kfirmaymon84/KiCadLib/MyLibKiCad/3D/CommonChock1210.step

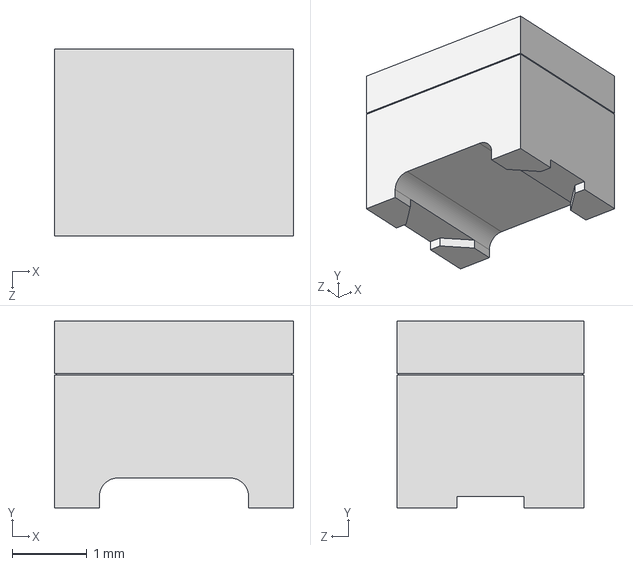
[picture p1: CAD file, 2026-07-02]
MyLibKiCad/3D/CommonChock1210.step
3.20 x 2.50 x 2.50 mm
