kfirmaymon84/KiCadLib/MyLibKiCad/3D/32-VQFN-EP(4x4).step

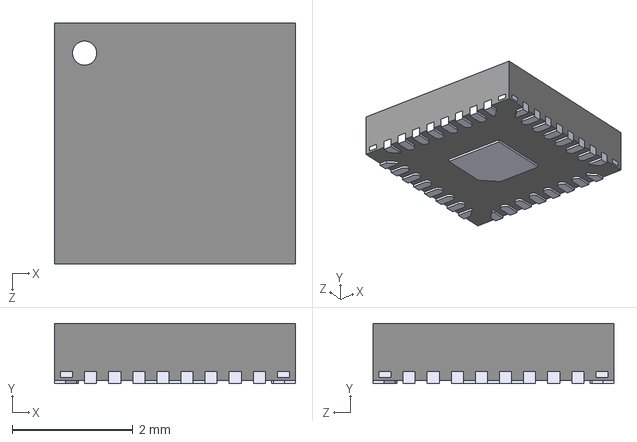
[picture p2: CAD file, 2026-07-02]
MyLibKiCad/3D/32-VQFN-EP(4x4).step
4.00 x 1.00 x 4.00 mm
