kfirmaymon84/KiCadLib/MyLibKiCad/3D/MEM2052-00-195-00-A_revA.STEP

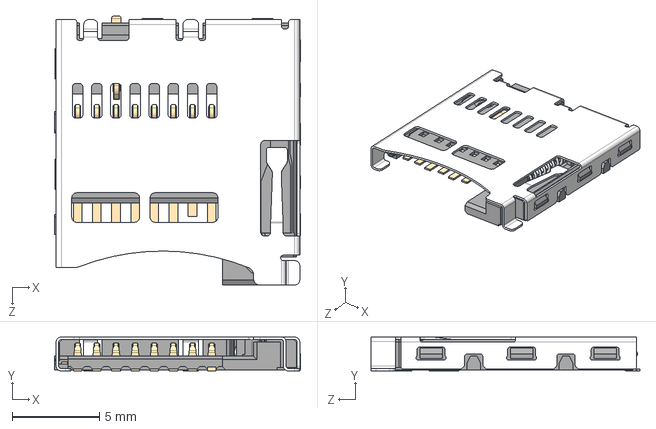
[picture p3: CAD file, 2026-07-02]
MyLibKiCad/3D/MEM2052-00-195-00-A_revA.STEP
14.2 x 1.95 x 15.5 mm
