kfirmaymon84/KiCadLib/MyLibKiCad/3D/RV-3028-C7.stp

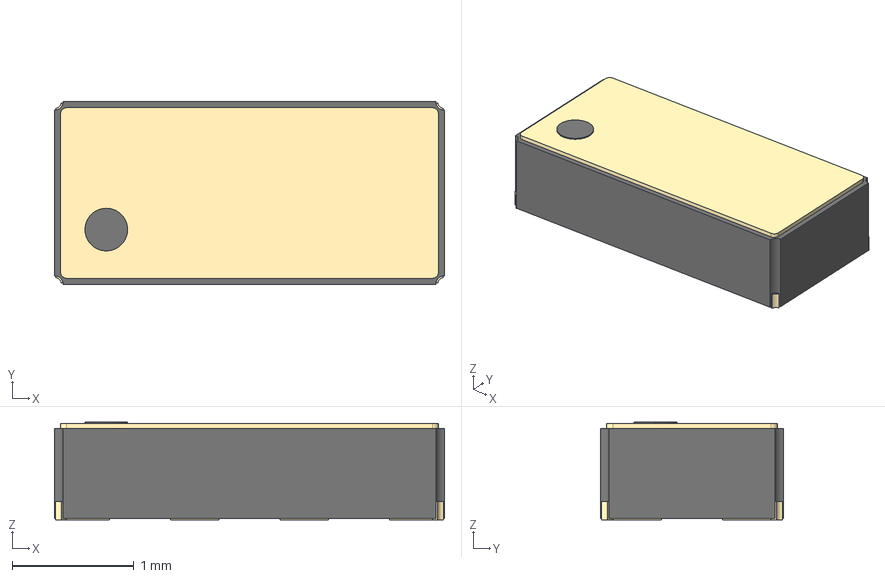
[picture p4: CAD file, 2026-07-02]
MyLibKiCad/3D/RV-3028-C7.stp
3.20 x 1.50 x 0.8 mm
Rect2
Rect3
Rect4
Rect5
Terminal
