kfirmaymon84/KiCadLib/MyLibKiCad/3D/48-LQFP7x7.step

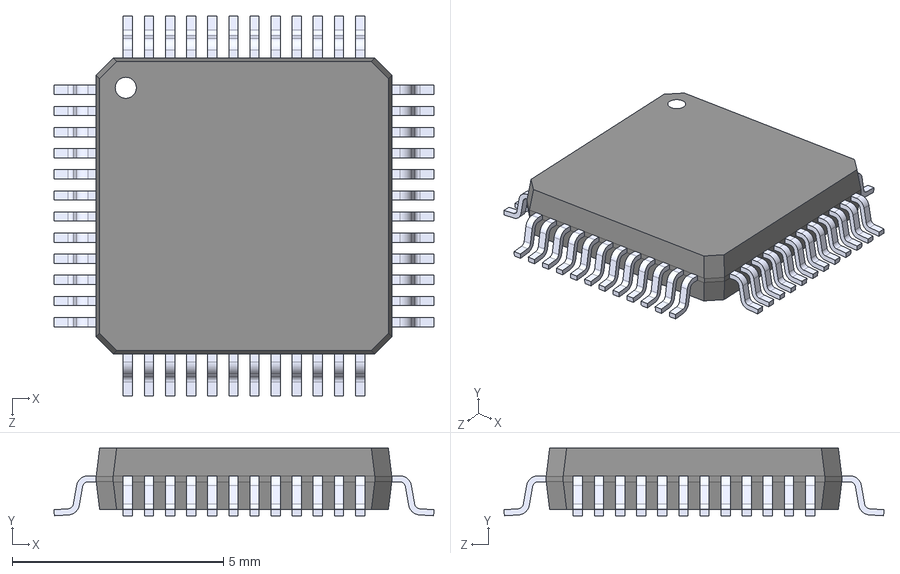
[picture p5: CAD file, 2026-07-02]
MyLibKiCad/3D/48-LQFP7x7.step
9.00 x 1.60 x 9.00 mm
