kfirmaymon84/KiCadLib/MyLibKiCad/3D/BM29B-2DP2-0.35V(53).stp

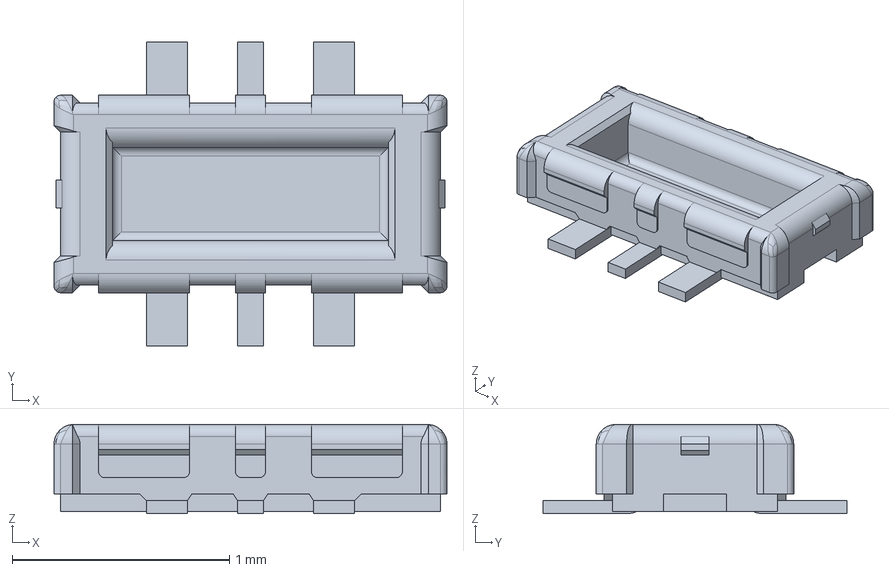
[picture p6: CAD file, 2026-07-02]
MyLibKiCad/3D/BM29B-2DP2-0.35V(53).stp
1.81 x 1.40 x 0.41 mm
