kfirmaymon84/KiCadLib/MyLibKiCad/3D/BM29B0.6-2DS_2-0.35V_51_.step

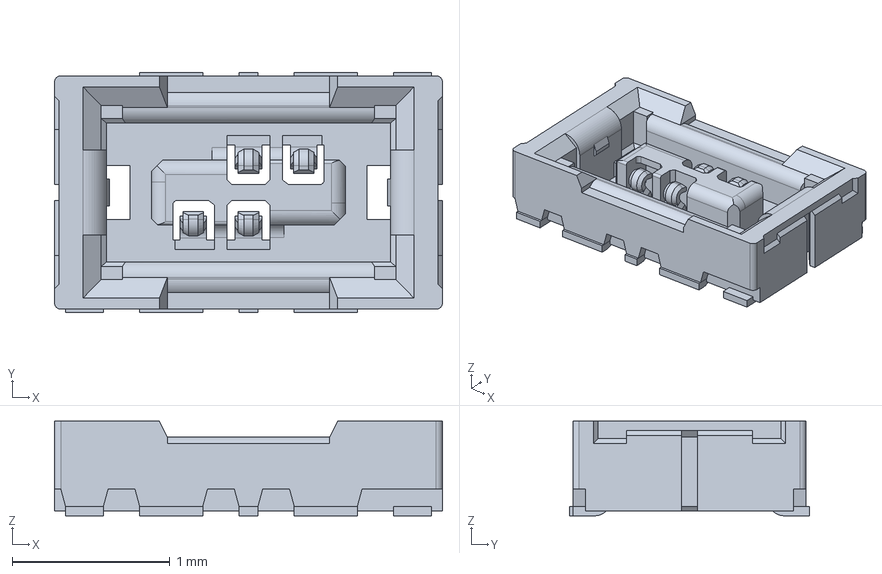
[picture p7: CAD file, 2026-07-02]
MyLibKiCad/3D/BM29B0.6-2DS_2-0.35V_51_.step
2.46 x 1.52 x 0.6 mm
