kfirmaymon84/KiCadLib/MyLibKiCad/3D/64-LQFP (10x10).step

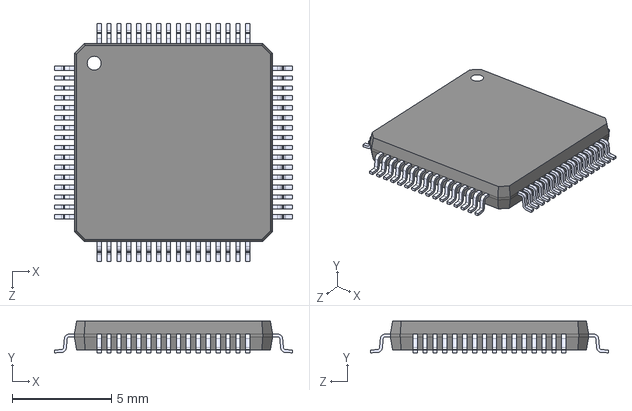
[picture p8: CAD file, 2026-07-02]
MyLibKiCad/3D/64-LQFP (10x10).step
12.0 x 1.60 x 12.0 mm
