kfirmaymon84/KiCadLib/MyLibKiCad/3D/453-00045R.step

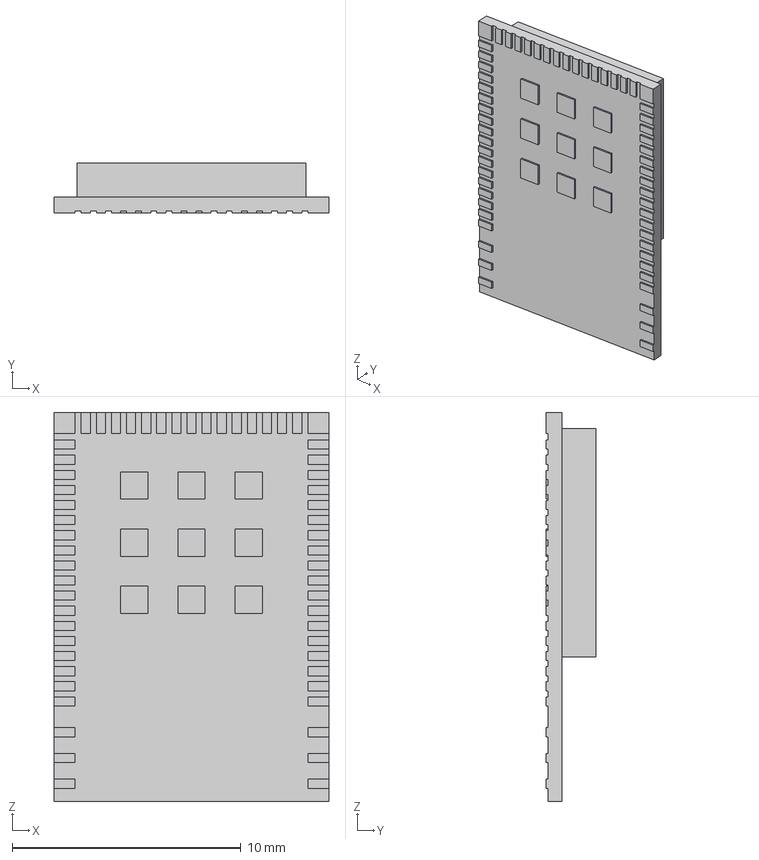
[picture p9: CAD file, 2026-07-02]
MyLibKiCad/3D/453-00045R.step
12.0 x 2.20 x 17.0 mm
