kfirmaymon84/KiCadLib/MyLibKiCad/3D/29-VFQFN.step

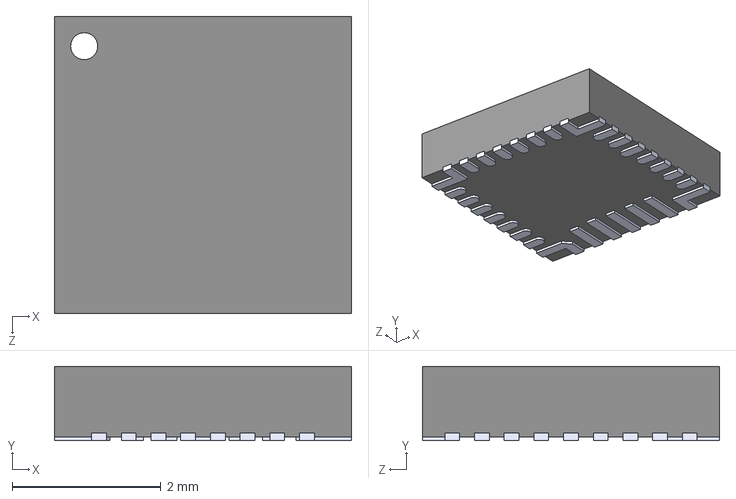
[picture p10: CAD file, 2026-07-02]
MyLibKiCad/3D/29-VFQFN.step
4.00 x 1.00 x 4.00 mm
