kfirmaymon84/KiCadLib/MyLibKiCad/3D/HVSON8_3X3_NXP.step

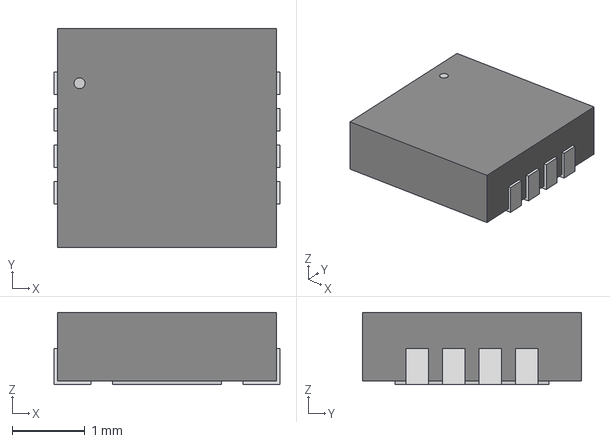
[picture p11: CAD file, 2026-07-02]
MyLibKiCad/3D/HVSON8_3X3_NXP.step
3.10 x 3.00 x 0.993 mm
