kfirmaymon84/KiCadLib/MyLibKiCad/3D/USB4120-03-C_REVA.step

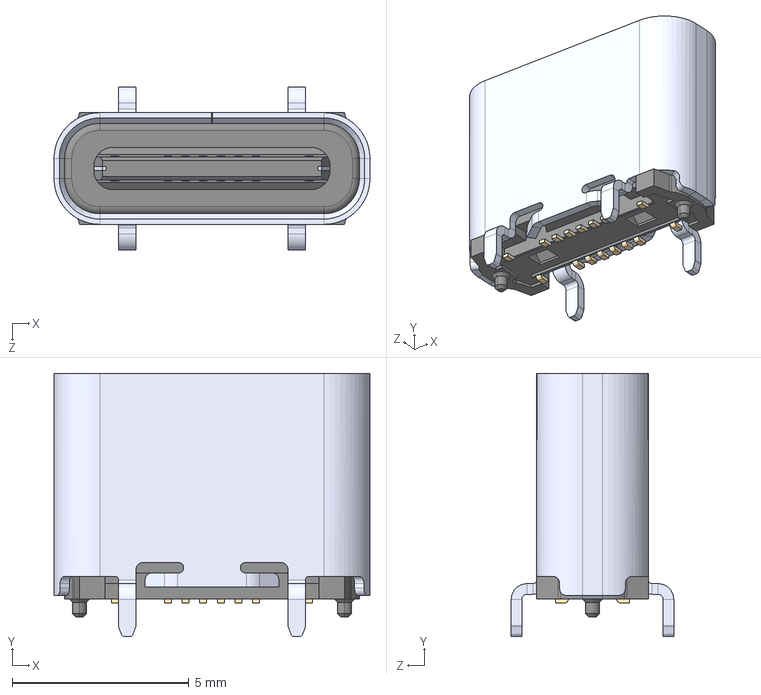
[picture p12: CAD file, 2026-07-02]
MyLibKiCad/3D/USB4120-03-C_REVA.step
8.94 x 7.45 x 4.60 mm
