kfirmaymon84/KiCadLib/MyLibKiCad/3D/S70-138305045.stp

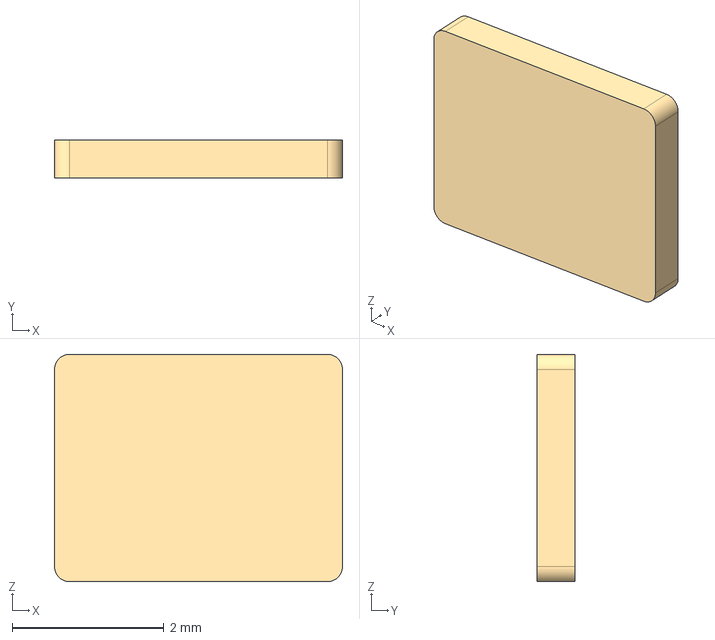
[picture p13: CAD file, 2026-07-02]
MyLibKiCad/3D/S70-138305045.stp
3.80 x 0.5 x 3.00 mm
