kfirmaymon84/KiCadLib/MyLibKiCad/3D/USB4210-GF-A_revA.STEP

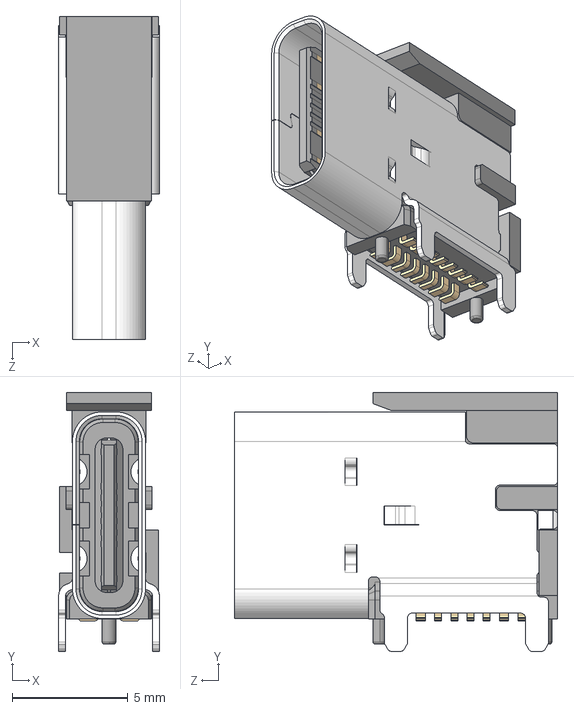
[picture p14: CAD file, 2026-07-02]
MyLibKiCad/3D/USB4210-GF-A_revA.STEP
4.36 x 11.2 x 14.0 mm
hsg_4210
