kfirmaymon84/KiCadLib/MyLibKiCad/3D/USB4105-GF-A-120.step

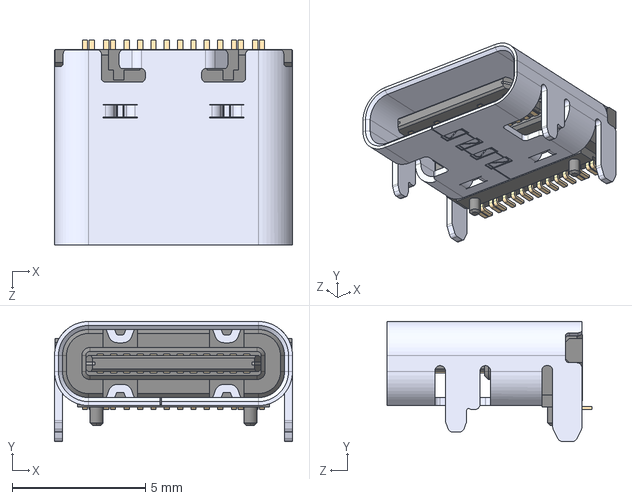
[picture p15: CAD file, 2026-07-02]
MyLibKiCad/3D/USB4105-GF-A-120.step
8.94 x 4.51 x 7.71 mm
