kfirmaymon84/KiCadLib/MyLibKiCad/3D/DF40HC(3.5)-20DS-0.4V(51).STEP

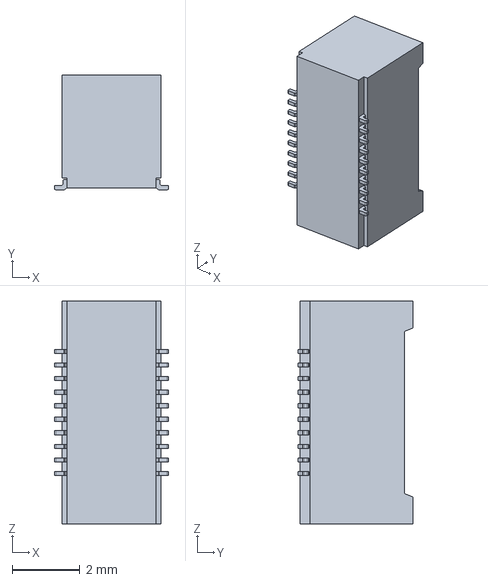
[picture p16: CAD file, 2026-07-02]
MyLibKiCad/3D/DF40HC(3.5)-20DS-0.4V(51).STEP
3.38 x 3.40 x 6.60 mm
