kfirmaymon84/KiCadLib/MyLibKiCad/3D/MINI1126B-P_V5_3D.STEP

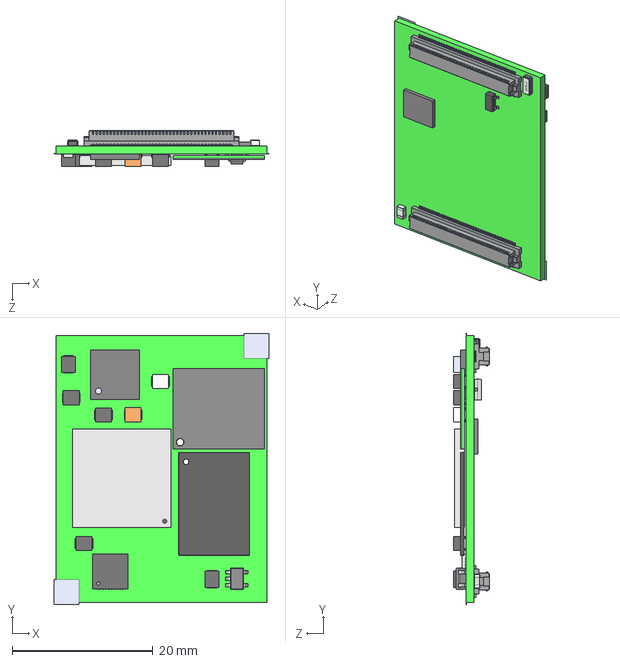
[picture p17: CAD file, 2026-07-02]
MyLibKiCad/3D/MINI1126B-P_V5_3D.STEP
30.6 x 38.6 x 5.16 mm
