kfirmaymon84/KiCadLib/MyLibKiCad/3D/HD107s-2020.step

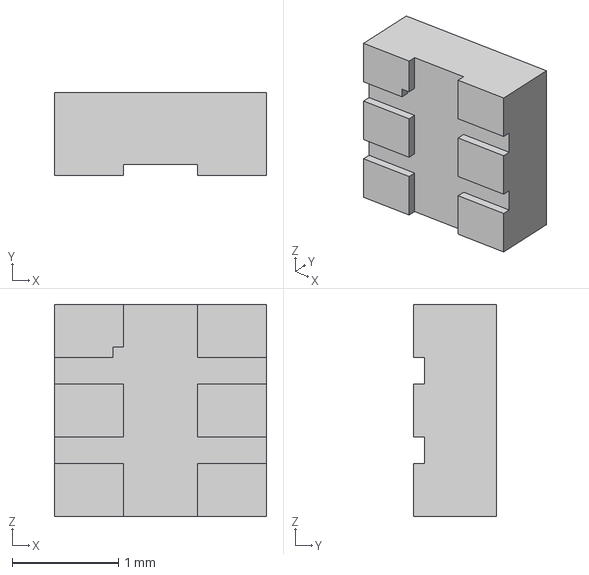
[picture p18: CAD file, 2026-07-02]
MyLibKiCad/3D/HD107s-2020.step
2.00 x 0.78 x 2.00 mm
