kfirmaymon84/KiCadLib/MyLibKiCad/3D/453-00200R.step

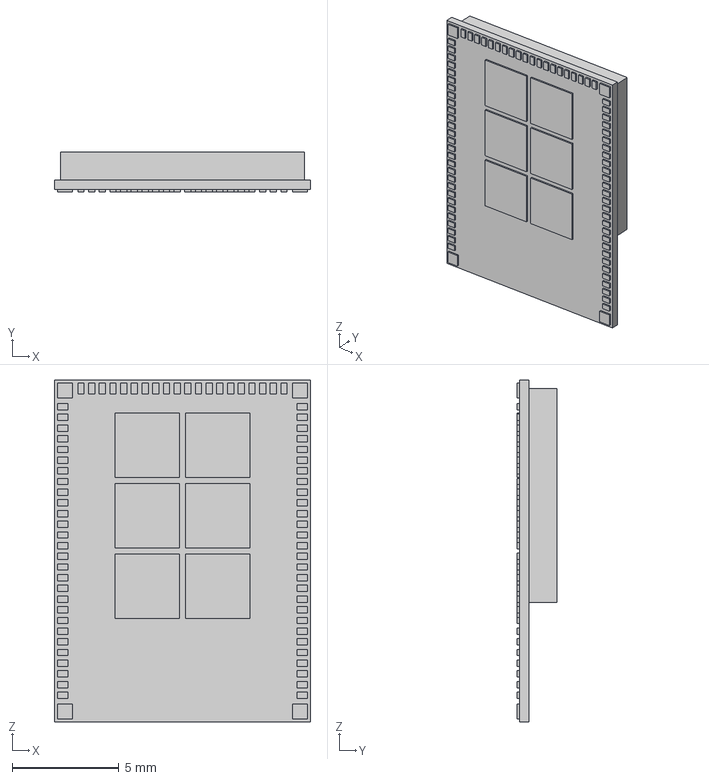
[picture p19: CAD file, 2026-07-02]
MyLibKiCad/3D/453-00200R.step
12.0 x 1.85 x 16.0 mm
