kfirmaymon84/KiCadLib/MyLibKiCad/3D/IND_5x5x4.5H.STEP

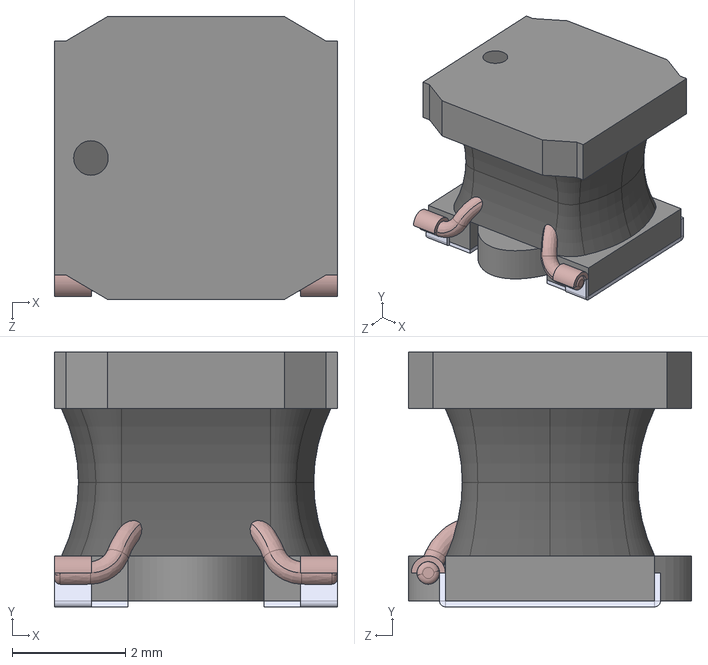
[picture p20: CAD file, 2026-07-02]
MyLibKiCad/3D/IND_5x5x4.5H.STEP
5.00 x 4.50 x 5.00 mm
