kfirmaymon84/KiCadLib/MyLibKiCad/3D/453-00045C.step

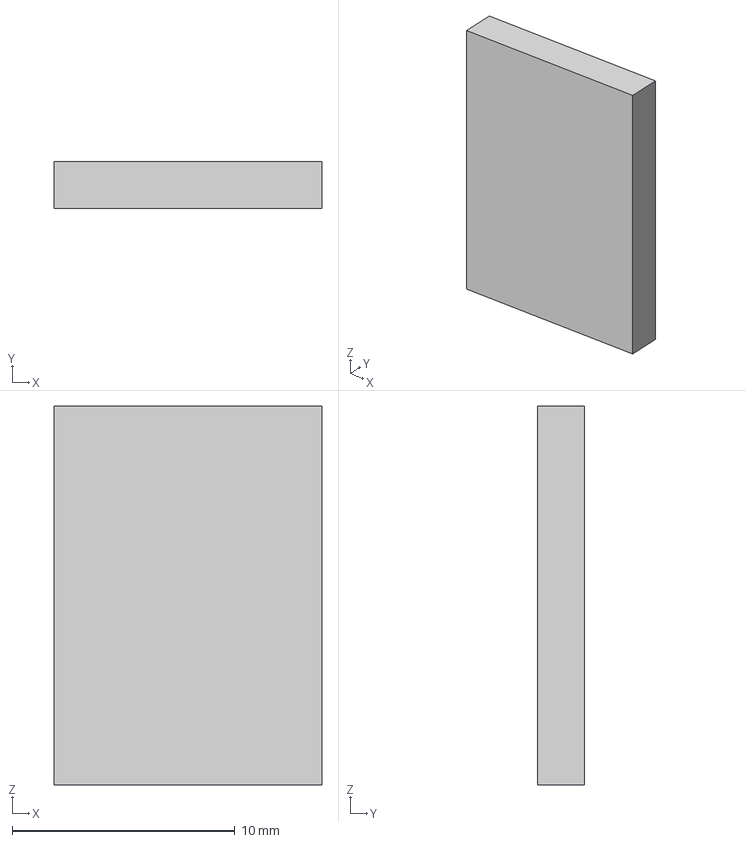
[picture p21: CAD file, 2026-07-02]
MyLibKiCad/3D/453-00045C.step
12.0 x 2.10 x 17.0 mm
