kfirmaymon84/KiCadLib/MyLibKiCad/3D/CM1126B-P_V2 3D V3.STEP

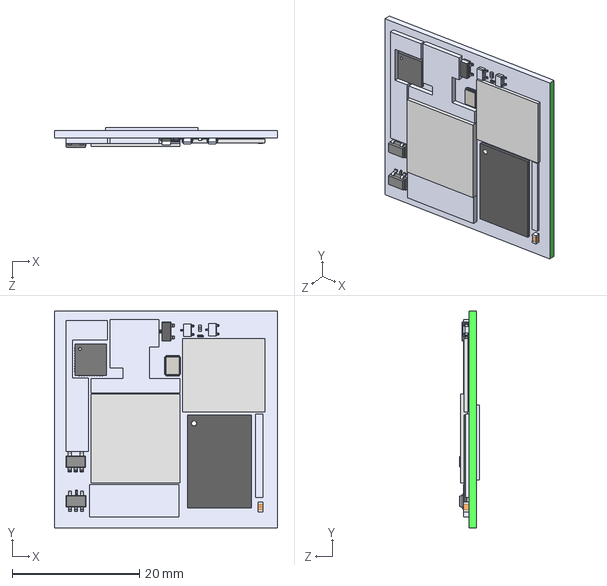
[picture p22: CAD file, 2026-07-02]
MyLibKiCad/3D/CM1126B-P_V2 3D V3.STEP
35.0 x 34.0 x 3.09 mm
