kfirmaymon84/KiCadLib/MyLibKiCad/3D/USB4155-03-C_REVA.step

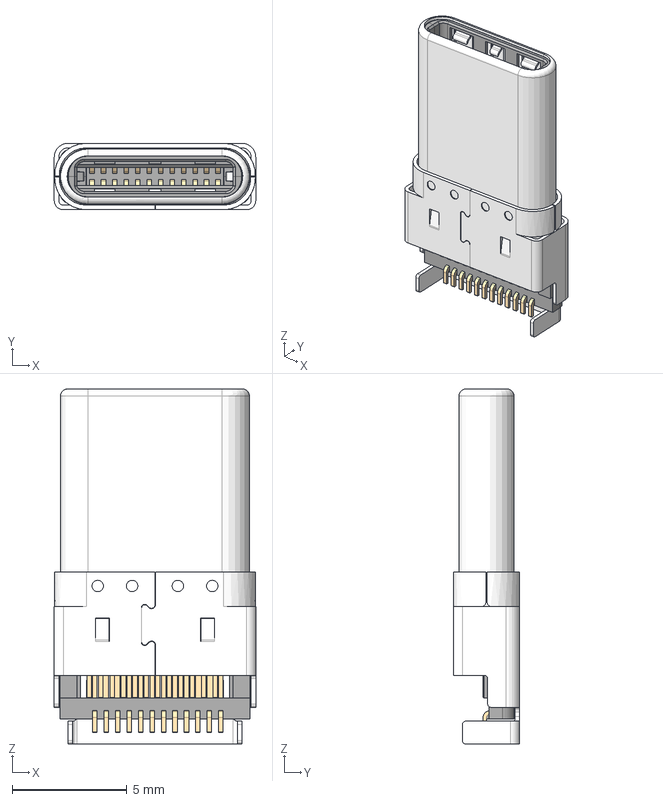
[picture p23: CAD file, 2026-07-02]
MyLibKiCad/3D/USB4155-03-C_REVA.step
8.80 x 2.90 x 15.5 mm
ÊäÈë1 x 7
ÇÐ³ý-ÀÉì2
