kfirmaymon84/KiCadLib/MyLibKiCad/3D/26-WQFN-HR (4x3.5).stp

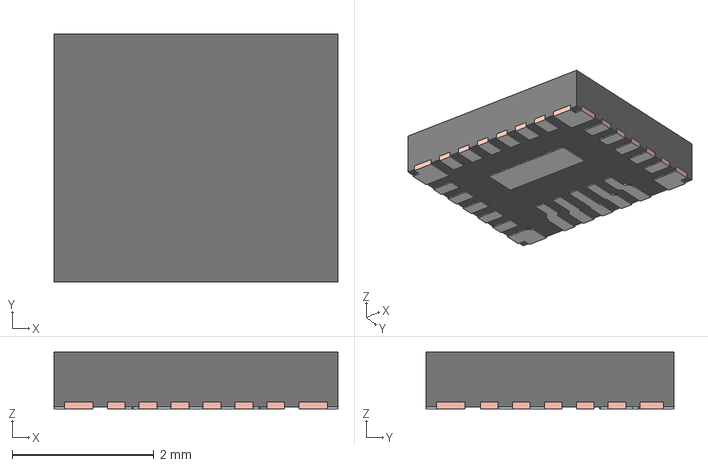
[picture p24: CAD file, 2026-07-02]
MyLibKiCad/3D/26-WQFN-HR (4x3.5).stp
4.00 x 3.50 x 0.8 mm
RBA0026A_FRAME
RBA0026A_MOLD
