kfirmaymon84/KiCadLib/MyLibKiCad/3D/3221-10-0300-00.STP

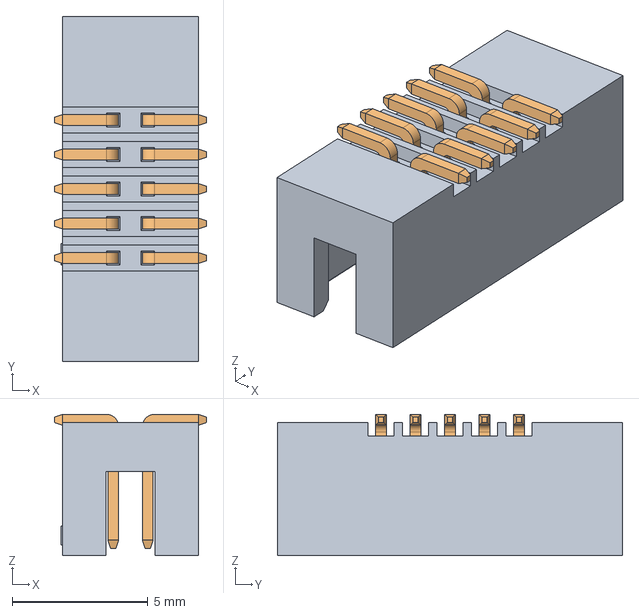
[picture p25: CAD file, 2026-07-02]
MyLibKiCad/3D/3221-10-0300-00.STP
5.60 x 12.7 x 5.20 mm
801-2195-10-K
2195SM-PIN x 10
