kfirmaymon84/KiCadLib/MyLibKiCad/3D/IND_6.6x6.4x3.1.stp

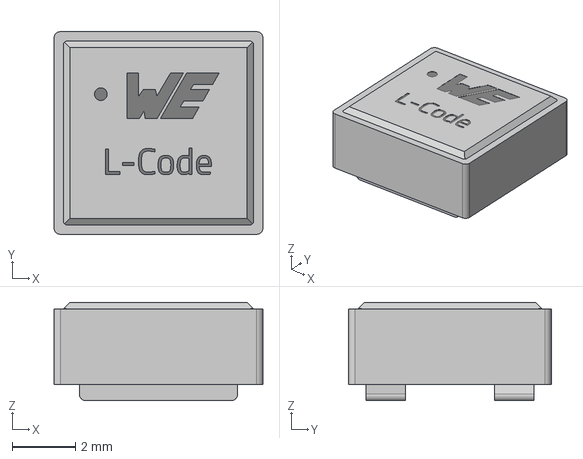
[picture p26: CAD file, 2026-07-02]
MyLibKiCad/3D/IND_6.6x6.4x3.1.stp
6.60 x 6.40 x 3.10 mm
