kfirmaymon84/KiCadLib/MyLibKiCad/3D/100-TFBGA.STEP

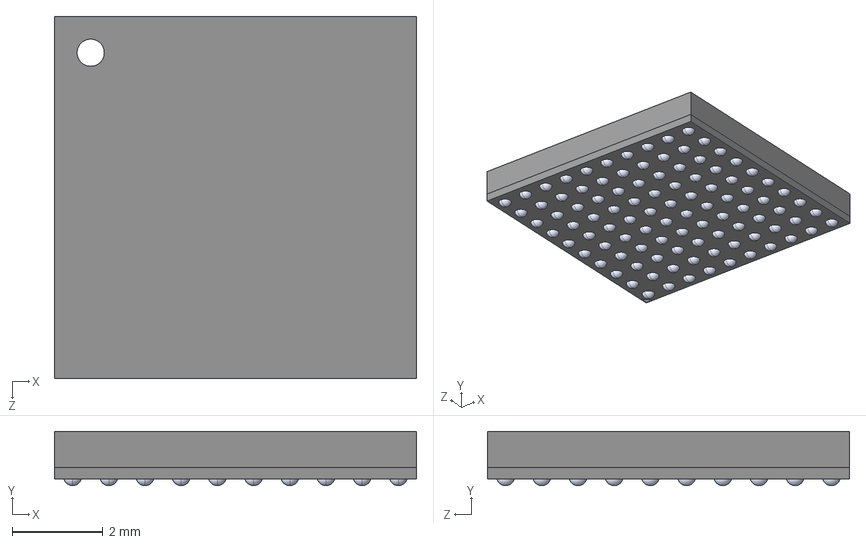
[picture p27: CAD file, 2026-07-02]
MyLibKiCad/3D/100-TFBGA.STEP
8.00 x 1.20 x 8.00 mm
