kfirmaymon84/KiCadLib/MyLibKiCad/3D/DF40C-20DP-0.4V_51_.step

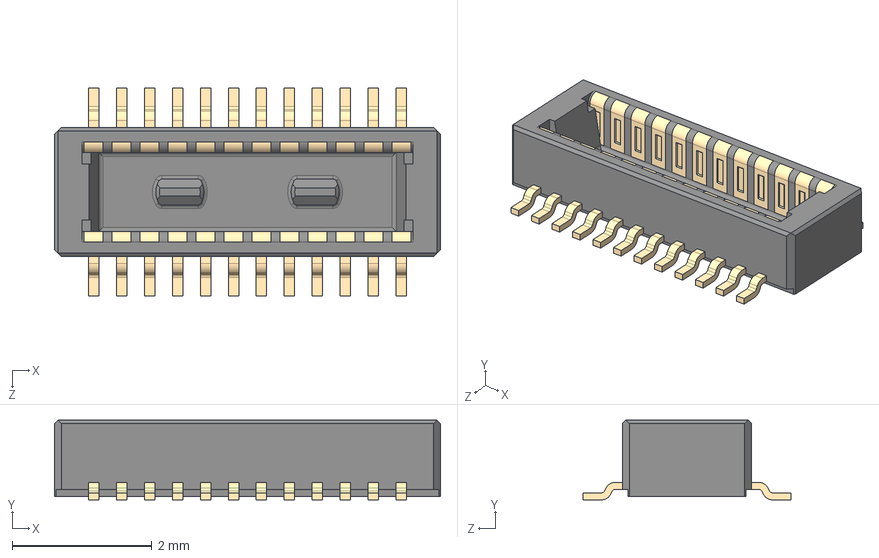
[picture p28: CAD file, 2026-07-02]
MyLibKiCad/3D/DF40C-20DP-0.4V_51_.step
5.52 x 1.14 x 2.97 mm
