kfirmaymon84/KiCadLib/MyLibKiCad/3D/CRY_2.5x2mm.step

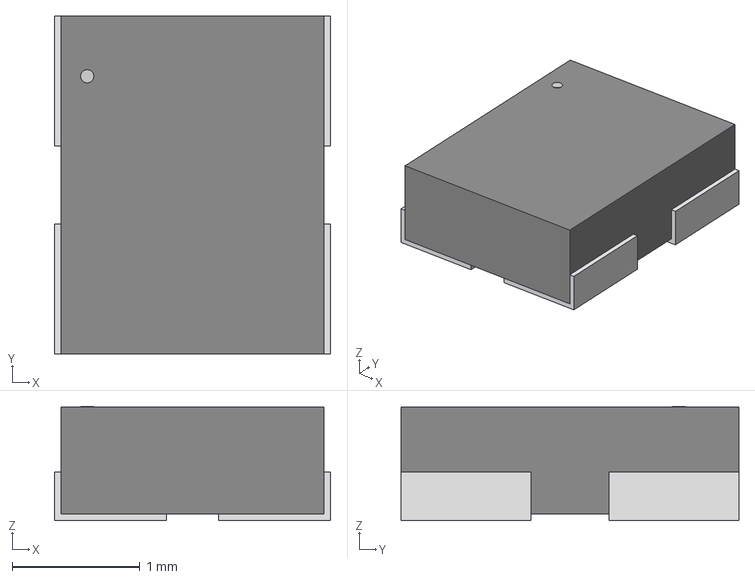
[picture p29: CAD file, 2026-07-02]
MyLibKiCad/3D/CRY_2.5x2mm.step
2.16 x 2.64 x 0.892 mm
