kfirmaymon84/KiCadLib/MyLibKiCad/3D/USB4130-GF-C.stp

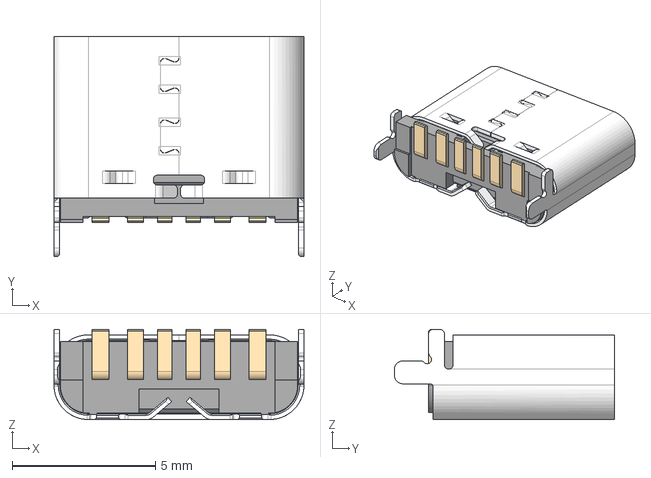
[picture p30: CAD file, 2026-07-02]
MyLibKiCad/3D/USB4130-GF-C.stp
8.74 x 7.70 x 3.15 mm
