kfirmaymon84/KiCadLib/MyLibKiCad/3D/32-QFN (5x5).step

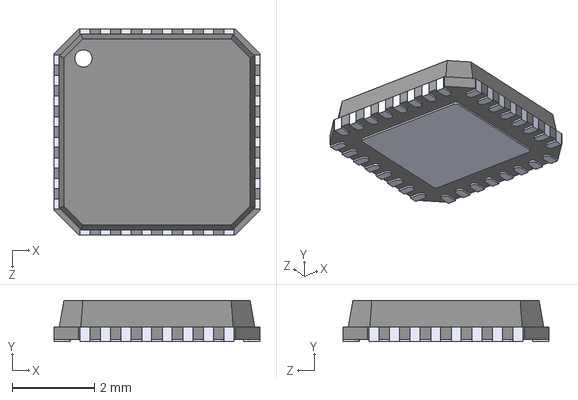
[picture p31: CAD file, 2026-07-02]
MyLibKiCad/3D/32-QFN (5x5).step
5.00 x 1.00 x 5.00 mm
