kfirmaymon84/KiCadLib/MyLibKiCad/3D/BAT-HLD-002-SMT.step

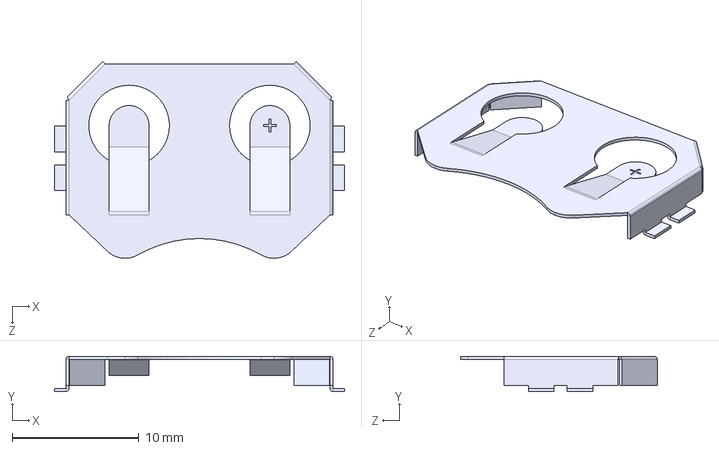
[picture p32: CAD file, 2026-07-02]
MyLibKiCad/3D/BAT-HLD-002-SMT.step
22.9 x 2.79 x 15.5 mm
