kfirmaymon84/KiCadLib/MyLibKiCad/3D/IND_6.65x6.65x3.3.stp

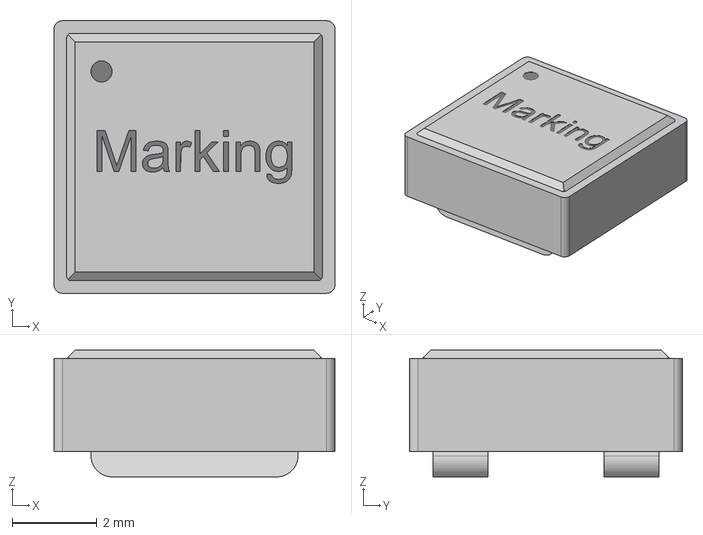
[picture p33: CAD file, 2026-07-02]
MyLibKiCad/3D/IND_6.65x6.65x3.3.stp
6.65 x 6.45 x 3.00 mm
