kfirmaymon84/KiCadLib/MyLibKiCad/3D/IND4x4_3H.stp

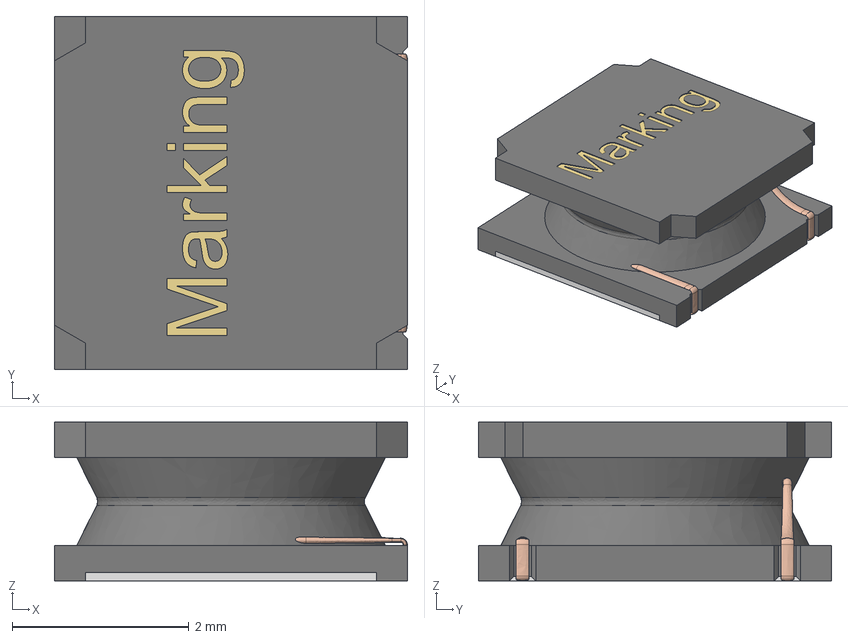
[picture p34: CAD file, 2026-07-02]
MyLibKiCad/3D/IND4x4_3H.stp
4.00 x 4.00 x 1.80 mm
