kfirmaymon84/KiCadLib/MyLibKiCad/3D/XLamp Element.step

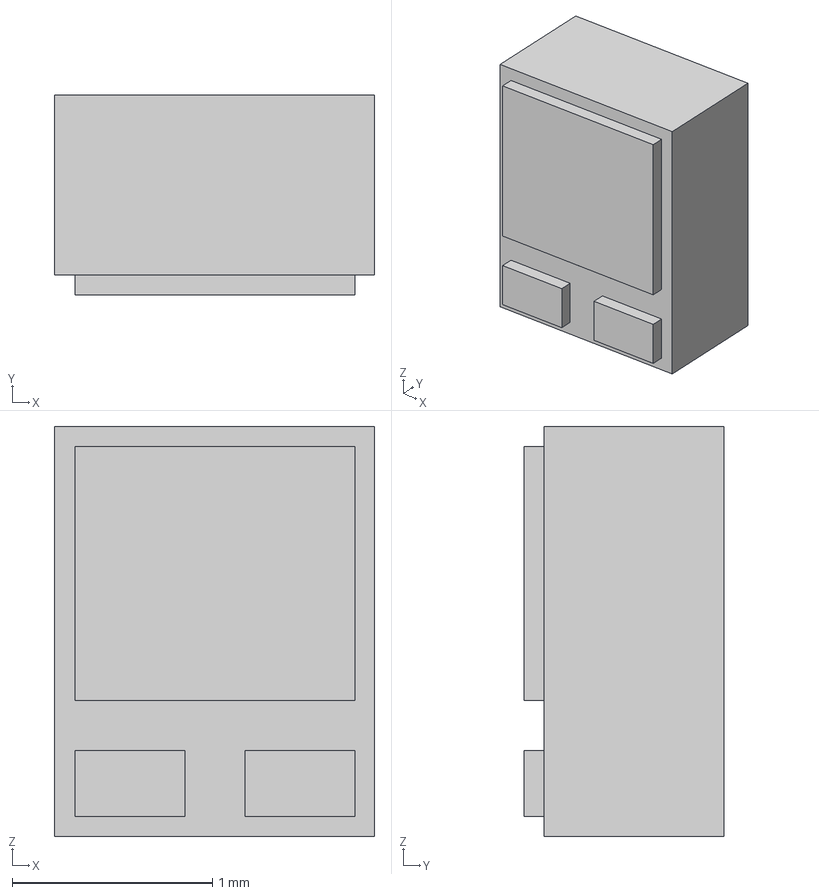
[picture p35: CAD file, 2026-07-02]
MyLibKiCad/3D/XLamp Element.step
1.60 x 1.00 x 2.05 mm
