kfirmaymon84/KiCadLib/MyLibKiCad/3D/8-TDFN(3x3).step

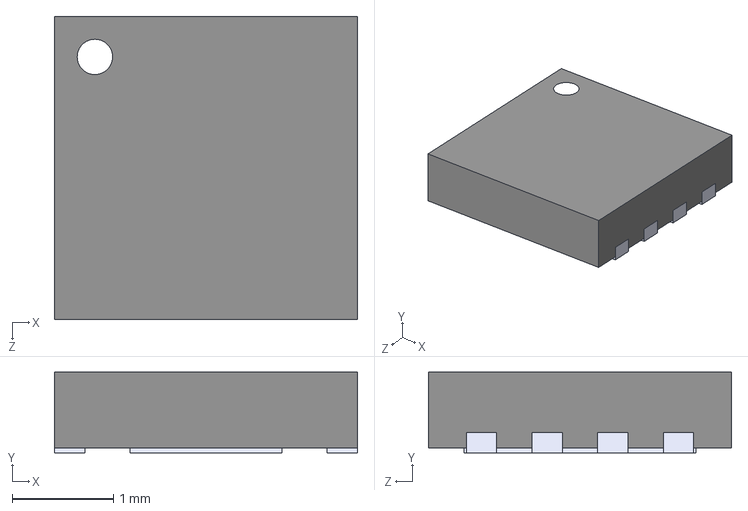
[picture p36: CAD file, 2026-07-02]
MyLibKiCad/3D/8-TDFN(3x3).step
3.00 x 0.8 x 3.00 mm
