kfirmaymon84/KiCadLib/MyLibKiCad/3D/IND_0603.step

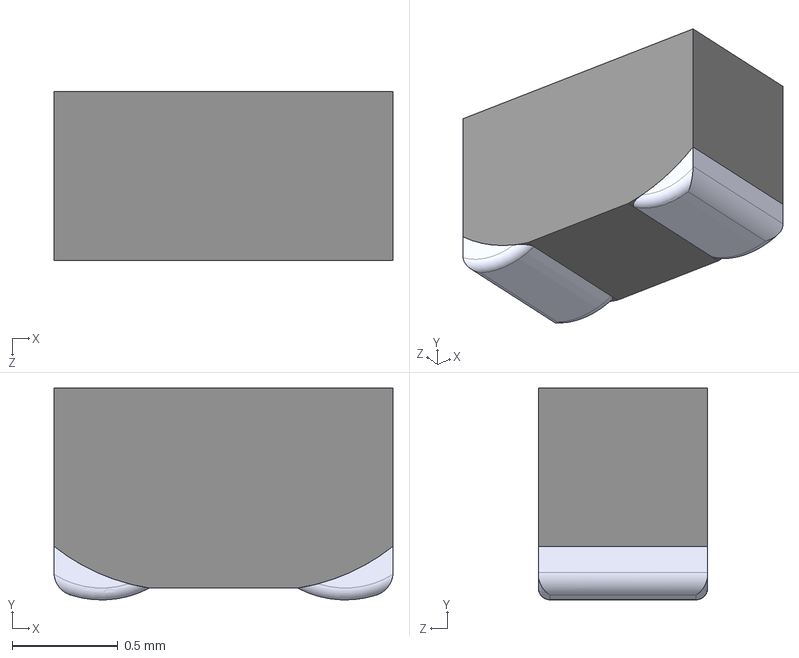
[picture p37: CAD file, 2026-07-02]
MyLibKiCad/3D/IND_0603.step
1.60 x 1 x 0.8 mm
