kfirmaymon84/KiCadLib/MyLibKiCad/3D/XLAMP-XPGR.step

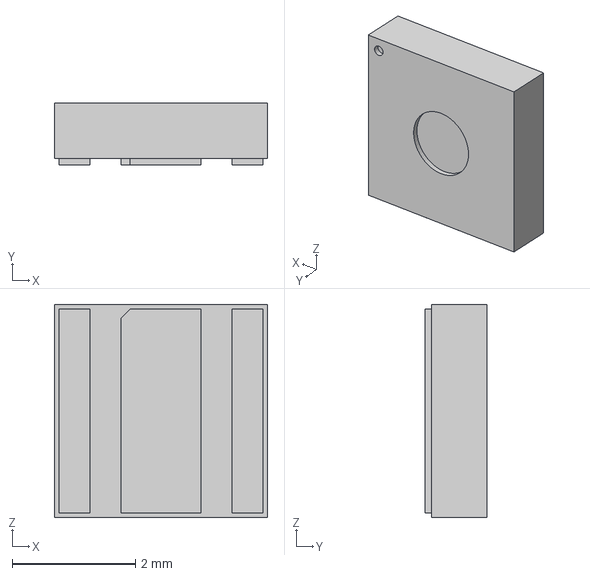
[picture p38: CAD file, 2026-07-02]
MyLibKiCad/3D/XLAMP-XPGR.step
3.45 x 1.00 x 3.45 mm
