kfirmaymon84/KiCadLib/MyLibKiCad/3D/20-WQFN (4x3).step

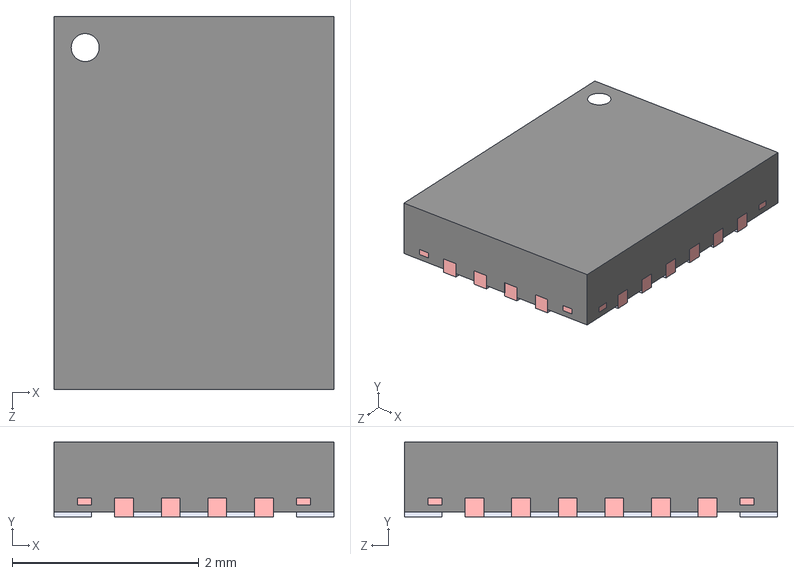
[picture p39: CAD file, 2025-10-23]
MyLibKiCad/3D/20-WQFN (4x3).step
3.00 x 0.8 x 4.00 mm
