kfirmaymon84/KiCadLib/MyLibKiCad/3D/10-VQFN-HR (2x2) (2).step

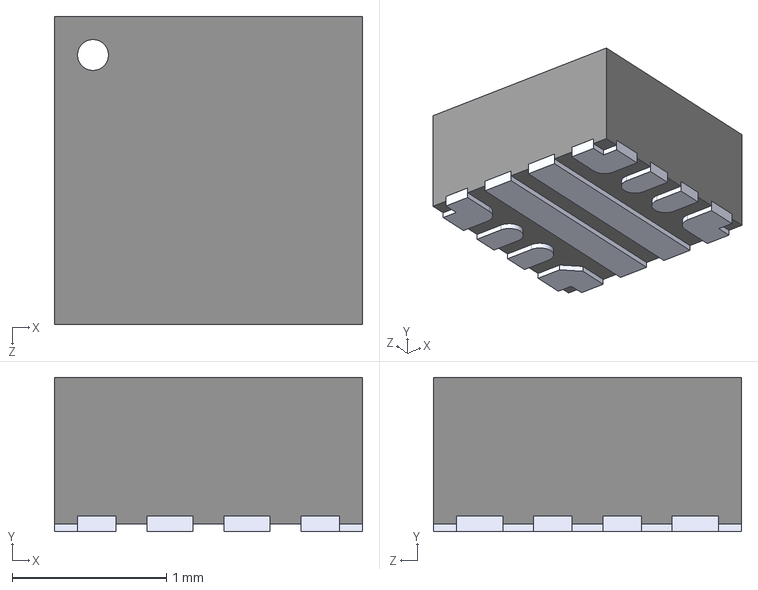
[picture p40: CAD file, 2025-10-23]
MyLibKiCad/3D/10-VQFN-HR (2x2) (2).step
2.00 x 1.00 x 2.00 mm
