kfirmaymon84/KiCadLib/MyLibKiCad/3D/IND1007(2518 Metric).step

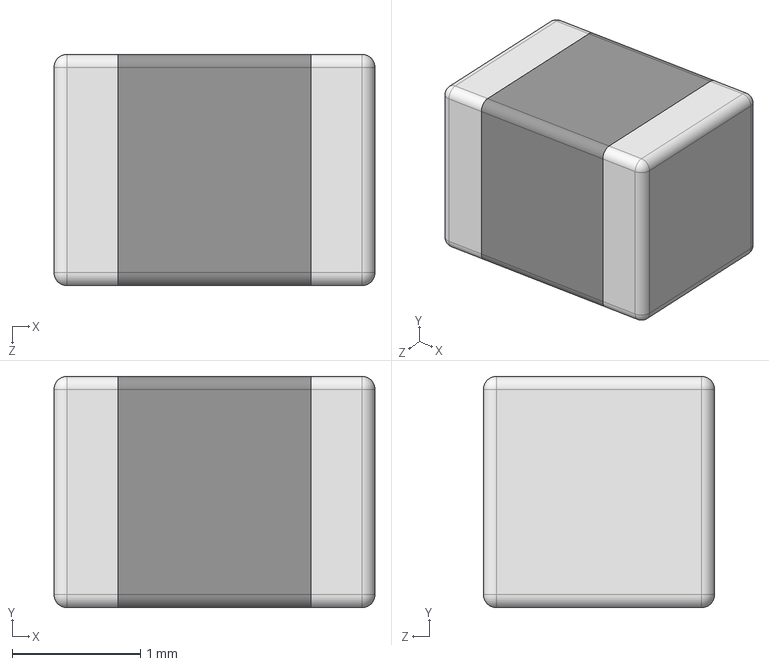
[picture p41: CAD file, 2025-09-28]
MyLibKiCad/3D/IND1007(2518 Metric).step
2.50 x 1.80 x 1.80 mm
