kfirmaymon84/KiCadLib/MyLibKiCad/3D/BL-R8723DS1.step

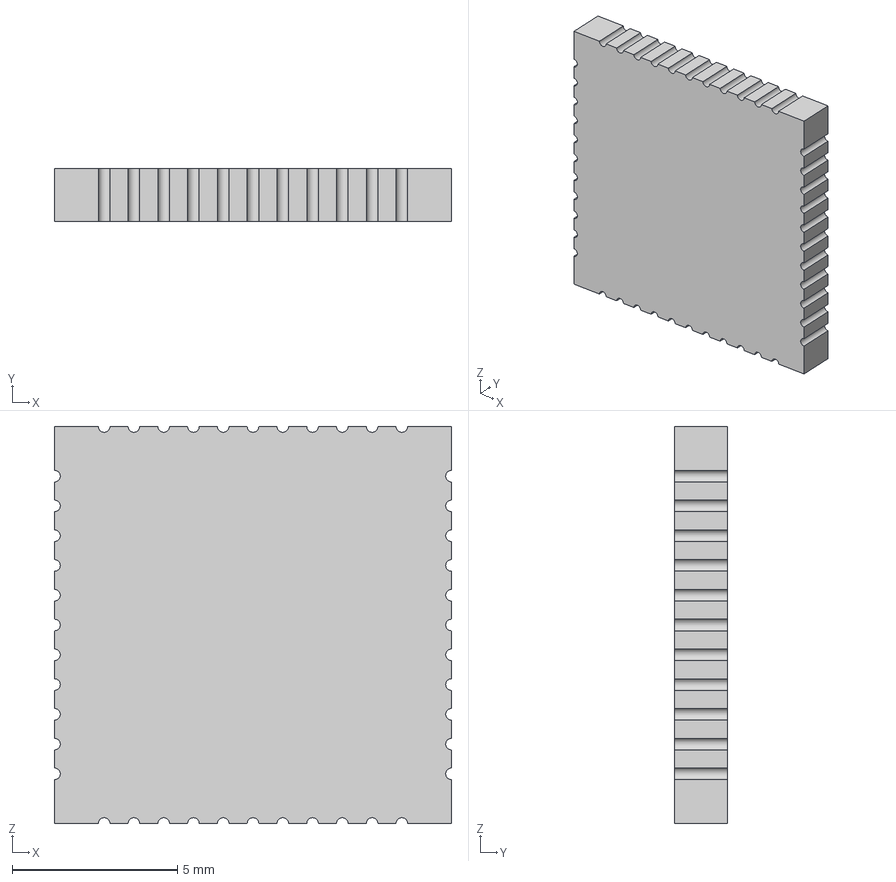
[picture p42: CAD file, 2025-09-28]
MyLibKiCad/3D/BL-R8723DS1.step
12.0 x 1.60 x 12.0 mm
