kfirmaymon84/KiCadLib/MyLibKiCad/3D/DM3D-SF.step

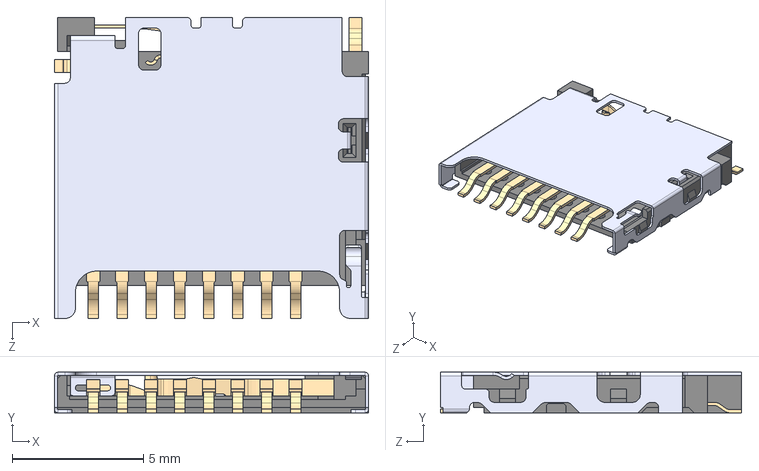
[picture p43: CAD file, 2025-09-28]
MyLibKiCad/3D/DM3D-SF.step
12.0 x 1.55 x 11.5 mm
