kfirmaymon84/KiCadLib/MyLibKiCad/3D/TSOT-23-6.step

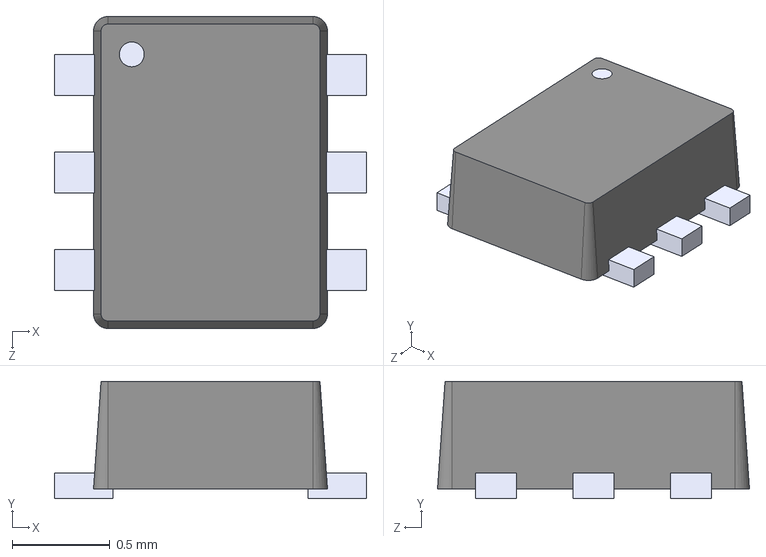
[picture p44: CAD file, 2025-09-28]
MyLibKiCad/3D/TSOT-23-6.step
1.60 x 0.6 x 1.60 mm
