kfirmaymon84/KiCadLib/MyLibKiCad/3D/TS-1088-AR02016--3DModel-STEP-269445.STEP

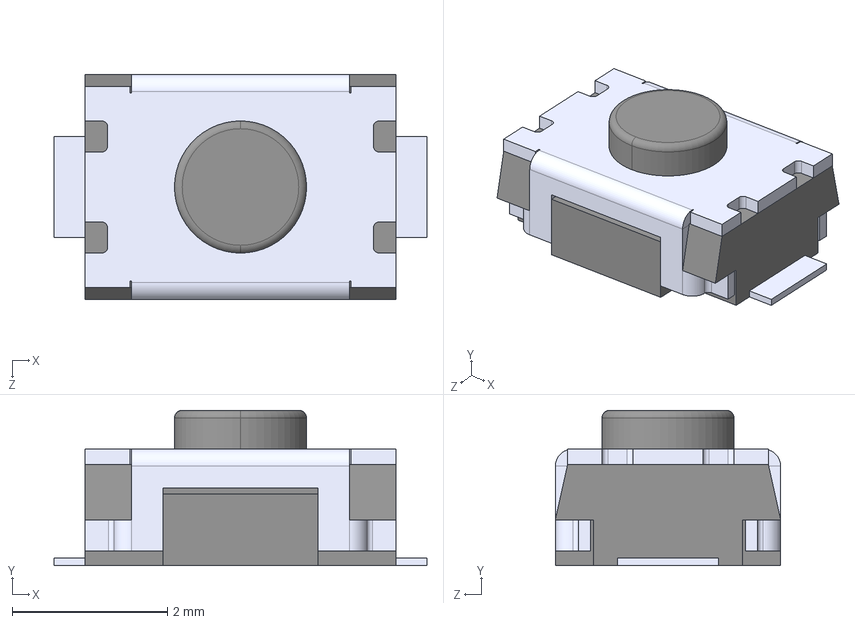
[picture p45: CAD file, 2025-09-28]
MyLibKiCad/3D/TS-1088-AR02016--3DModel-STEP-269445.STEP
4.80 x 2.00 x 2.90 mm
