kfirmaymon84/KiCadLib/MyLibKiCad/3D/DF12NC_3.0_-80DP-0.5V_51_.step

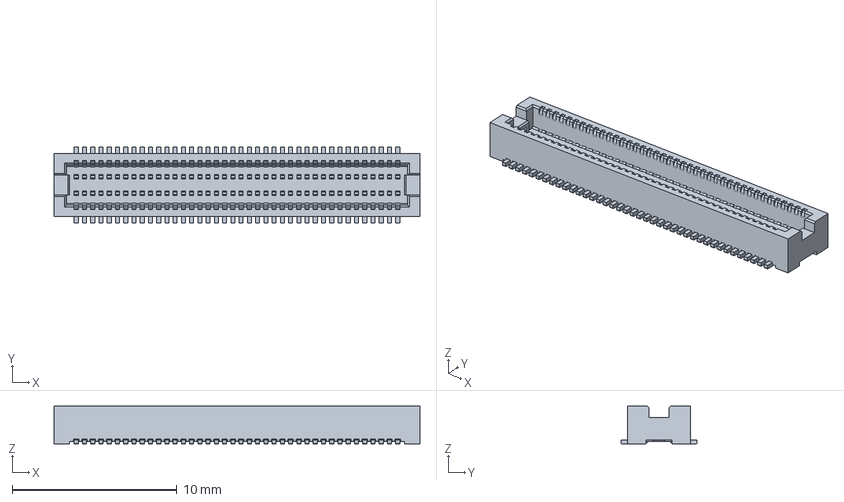
[picture p46: CAD file, 2025-09-28]
MyLibKiCad/3D/DF12NC_3.0_-80DP-0.5V_51_.step
22.2 x 4.60 x 2.30 mm
