kfirmaymon84/KiCadLib/MyLibKiCad/3D/LED_0505 (1313 Metric).stp

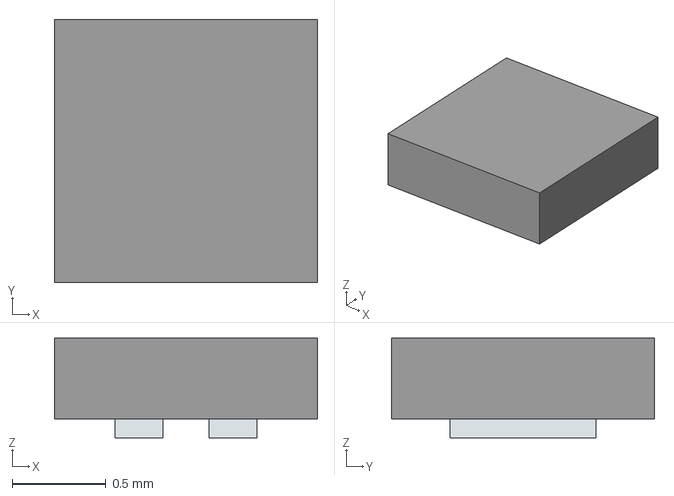
[picture p47: CAD file, 2025-09-28]
MyLibKiCad/3D/LED_0505 (1313 Metric).stp
1.40 x 1.40 x 0.53 mm
Pins
