kfirmaymon84/KiCadLib/MyLibKiCad/3D/16-QSOP.step

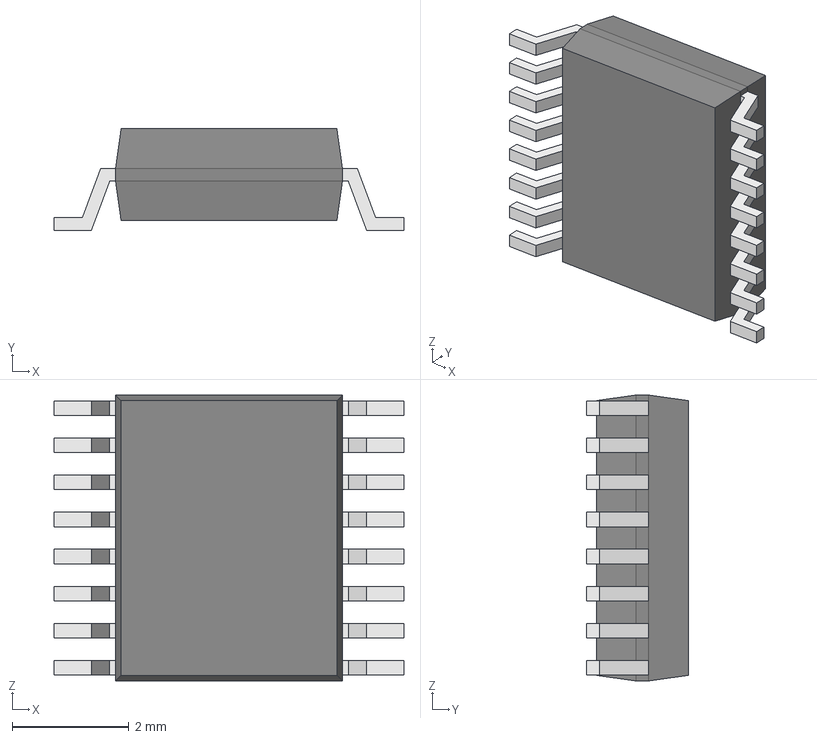
[picture p48: CAD file, 2025-09-28]
MyLibKiCad/3D/16-QSOP.step
6.00 x 1.75 x 4.90 mm
Body001 (Mirror #1) x 8
