kfirmaymon84/KiCadLib/MyLibKiCad/3D/XTAL_(3.2x2.5mm)_SMD.step

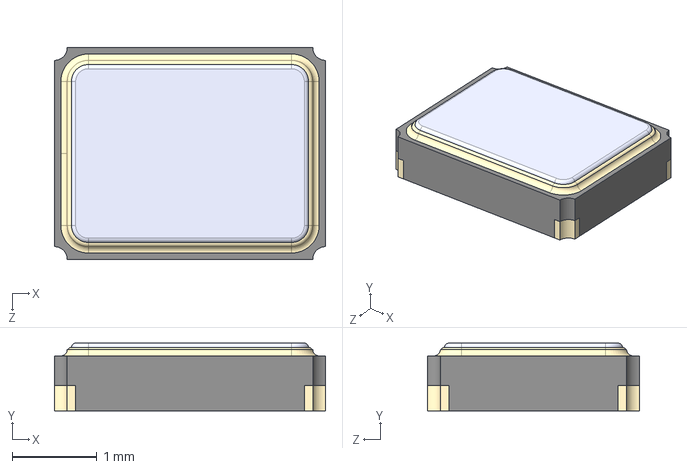
[picture p49: CAD file, 2025-09-28]
MyLibKiCad/3D/XTAL_(3.2x2.5mm)_SMD.step
3.20 x 0.8 x 2.50 mm
