kfirmaymon84/KiCadLib/MyLibKiCad/3D/srn8040.stp

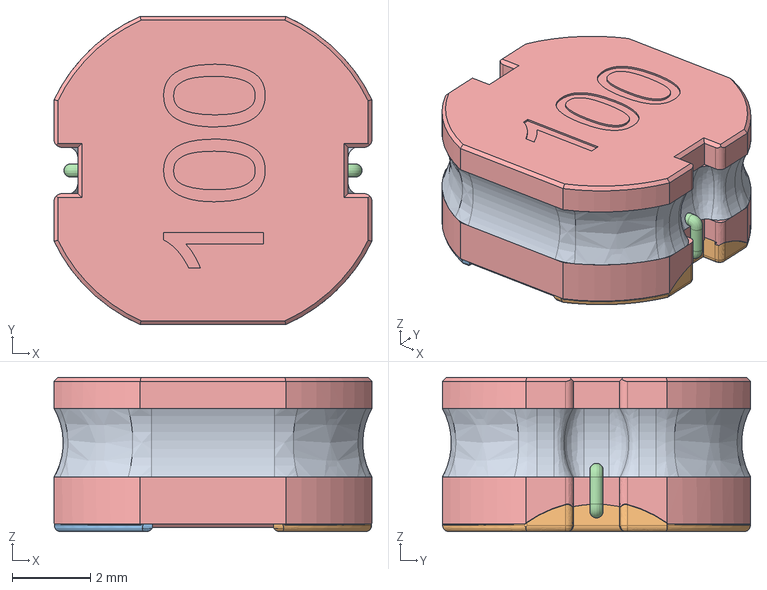
[picture p50: CAD file, 2025-09-28]
MyLibKiCad/3D/srn8040.stp
8.15 x 7.90 x 3.95 mm
