kfirmaymon84/KiCadLib/MyLibKiCad/3D/CAP_(6.6x6.6mm)5.8H.stp

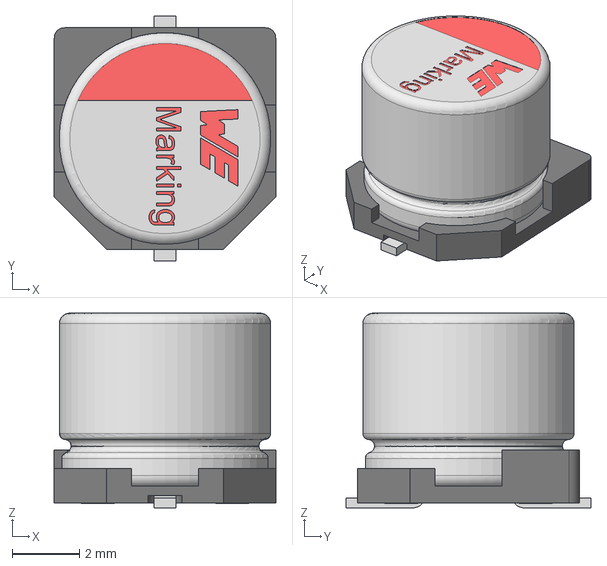
[picture p51: CAD file, 2025-09-28]
MyLibKiCad/3D/CAP_(6.6x6.6mm)5.8H.stp
6.60 x 7.30 x 5.80 mm
Base_Φ6_3Capacitor
capicitor_6.3x5.8x2.2
