kfirmaymon84/KiCadLib/MyLibKiCad/3D/16-TSSOP(4.40mm).STEP

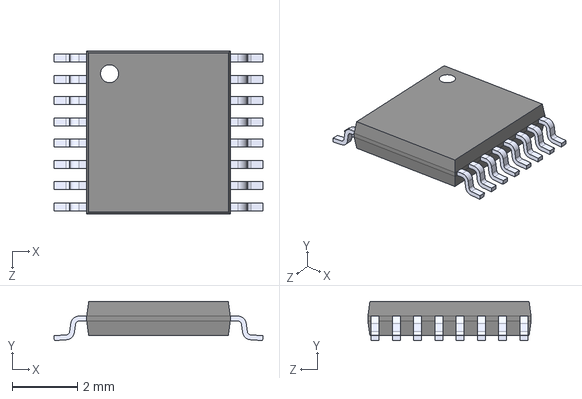
[picture p52: CAD file, 2025-09-28]
MyLibKiCad/3D/16-TSSOP(4.40mm).STEP
6.40 x 1.20 x 5.00 mm
