kfirmaymon84/KiCadLib/MyLibKiCad/3D/10-UQFN (2.0x1.5).step

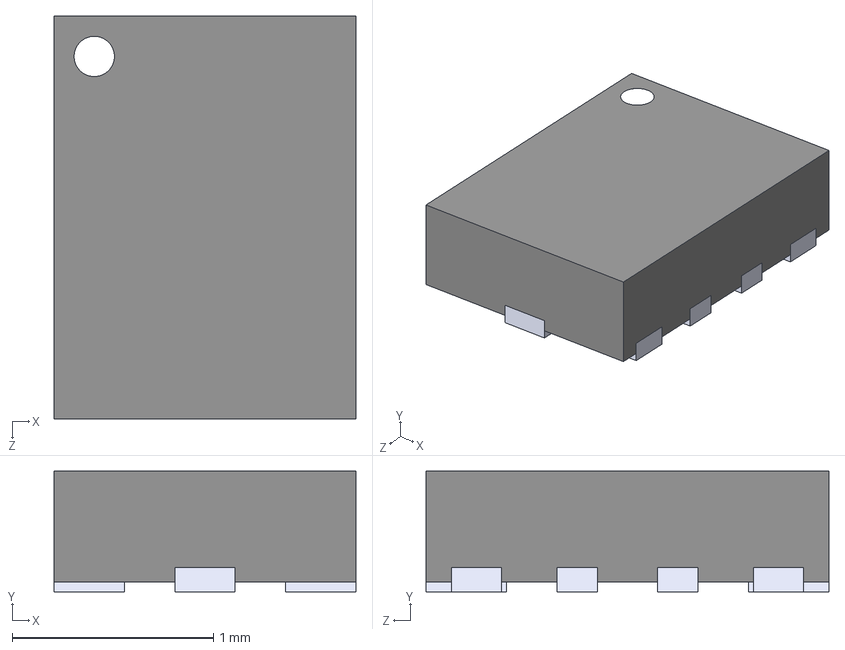
[picture p53: CAD file, 2025-09-28]
MyLibKiCad/3D/10-UQFN (2.0x1.5).step
1.50 x 0.6 x 2.00 mm
