kfirmaymon84/KiCadLib/MyLibKiCad/3D/XTAL_(2x1.6mm)_SMD.step

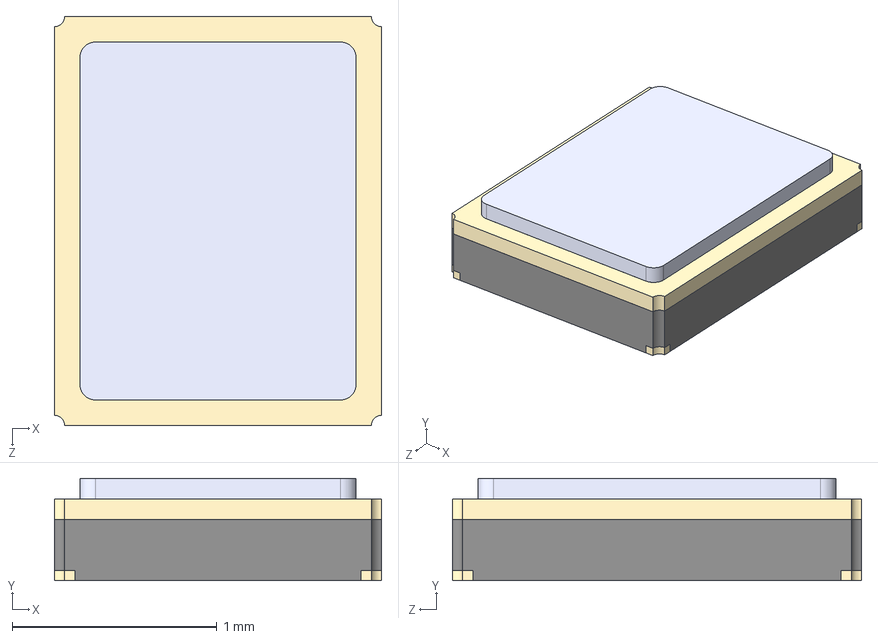
[picture p54: CAD file, 2025-09-28]
MyLibKiCad/3D/XTAL_(2x1.6mm)_SMD.step
1.60 x 0.5 x 2.00 mm
