kfirmaymon84/KiCadLib/MyLibKiCad/3D/SOT-323.step

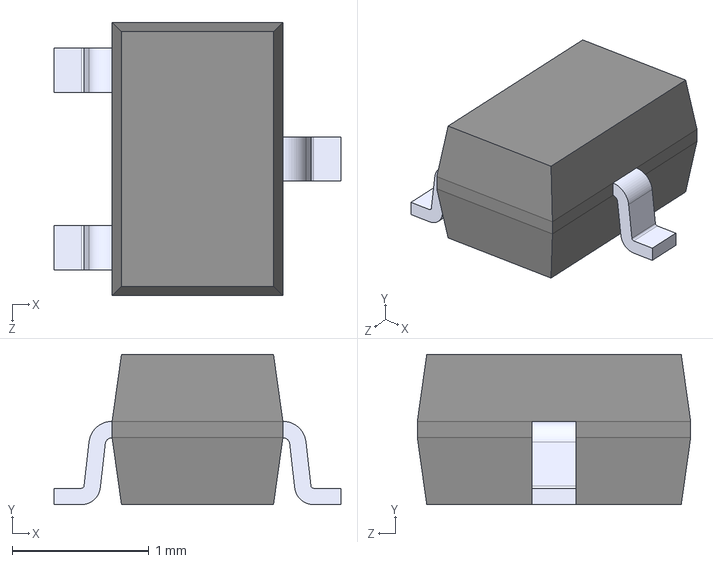
[picture p55: CAD file, 2025-09-28]
MyLibKiCad/3D/SOT-323.step
2.10 x 1.10 x 2.00 mm
