kfirmaymon84/KiCadLib/MyLibKiCad/3D/KW_HHL631.TK-6SSB-6L07M0-2686.stp

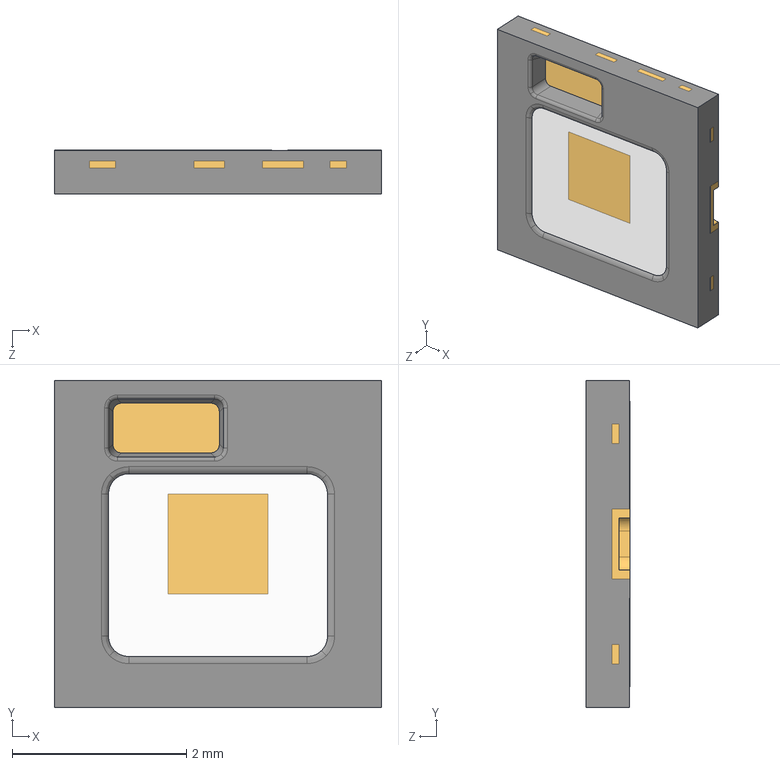
[picture p56: CAD file, 2025-07-14]
MyLibKiCad/3D/KW_HHL631.TK-6SSB-6L07M0-2686.stp
3.75 x 3.75 x 0.5 mm
