kfirmaymon84/KiCadLib/MyLibKiCad/3D/UM232R.step

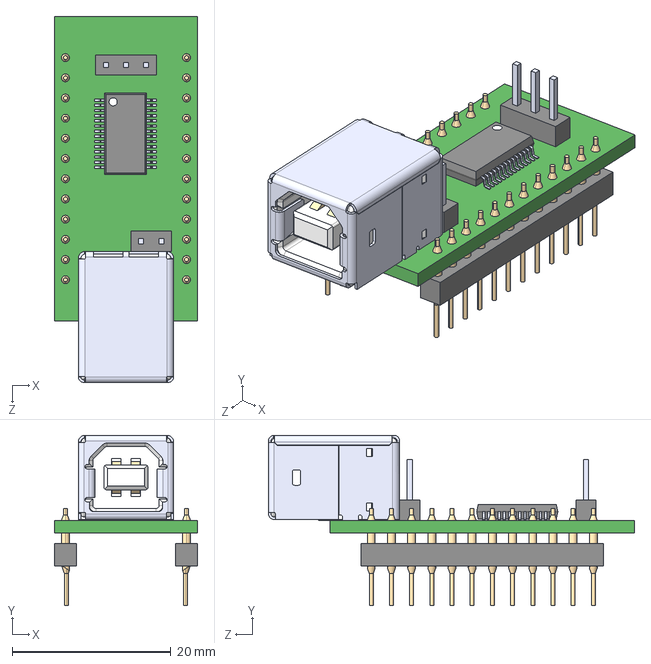
[picture p57: CAD file, 2025-07-14]
MyLibKiCad/3D/UM232R.step
18.0 x 21.4 x 46.0 mm
