kfirmaymon84/KiCadLib/MyLibKiCad/3D/VCNL36826S.stp

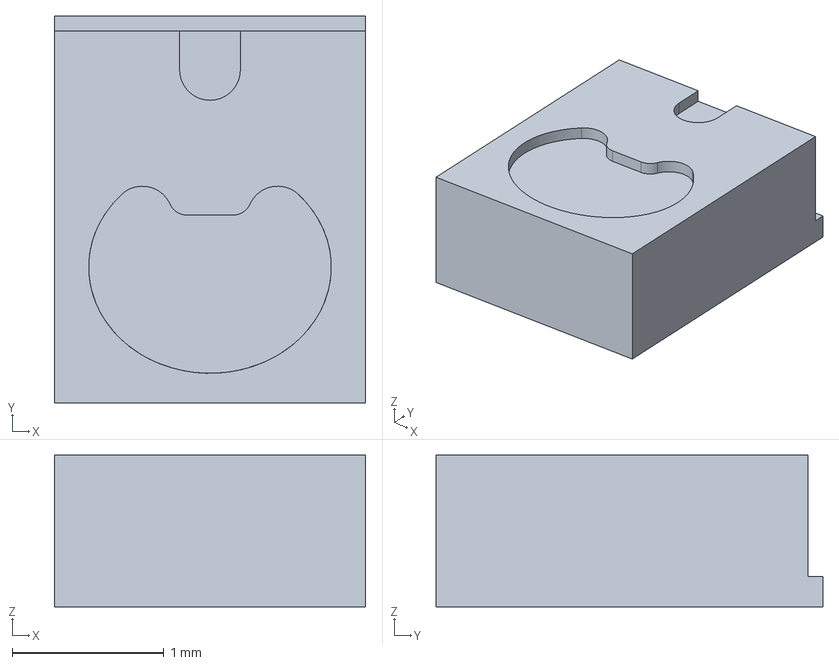
[picture p58: CAD file, 2025-07-14]
MyLibKiCad/3D/VCNL36826S.stp
2.05 x 2.55 x 1.00 mm
