kfirmaymon84/KiCadLib/MyLibKiCad/3D/IND2520.stp

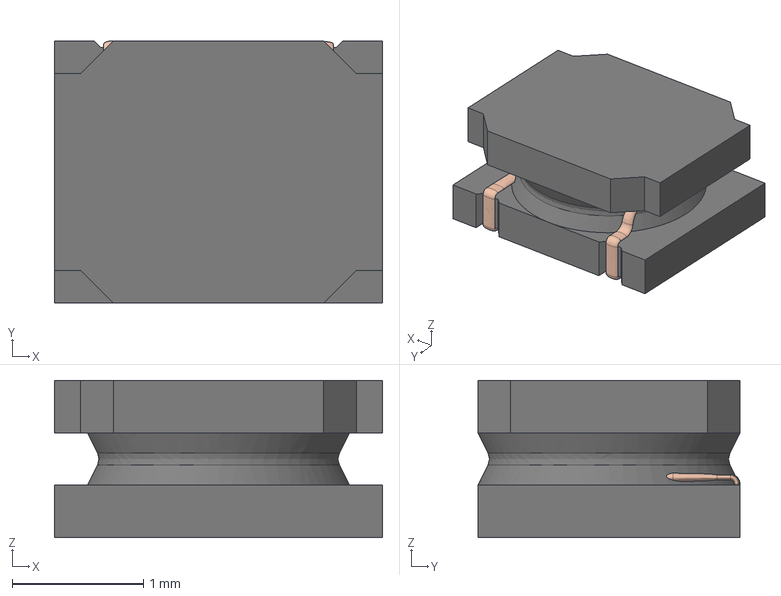
[picture p59: CAD file, 2025-07-07]
MyLibKiCad/3D/IND2520.stp
2.50 x 2.00 x 1.20 mm
