kfirmaymon84/KiCadLib/MyLibKiCad/3D/GW_CSSRM3_PM_20231016.STEP

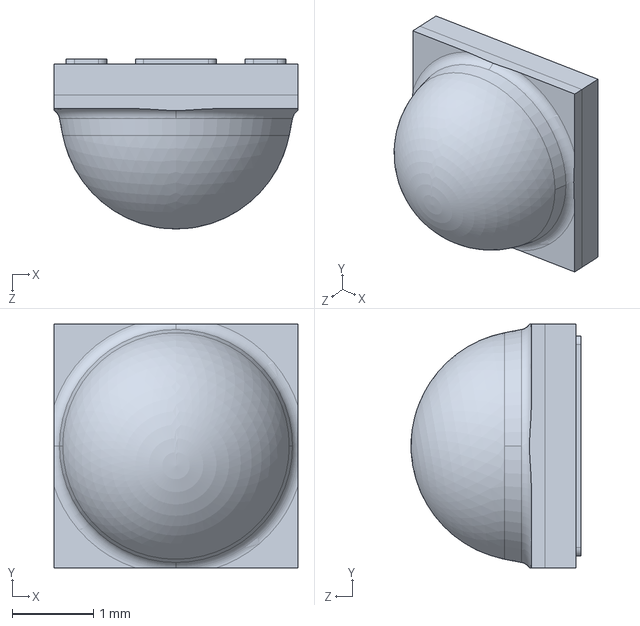
[picture p60: CAD file, 2025-06-22]
MyLibKiCad/3D/GW_CSSRM3_PM_20231016.STEP
3.00 x 3.00 x 2.09 mm
