kfirmaymon84/KiCadLib/MyLibKiCad/3D/TSIC 306 SOP-8--3DModel-STEP-510211.STEP

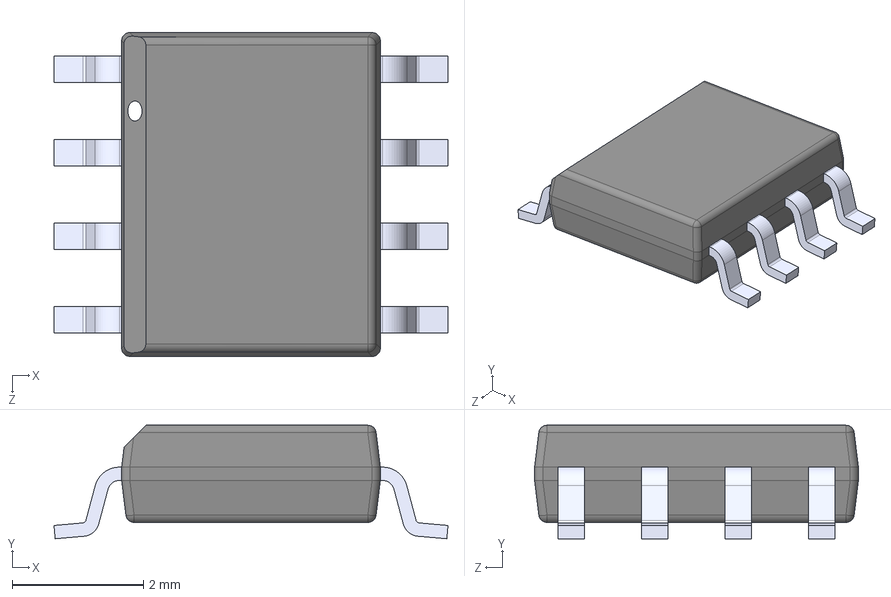
[picture p61: CAD file, 2025-06-22]
MyLibKiCad/3D/TSIC 306 SOP-8--3DModel-STEP-510211.STEP
5.99 x 1.73 x 4.93 mm
