kfirmaymon84/KiCadLib/MyLibKiCad/3D/CONMHF4-SMD-G-T.step

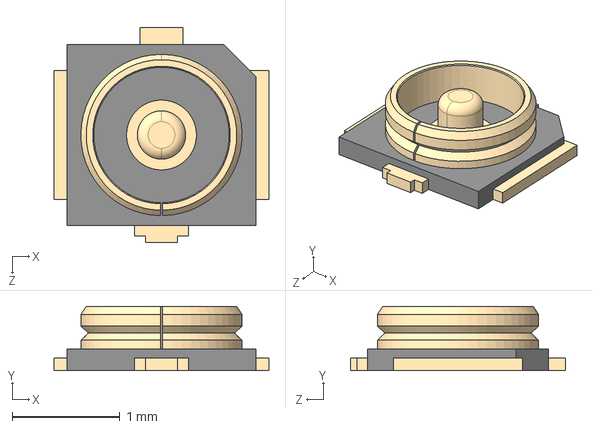
[picture p62: CAD file, 2025-06-22]
MyLibKiCad/3D/CONMHF4-SMD-G-T.step
2.00 x 0.6 x 2.00 mm
