kfirmaymon84/KiCadLib/MyLibKiCad/3D/BGA_746YAHR_TEX.step

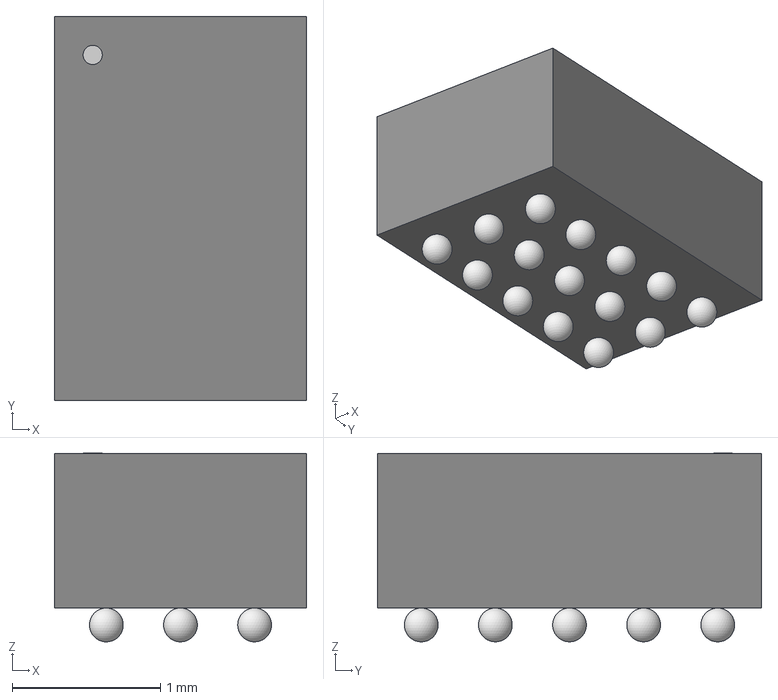
[picture p63: CAD file, 2025-06-22]
MyLibKiCad/3D/BGA_746YAHR_TEX.step
1.70 x 2.59 x 1.27 mm
