kfirmaymon84/KiCadLib/MyLibKiCad/3D/TSOP-6L_VIS.step

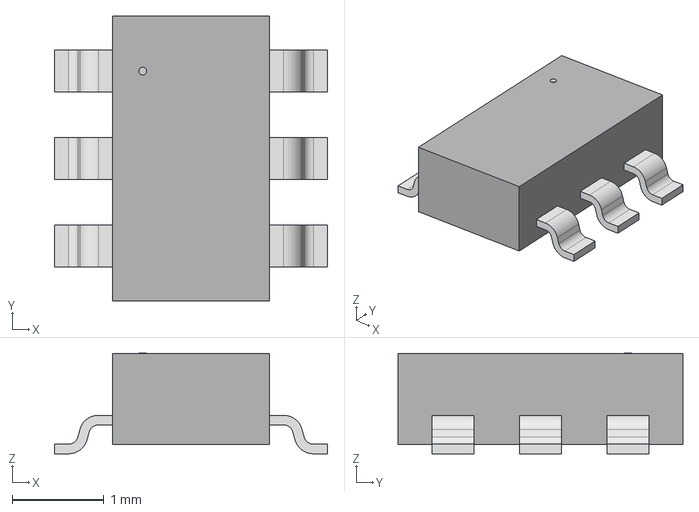
[picture p64: CAD file, 2025-06-22]
MyLibKiCad/3D/TSOP-6L_VIS.step
2.97 x 3.10 x 1.09 mm
