kfirmaymon84/KiCadLib/MyLibKiCad/3D/9_UBGA0.4.step

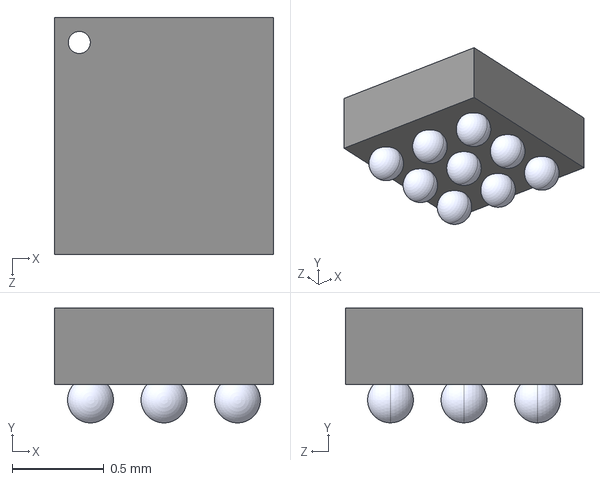
[picture p65: CAD file, 2025-06-22]
MyLibKiCad/3D/9_UBGA0.4.step
1.19 x 0.625 x 1.29 mm
