kfirmaymon84/KiCadLib/MyLibKiCad/3D/RES 2010.step

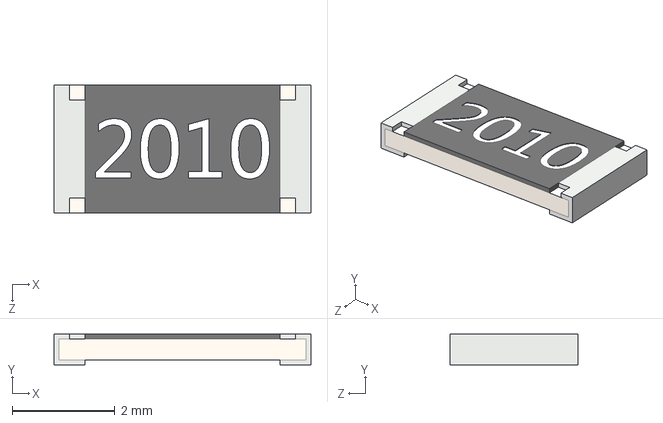
[picture p66: CAD file, 2025-06-22]
MyLibKiCad/3D/RES 2010.step
5.00 x 0.6 x 2.50 mm
