kfirmaymon84/KiCadLib/MyLibKiCad/3D/SOIC8.step

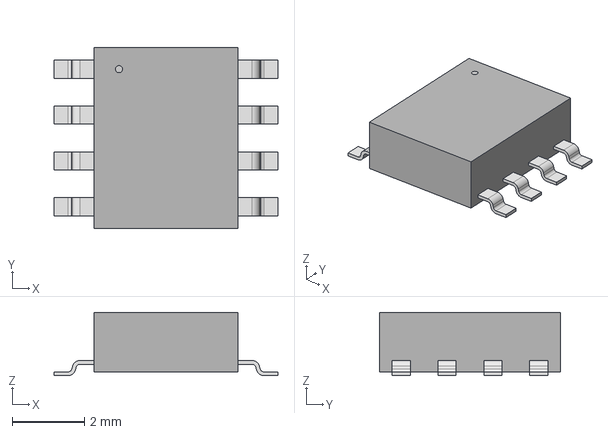
[picture p67: CAD file, 2025-06-22]
MyLibKiCad/3D/SOIC8.step
6.20 x 5.00 x 1.75 mm
