kfirmaymon84/KiCadLib/MyLibKiCad/3D/RES 2512.step

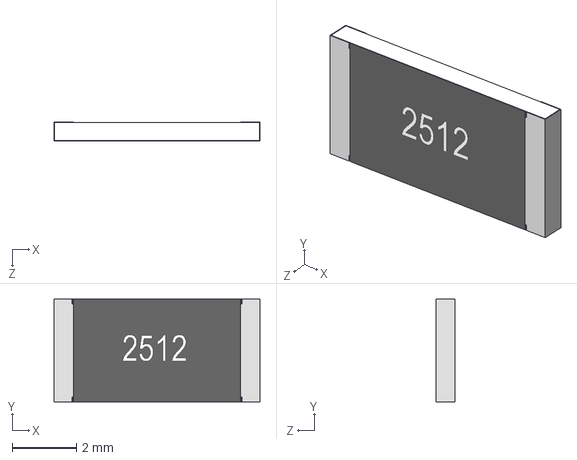
[picture p68: CAD file, 2025-06-22]
MyLibKiCad/3D/RES 2512.step
6.40 x 3.20 x 0.6 mm
