kfirmaymon84/KiCadLib/MyLibKiCad/3D/R75-1W.step

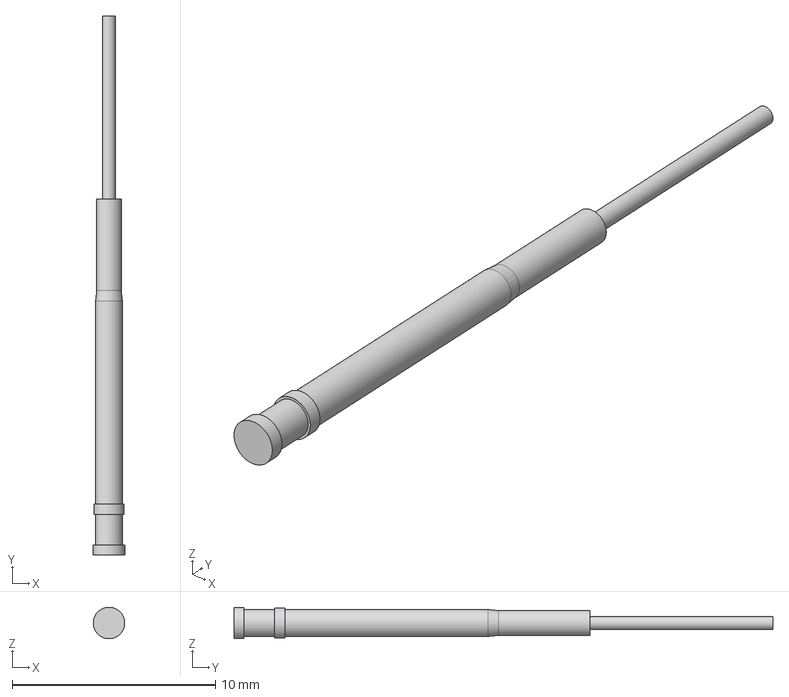
[picture p69: CAD file, 2025-06-22]
MyLibKiCad/3D/R75-1W.step
1.55 x 26.5 x 1.55 mm
