kfirmaymon84/KiCadLib/MyLibKiCad/3D/CAP 1206.step

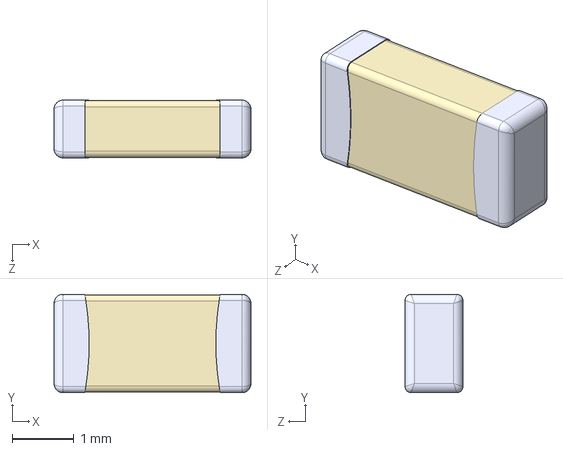
[picture p70: CAD file, 2025-06-22]
MyLibKiCad/3D/CAP 1206.step
3.20 x 1.60 x 0.94 mm
