kfirmaymon84/KiCadLib/MyLibKiCad/3D/10-VSON.stp

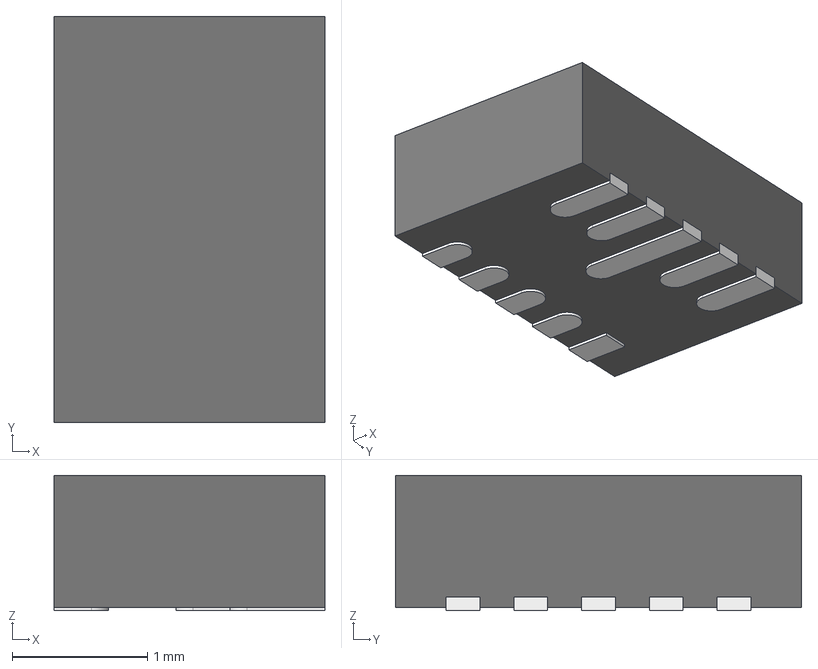
[picture p71: CAD file, 2025-06-22]
MyLibKiCad/3D/10-VSON.stp
2.00 x 3.00 x 1.00 mm
FRAME
MOLD
