kfirmaymon84/KiCadLib/MyLibKiCad/3D/SOT23-5.STEP

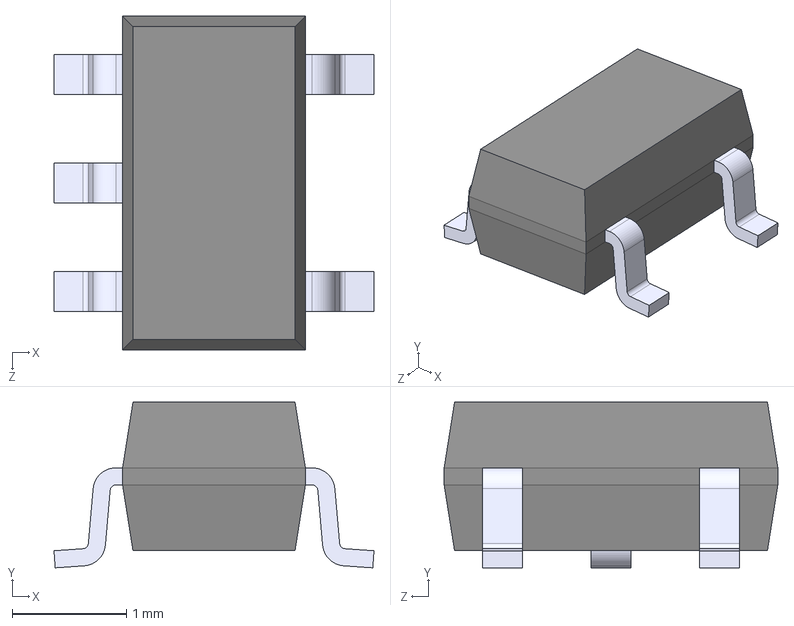
[picture p72: CAD file, 2025-06-22]
MyLibKiCad/3D/SOT23-5.STEP
2.80 x 1.45 x 2.92 mm
