kfirmaymon84/KiCadLib/MyLibKiCad/3D/IND_6x6.stp

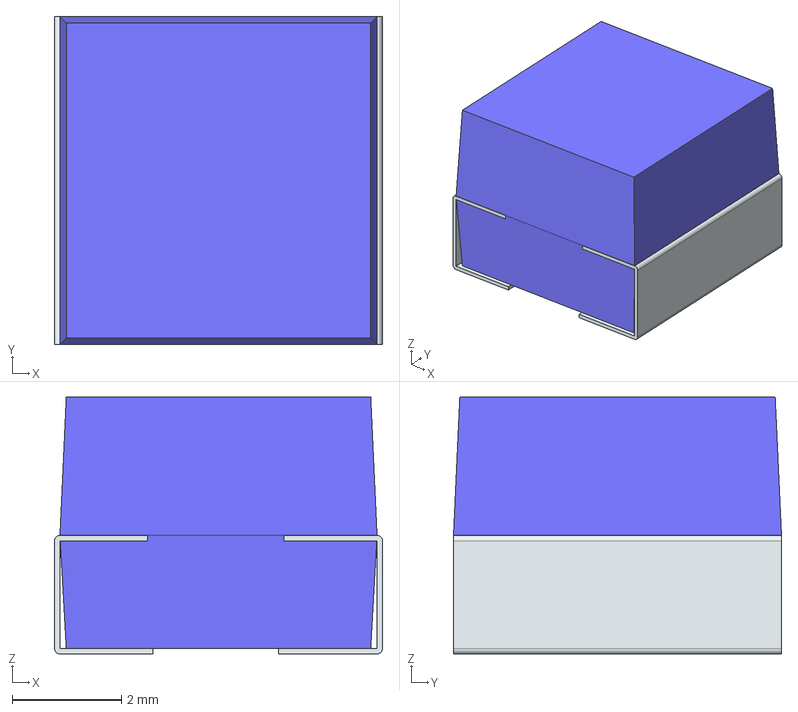
[picture p73: CAD file, 2025-06-22]
MyLibKiCad/3D/IND_6x6.stp
6.00 x 6.00 x 4.70 mm
FilletPin1
FilletPin2
