kfirmaymon84/KiCadLib/MyLibKiCad/3D/RES 0805.STEP

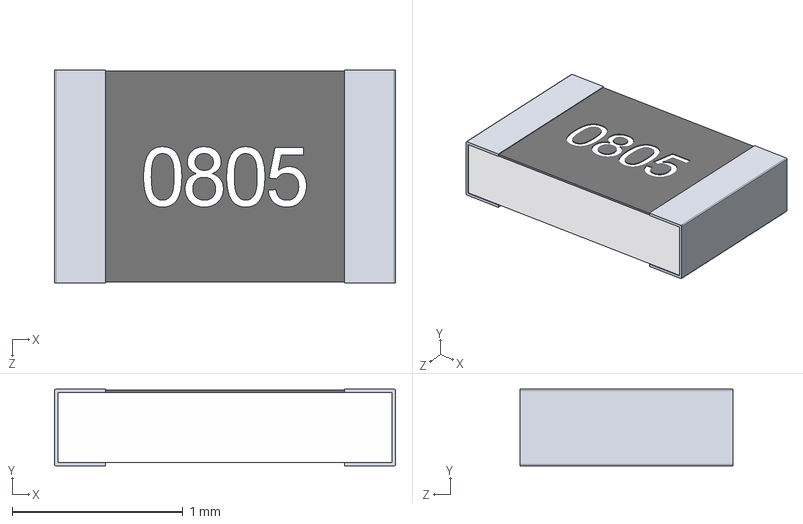
[picture p74: CAD file, 2025-06-22]
MyLibKiCad/3D/RES 0805.STEP
2.00 x 0.45 x 1.25 mm
0805 BODY
0805 PAD x 2
0805 OPIS
