kfirmaymon84/KiCadLib/MyLibKiCad/3D/24_VQFN_EP_4x4.step

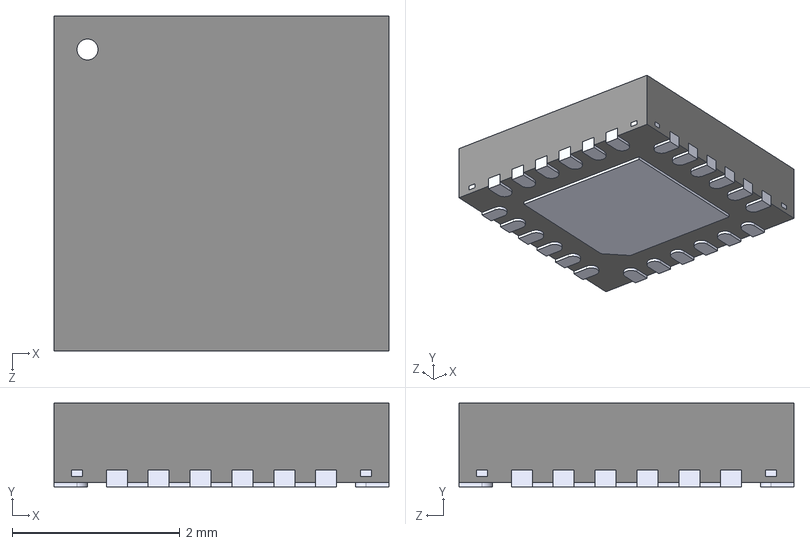
[picture p75: CAD file, 2025-06-22]
MyLibKiCad/3D/24_VQFN_EP_4x4.step
4.00 x 1.00 x 4.00 mm
