kfirmaymon84/KiCadLib/MyLibKiCad/3D/CAP 0402(1005M) Cap.step

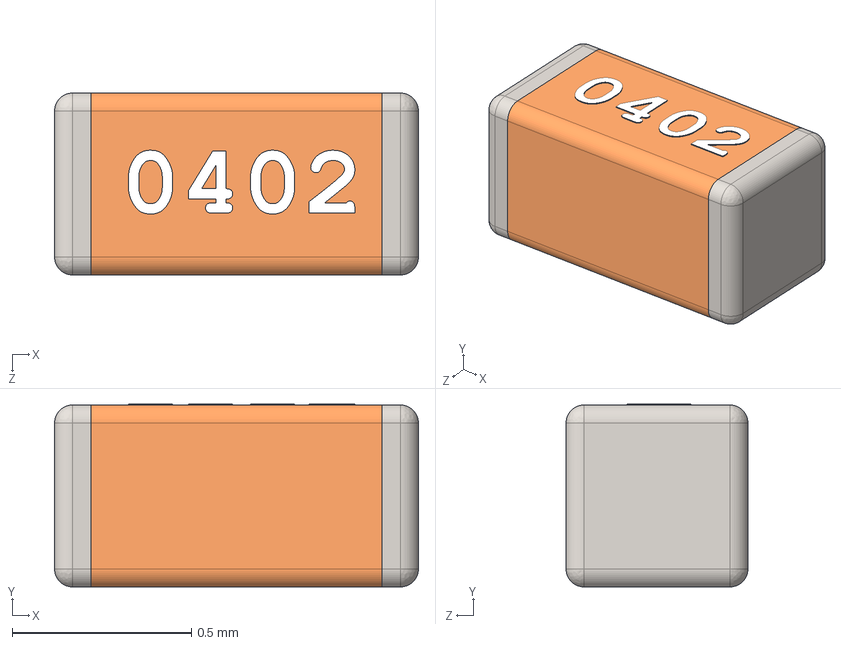
[picture p76: CAD file, 2025-06-22]
MyLibKiCad/3D/CAP 0402(1005M) Cap.step
1.02 x 0.511 x 0.508 mm
