kfirmaymon84/KiCadLib/MyLibKiCad/3D/SMA (DO-214AC).STEP

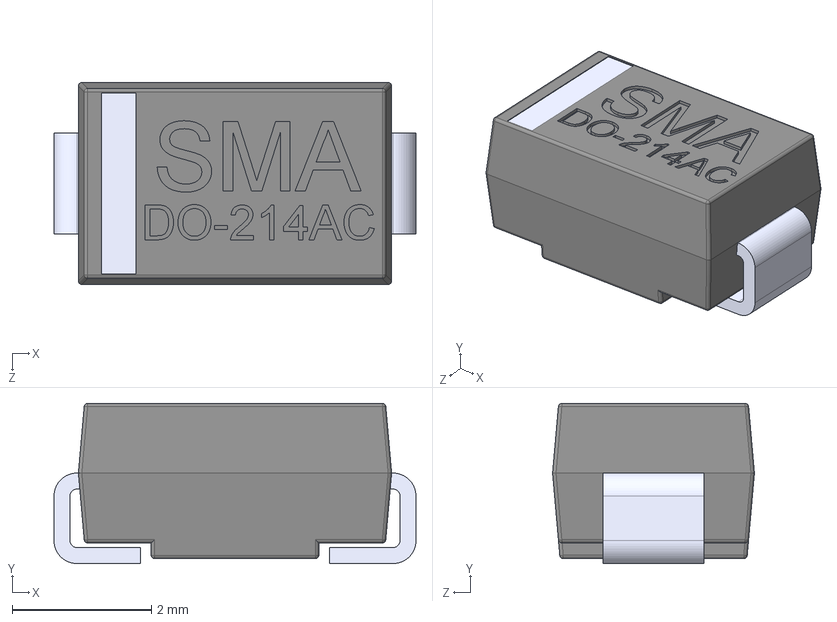
[picture p77: CAD file, 2025-06-22]
MyLibKiCad/3D/SMA (DO-214AC).STEP
5.20 x 2.30 x 2.90 mm
