kfirmaymon84/KiCadLib/MyLibKiCad/3D/SJ1-3525N.step

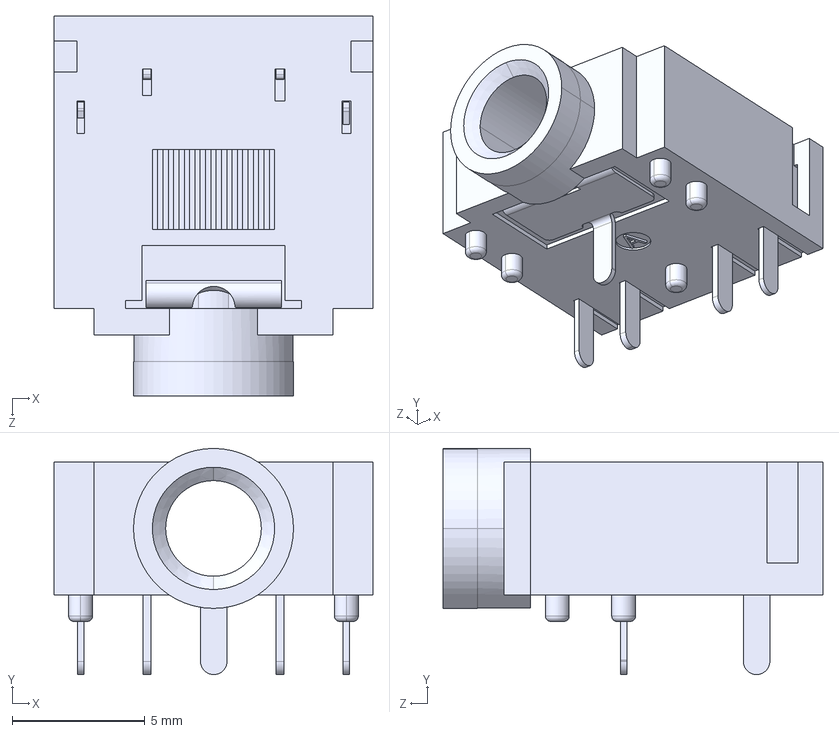
[picture p78: CAD file, 2025-06-22]
MyLibKiCad/3D/SJ1-3525N.step
12.0 x 8.51 x 14.3 mm
