kfirmaymon84/KiCadLib/MyLibKiCad/3D/QFN-16_3x3.STEP

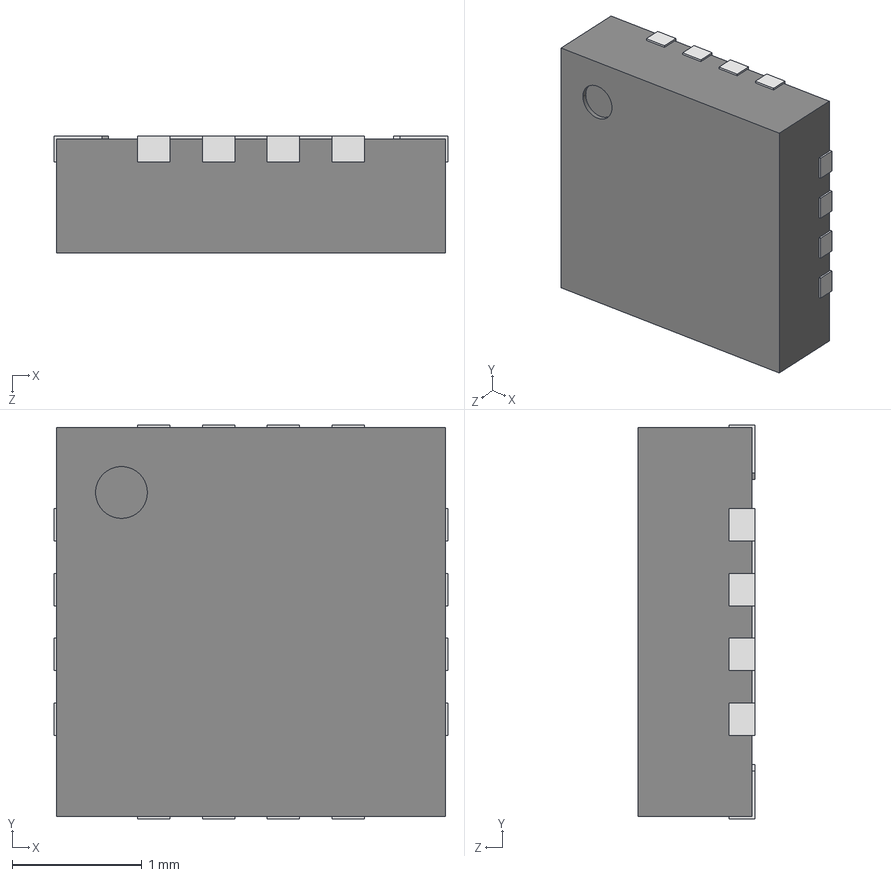
[picture p79: CAD file, 2025-06-22]
MyLibKiCad/3D/QFN-16_3x3.STEP
3.04 x 3.04 x 0.9 mm
