kfirmaymon84/KiCadLib/MyLibKiCad/3D/B4B-XH-A.step

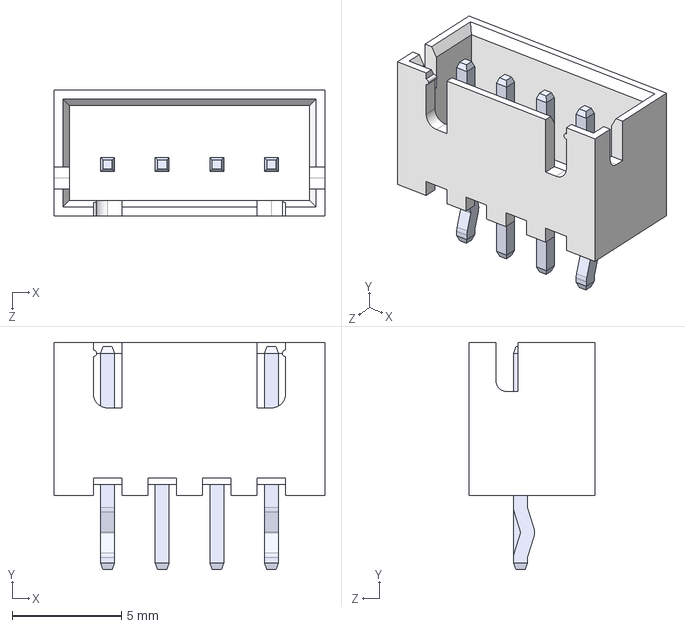
[picture p80: CAD file, 2025-06-22]
MyLibKiCad/3D/B4B-XH-A.step
12.4 x 10.4 x 5.75 mm
