kfirmaymon84/KiCadLib/MyLibKiCad/3D/28-TSSOP.step

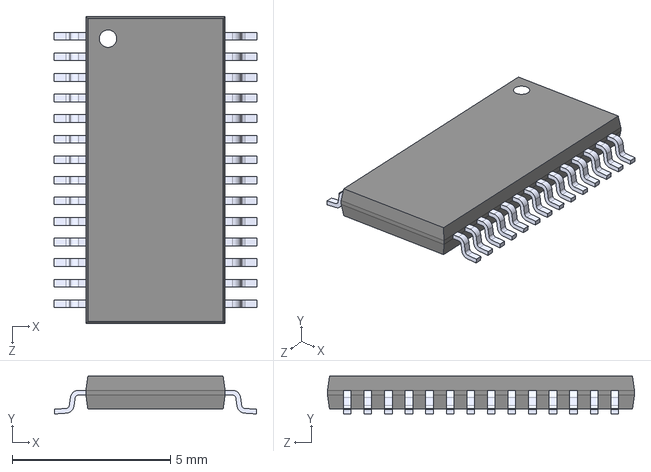
[picture p81: CAD file, 2025-06-22]
MyLibKiCad/3D/28-TSSOP.step
6.40 x 1.20 x 9.70 mm
