kfirmaymon84/KiCadLib/MyLibKiCad/3D/DX07S024JJ7R1200.stp

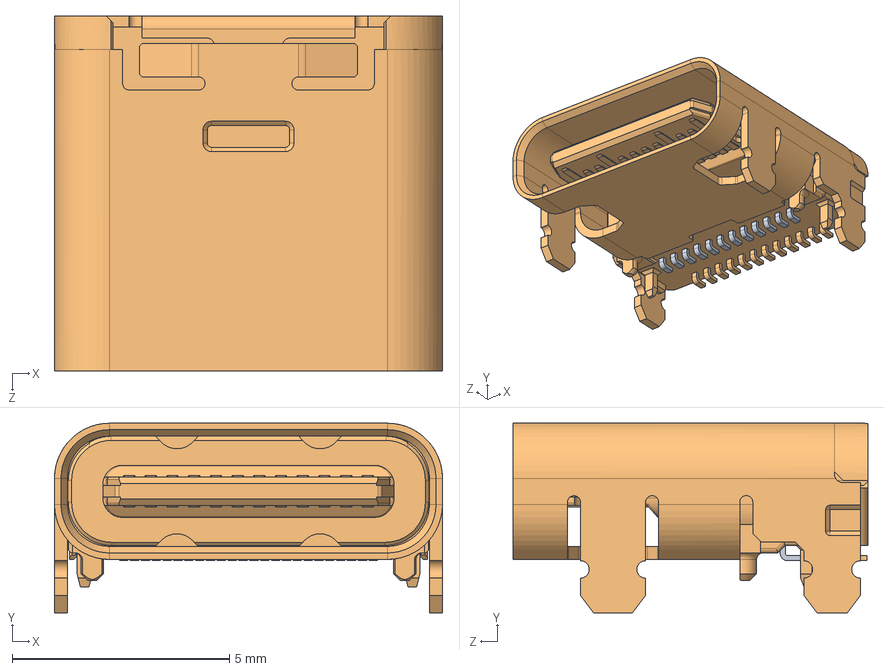
[picture p82: CAD file, 2025-06-22]
MyLibKiCad/3D/DX07S024JJ7R1200.stp
8.94 x 4.37 x 8.17 mm
