kfirmaymon84/KiCadLib/MyLibKiCad/3D/12-DSBGA (1.68x2.05).step

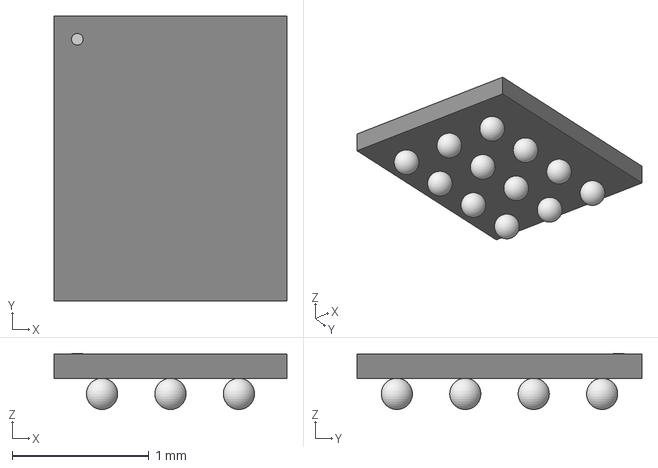
[picture p83: CAD file, 2025-06-22]
MyLibKiCad/3D/12-DSBGA (1.68x2.05).step
1.70 x 2.08 x 0.409 mm
