kfirmaymon84/KiCadLib/MyLibKiCad/3D/SOT28FL_ECH8693_ONS.step

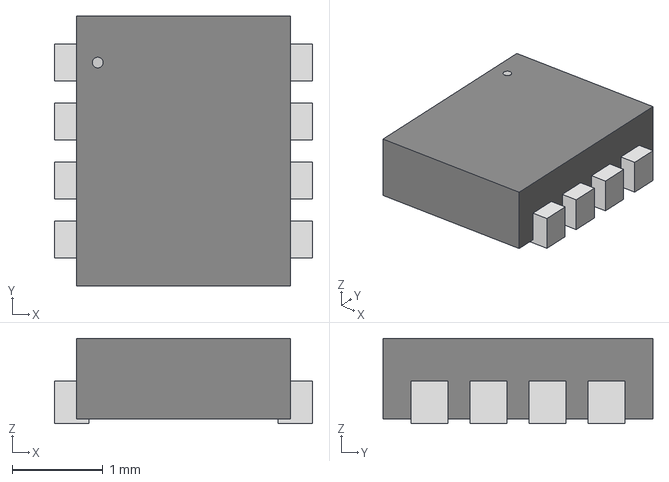
[picture p84: CAD file, 2025-06-22]
MyLibKiCad/3D/SOT28FL_ECH8693_ONS.step
2.84 x 2.97 x 0.942 mm
