kfirmaymon84/KiCadLib/MyLibKiCad/3D/8-DFN3x3_BW_ONS.step

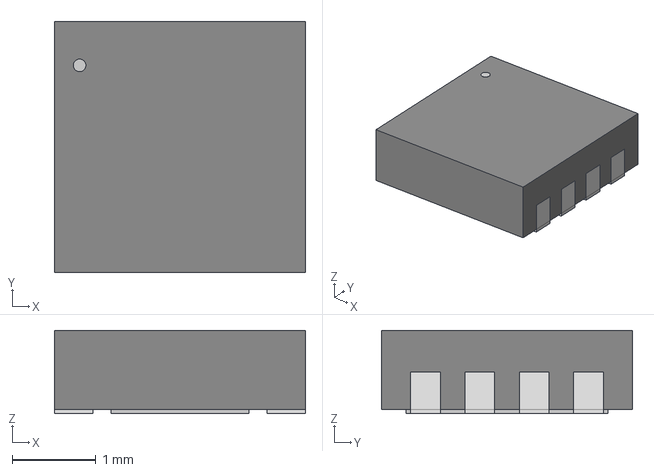
[picture p85: CAD file, 2025-06-22]
MyLibKiCad/3D/8-DFN3x3_BW_ONS.step
3.00 x 3.00 x 0.993 mm
