kfirmaymon84/KiCadLib/MyLibKiCad/3D/FFC2B28-14-G.stp

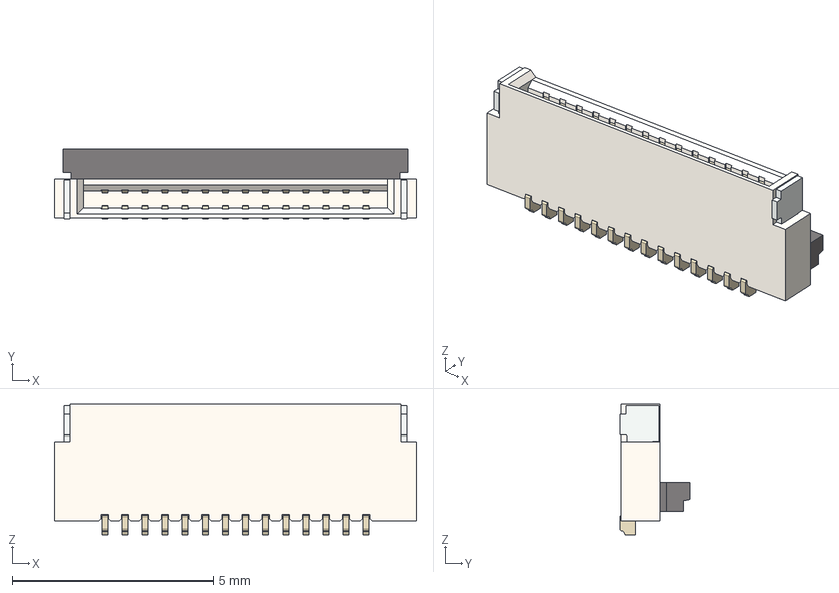
[picture p86: CAD file, 2025-06-22]
MyLibKiCad/3D/FFC2B28-14-G.stp
9.00 x 1.75 x 3.25 mm
FFC2B28_SP x 2
FFC2B28-14-G_C
FFC2B28-G_P x 14
FFC2B28-14-G_H
FFC2B28-14-G_D
