kfirmaymon84/KiCadLib/MyLibKiCad/3D/28-UFQFPN (4x4).step

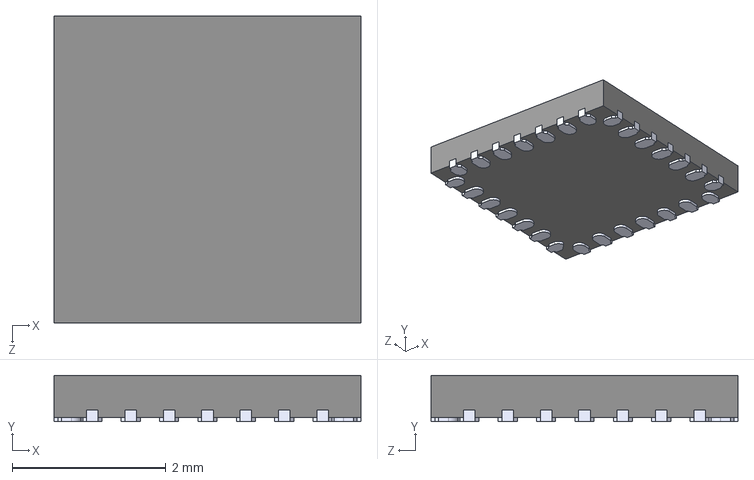
[picture p87: CAD file, 2025-06-22]
MyLibKiCad/3D/28-UFQFPN (4x4).step
4.00 x 0.6 x 4.00 mm
