kfirmaymon84/KiCadLib/MyLibKiCad/3D/PTS810_SJM_250_SMTR_LFS.step

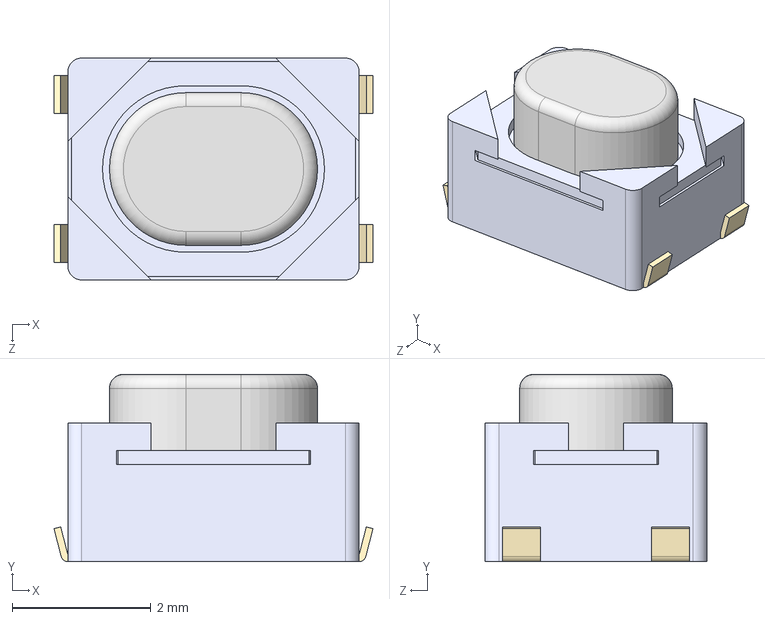
[picture p88: CAD file, 2025-06-22]
MyLibKiCad/3D/PTS810_SJM_250_SMTR_LFS.step
4.60 x 2.70 x 3.20 mm
