kfirmaymon84/KiCadLib/MyLibKiCad/3D/32-UFQFPN (5x5).STEP

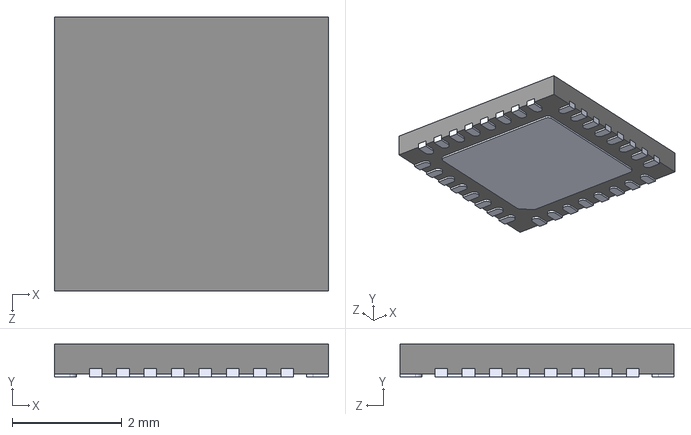
[picture p89: CAD file, 2025-06-22]
MyLibKiCad/3D/32-UFQFPN (5x5).STEP
5.00 x 0.6 x 5.00 mm
