kfirmaymon84/KiCadLib/MyLibKiCad/3D/HTP-CON-M413.step

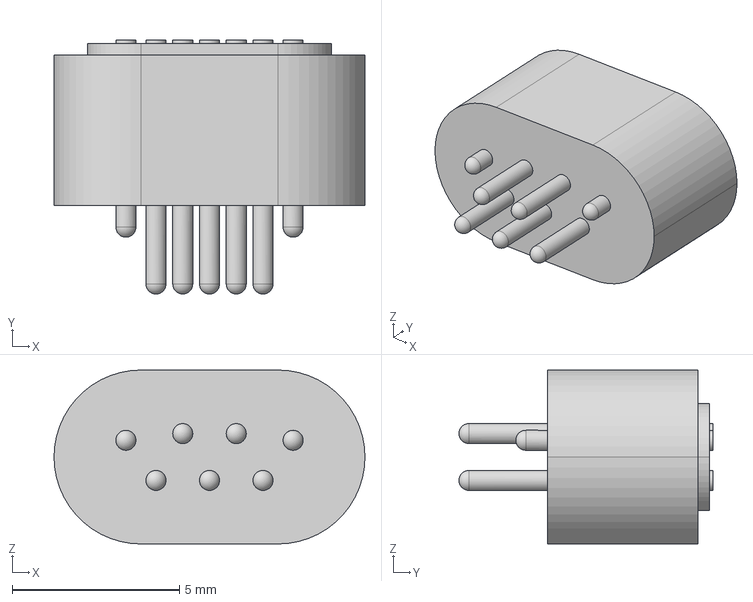
[picture p90: CAD file, 2025-06-22]
MyLibKiCad/3D/HTP-CON-M413.step
9.30 x 7.60 x 5.20 mm
