kfirmaymon84/KiCadLib/MyLibKiCad/3D/X1SON 1_06.stp

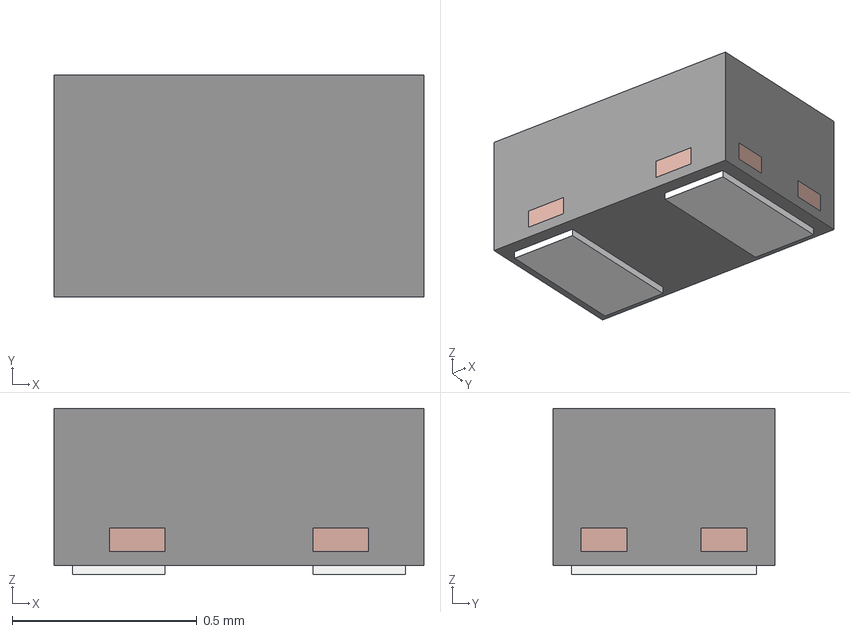
[picture p91: CAD file, 2025-06-22]
MyLibKiCad/3D/X1SON 1_06.stp
1.00 x 0.6 x 0.45 mm
BODY-SON
FRAME-DPY0002A
