kfirmaymon84/KiCadLib/MyLibKiCad/3D/DF61-2P-2.2V.stp

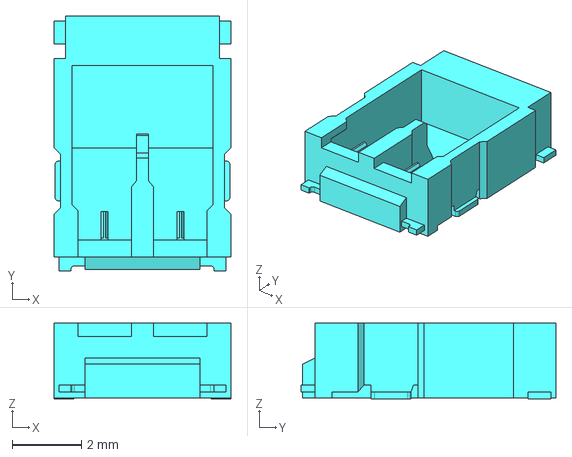
[picture p92: CAD file, 2025-06-22]
MyLibKiCad/3D/DF61-2P-2.2V.stp
5.10 x 7.35 x 2.18 mm
