kfirmaymon84/KiCadLib/MyLibKiCad/3D/6-VQFN-HR.stp

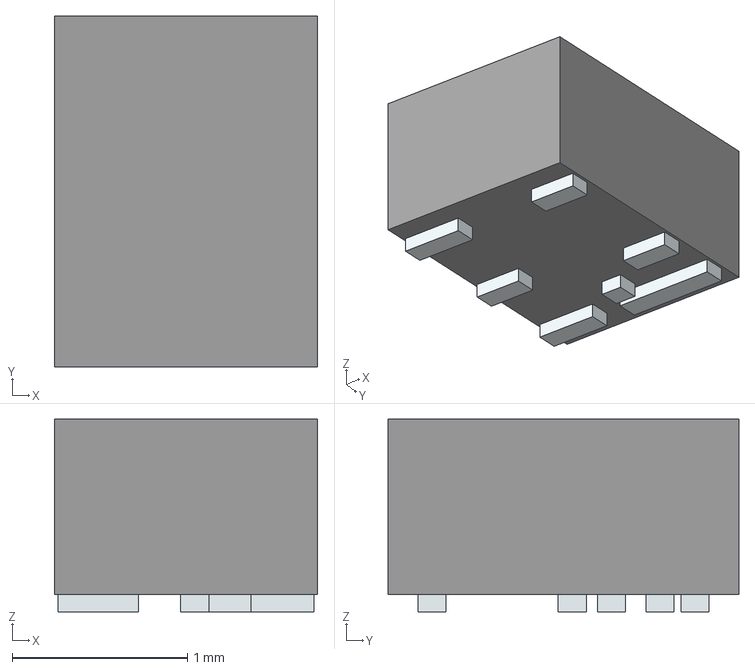
[picture p93: CAD file, 2025-06-22]
MyLibKiCad/3D/6-VQFN-HR.stp
1.50 x 2.00 x 1.10 mm
Pins
