kfirmaymon84/KiCadLib/MyLibKiCad/3D/14-PowerTSSOP.stp

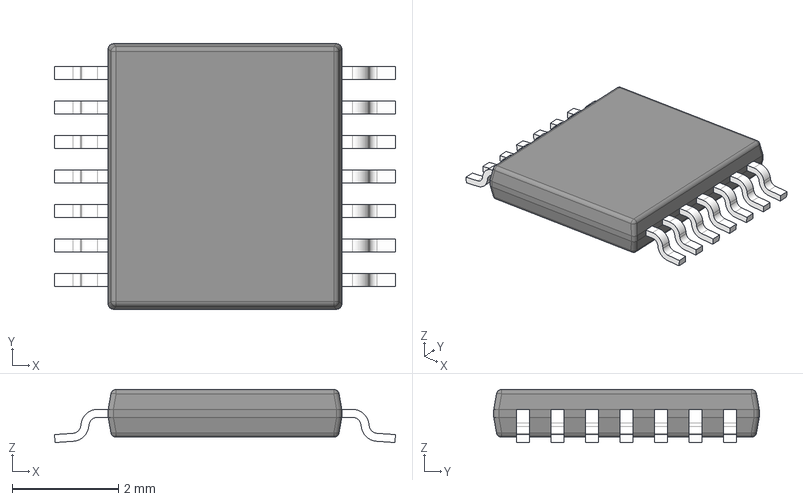
[picture p94: CAD file, 2025-06-22]
MyLibKiCad/3D/14-PowerTSSOP.stp
6.42 x 5.00 x 1.00 mm
BODY-SO
LEAD-SO x 14
THERMALPAD-SO
PIN1-ID
