kfirmaymon84/KiCadLib/MyLibKiCad/3D/16-SOIC.step

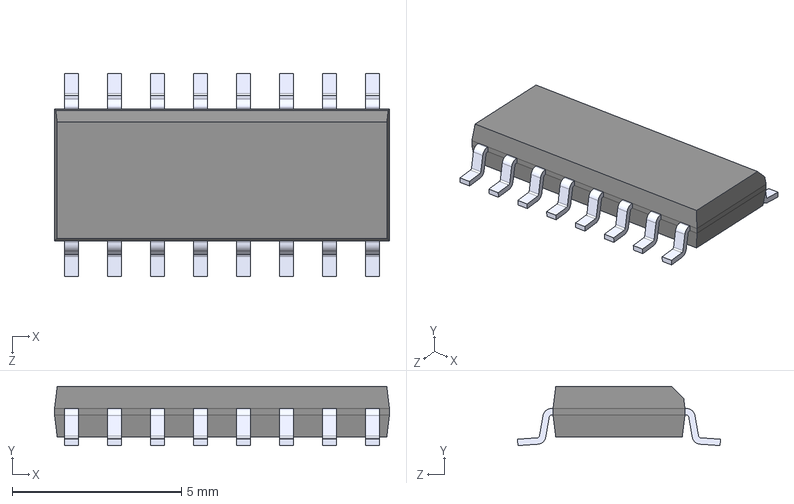
[picture p95: CAD file, 2025-06-22]
MyLibKiCad/3D/16-SOIC.step
9.90 x 1.75 x 6.00 mm
