kfirmaymon84/KiCadLib/MyLibKiCad/3D/7-188275-6.stp

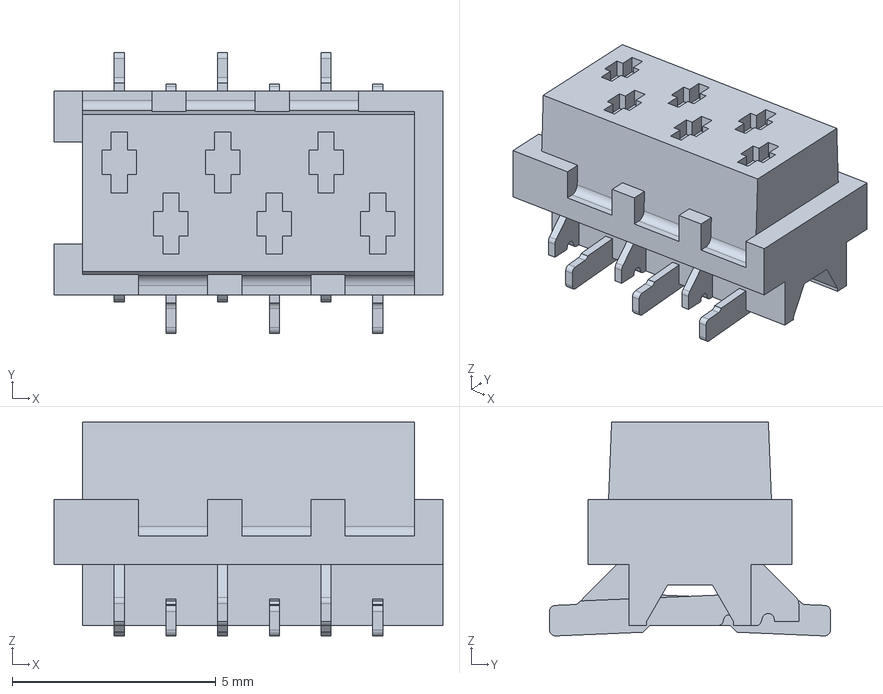
[picture p96: CAD file, 2025-06-22]
MyLibKiCad/3D/7-188275-6.stp
9.55 x 6.90 x 5.25 mm
