kfirmaymon84/KiCadLib/MyLibKiCad/3D/LED_0603_R.STEP

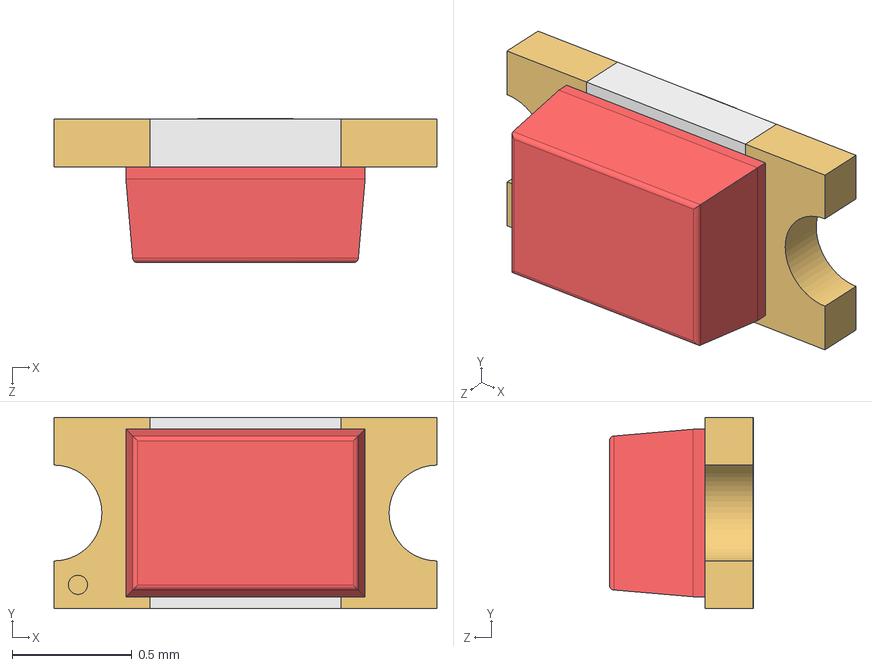
[picture p97: CAD file, 2025-06-22]
MyLibKiCad/3D/LED_0603_R.STEP
1.60 x 0.8 x 0.602 mm
