kfirmaymon84/KiCadLib/MyLibKiCad/3D/8-DSBGA (0.66x1.36).STEP

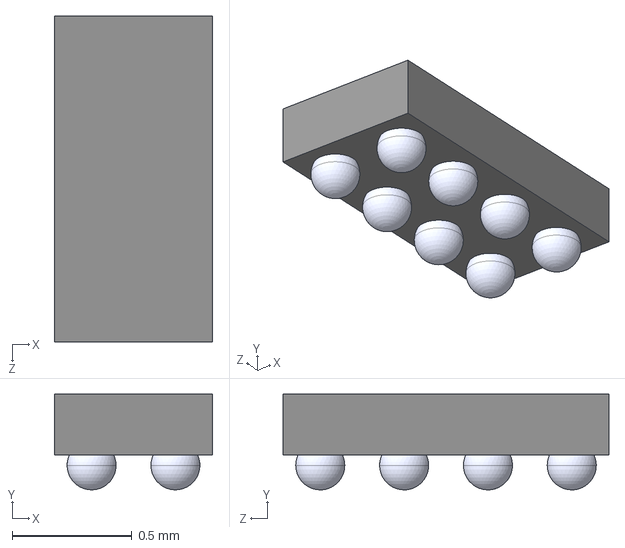
[picture p98: CAD file, 2025-06-22]
MyLibKiCad/3D/8-DSBGA (0.66x1.36).STEP
0.661 x 0.4 x 1.36 mm
