kfirmaymon84/KiCadLib/MyLibKiCad/3D/0603 FB.STEP

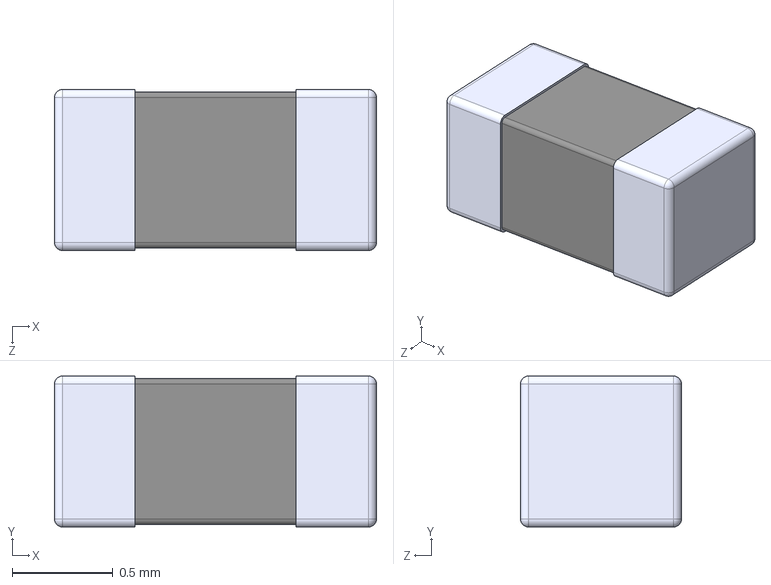
[picture p99: CAD file, 2025-06-22]
MyLibKiCad/3D/0603 FB.STEP
1.60 x 0.75 x 0.8 mm
