kfirmaymon84/KiCadLib/MyLibKiCad/3D/70ADJ-2-ML1.STEP

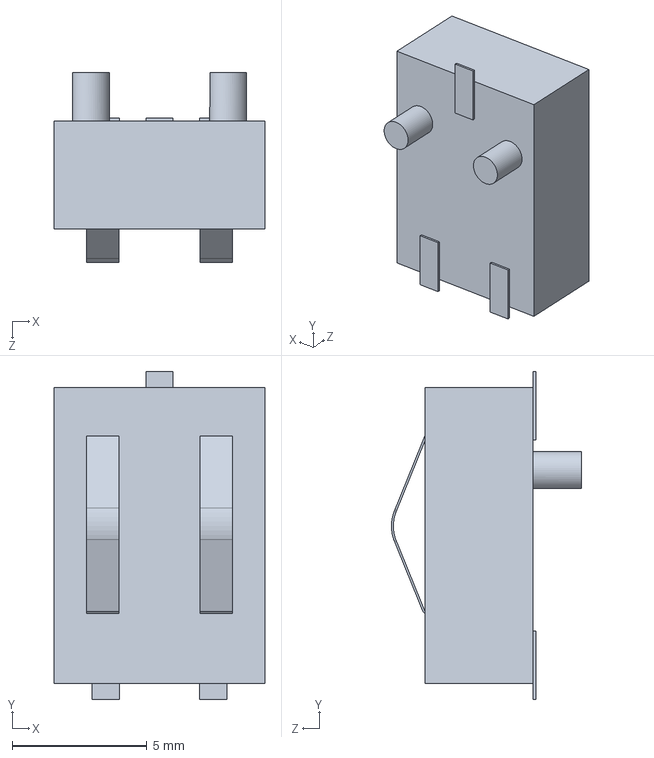
[picture p100: CAD file, 2025-06-22]
MyLibKiCad/3D/70ADJ-2-ML1.STEP
7.82 x 12.2 x 7.06 mm
