kfirmaymon84/KiCadLib/MyLibKiCad/3D/1206CommonChoke.step

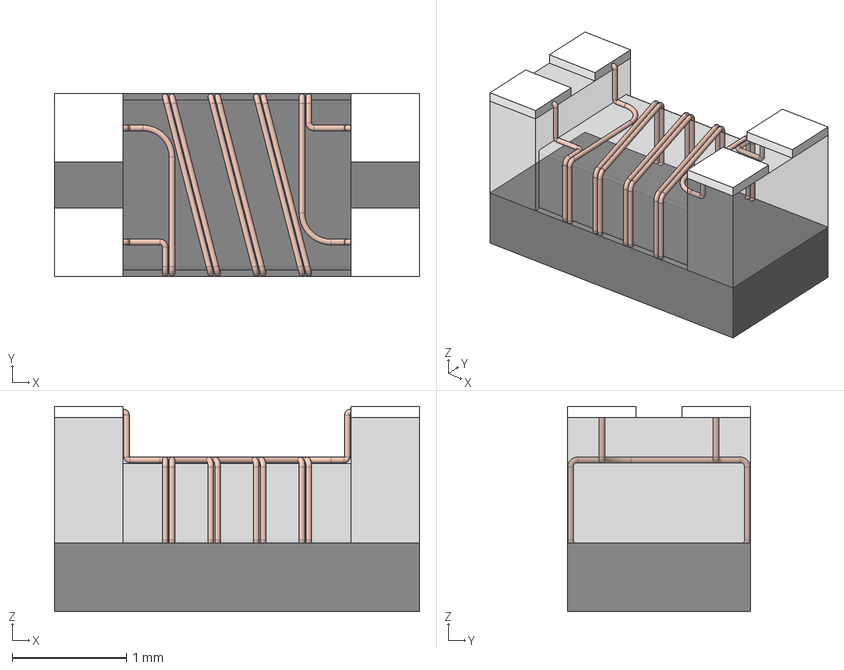
[picture p101: CAD file, 2025-06-22]
MyLibKiCad/3D/1206CommonChoke.step
3.20 x 1.60 x 1.80 mm
Gehäuse
Boden
L飆fl踄he x 4
