kfirmaymon84/KiCadLib/MyLibKiCad/3D/QFN32 5X5.step

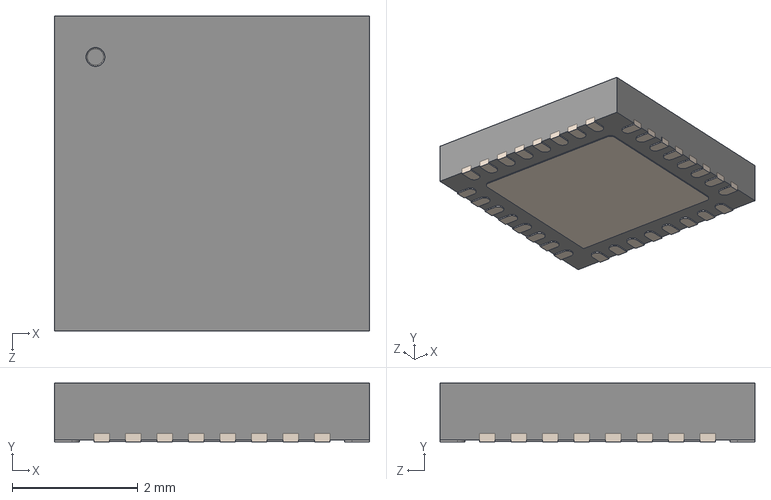
[picture p102: CAD file, 2025-06-22]
MyLibKiCad/3D/QFN32 5X5.step
5.00 x 0.93 x 5.00 mm
