kfirmaymon84/KiCadLib/MyLibKiCad/3D/ESP32-S3-WROOM-1-N8.step

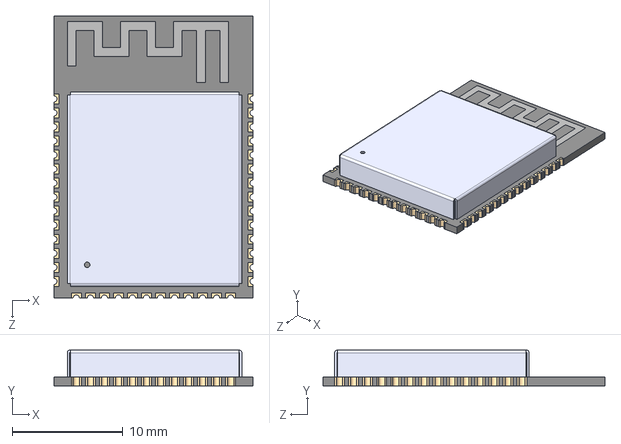
[picture p103: CAD file, 2025-06-22]
MyLibKiCad/3D/ESP32-S3-WROOM-1-N8.step
18.0 x 3.25 x 25.5 mm
