kfirmaymon84/KiCadLib/MyLibKiCad/3D/RES 0603.STEP

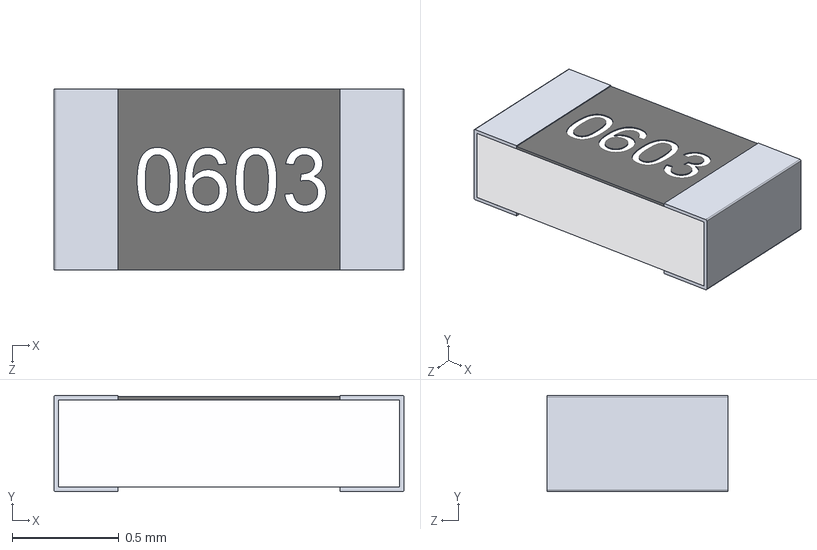
[picture p104: CAD file, 2025-06-22]
MyLibKiCad/3D/RES 0603.STEP
1.64 x 0.45 x 0.85 mm
0603 BODY
0603 PAD x 2
0603 OPIS
