kfirmaymon84/KiCadLib/MyLibKiCad/3D/SOD323.step

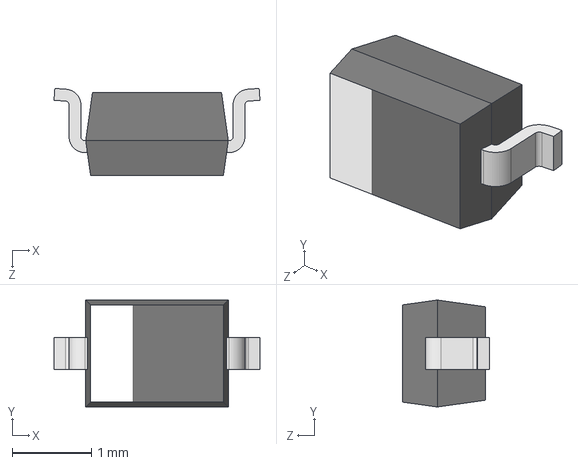
[picture p105: CAD file, 2025-06-22]
MyLibKiCad/3D/SOD323.step
2.60 x 1.35 x 1.10 mm
