kfirmaymon84/KiCadLib/MyLibKiCad/3D/DF40C-12DP.stp

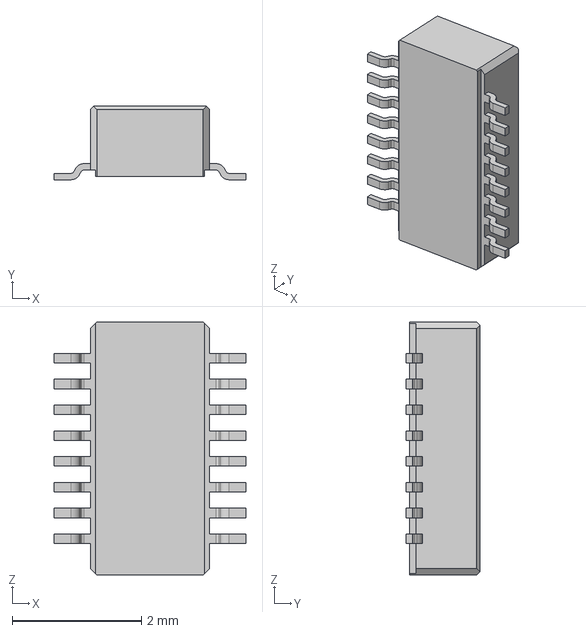
[picture p106: CAD file, 2025-06-22]
MyLibKiCad/3D/DF40C-12DP.stp
2.97 x 1.14 x 3.92 mm
