kfirmaymon84/KiCadLib/MyLibKiCad/3D/LED_DUAL0805.STEP

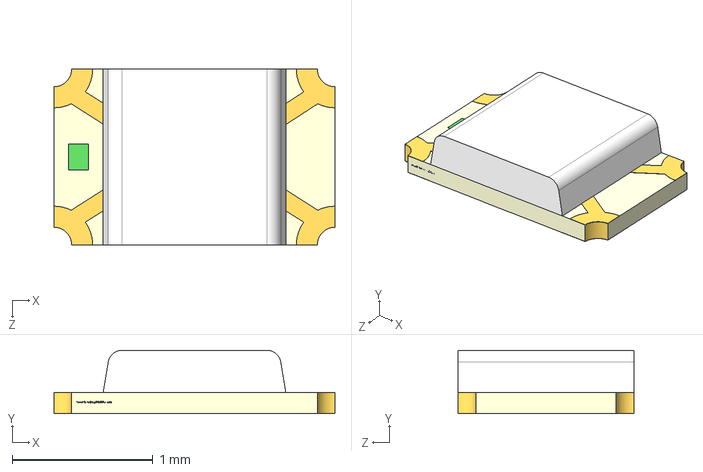
[picture p107: CAD file, 2025-06-22]
MyLibKiCad/3D/LED_DUAL0805.STEP
2.00 x 0.451 x 1.25 mm
