kfirmaymon84/KiCadLib/MyLibKiCad/3D/8-WSON.stp

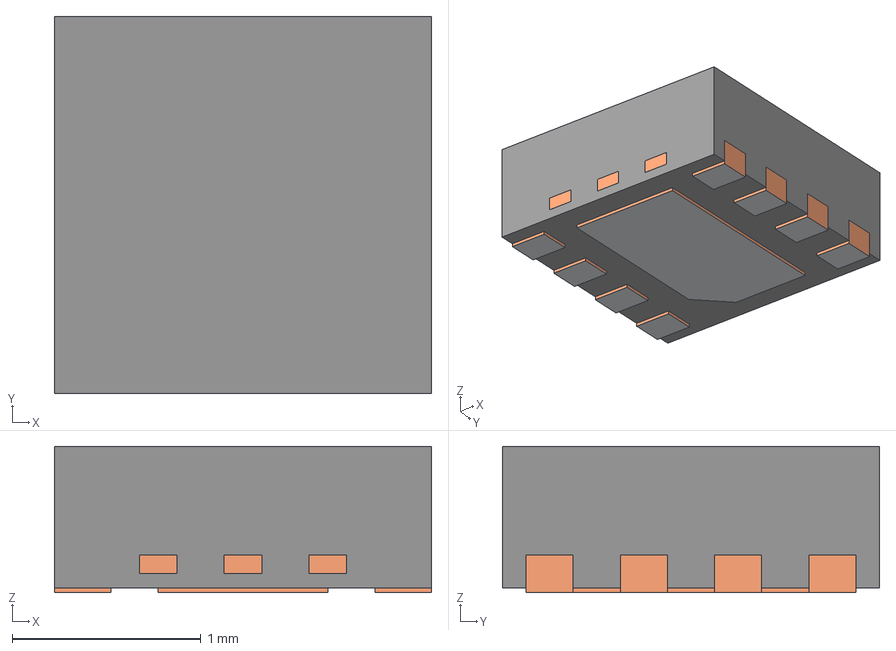
[picture p108: CAD file, 2025-06-22]
MyLibKiCad/3D/8-WSON.stp
2.00 x 2.00 x 0.775 mm
BODY-SON
FRAME-DSG0008A
PIN1-ID
