kfirmaymon84/KiCadLib/MyLibKiCad/3D/CAP 0201(0603M) Cap.step

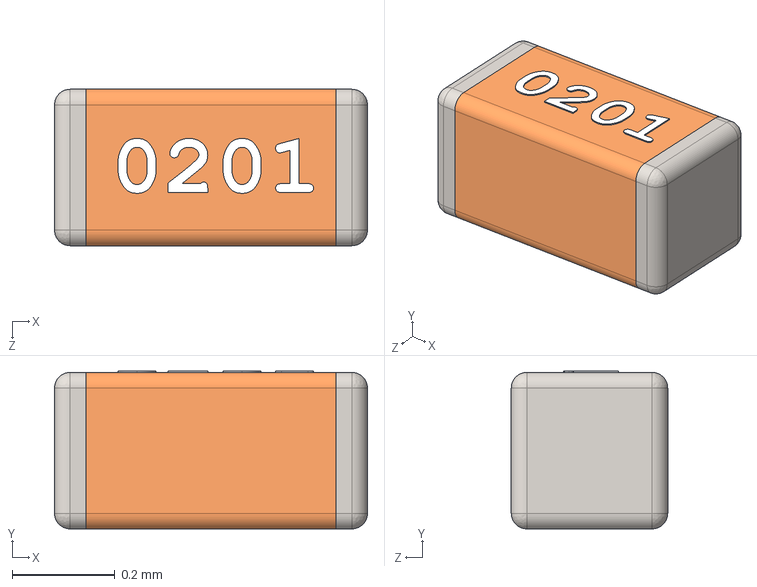
[picture p109: CAD file, 2025-06-22]
MyLibKiCad/3D/CAP 0201(0603M) Cap.step
0.61 x 0.307 x 0.305 mm
