kfirmaymon84/KiCadLib/MyLibKiCad/3D/B2B-XH-A-LF--SN---3DModel-STEP-269445.STEP

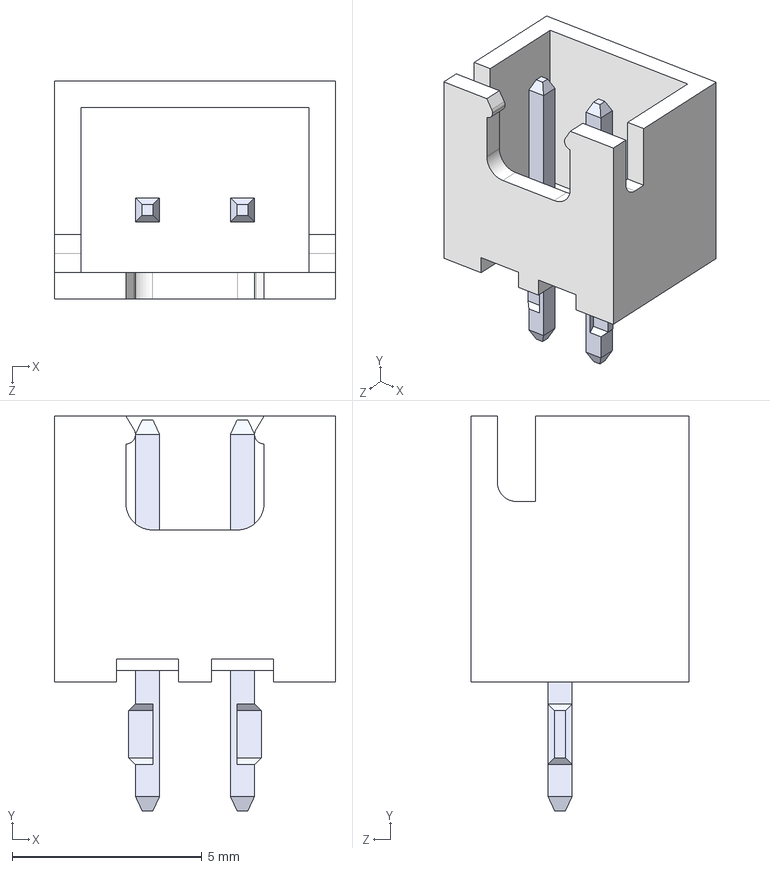
[picture p110: CAD file, 2025-06-22]
MyLibKiCad/3D/B2B-XH-A-LF--SN---3DModel-STEP-269445.STEP
7.40 x 10.4 x 5.75 mm
