kfirmaymon84/KiCadLib/MyLibKiCad/3D/8-DFN3x3_0.5P.step

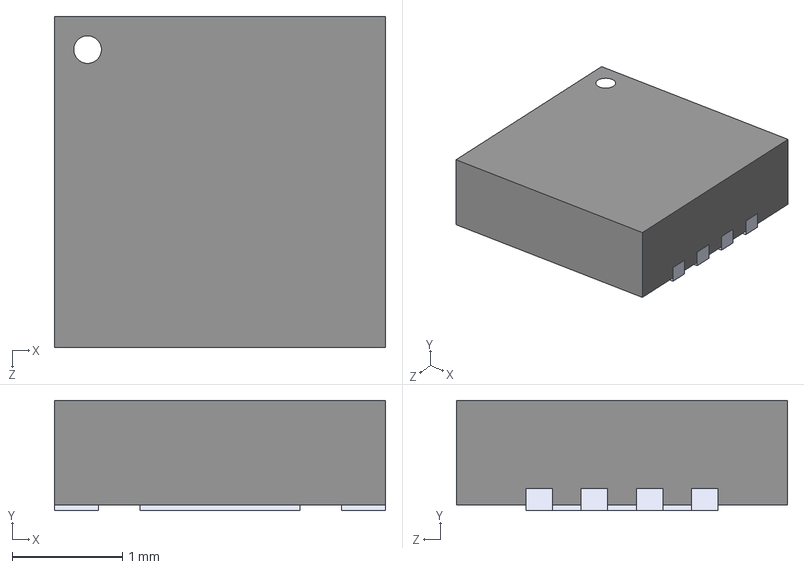
[picture p111: CAD file, 2025-06-22]
MyLibKiCad/3D/8-DFN3x3_0.5P.step
3.00 x 1.00 x 3.00 mm
