kfirmaymon84/KiCadLib/MyLibKiCad/3D/SOT-23-6.step

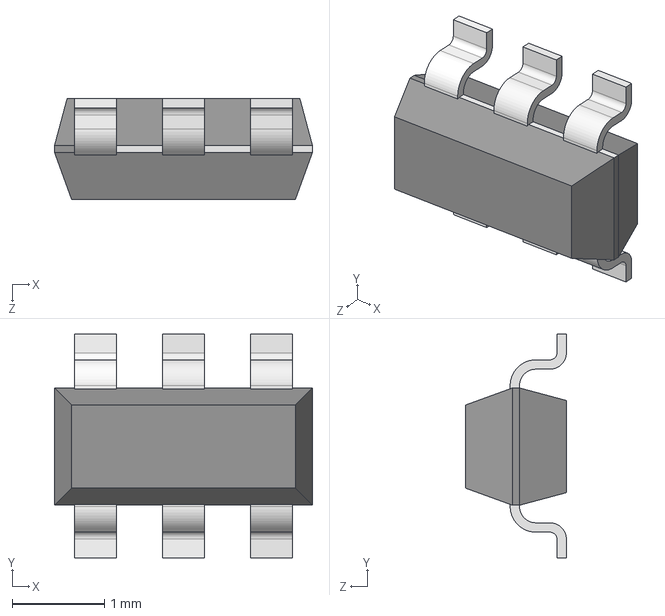
[picture p112: CAD file, 2025-06-22]
MyLibKiCad/3D/SOT-23-6.step
2.79 x 2.43 x 1.09 mm
