kfirmaymon84/KiCadLib/MyLibKiCad/3D/SOT-23-8.STEP

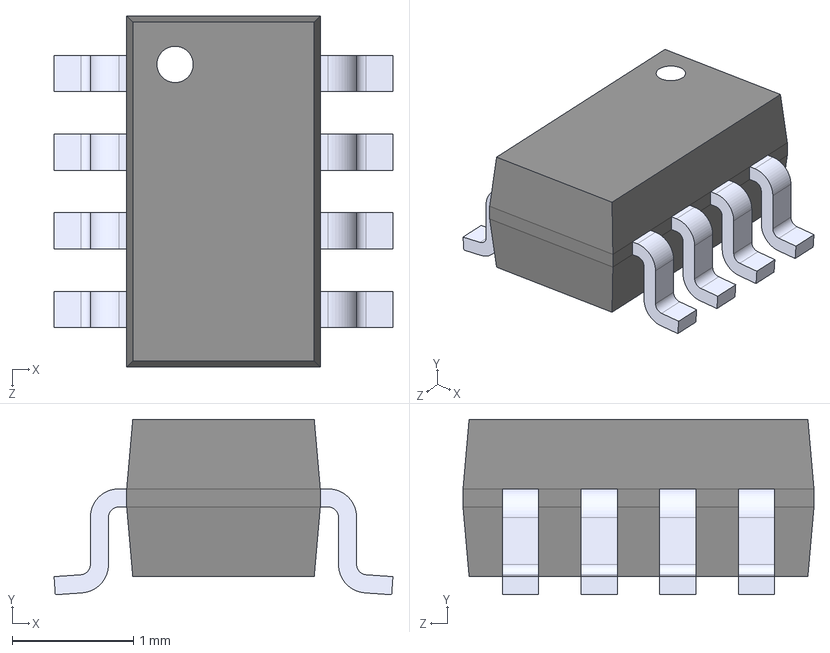
[picture p113: CAD file, 2025-06-22]
MyLibKiCad/3D/SOT-23-8.STEP
2.80 x 1.45 x 2.90 mm
