kfirmaymon84/KiCadLib/MyLibKiCad/3D/SOT50P160X60-6N.step

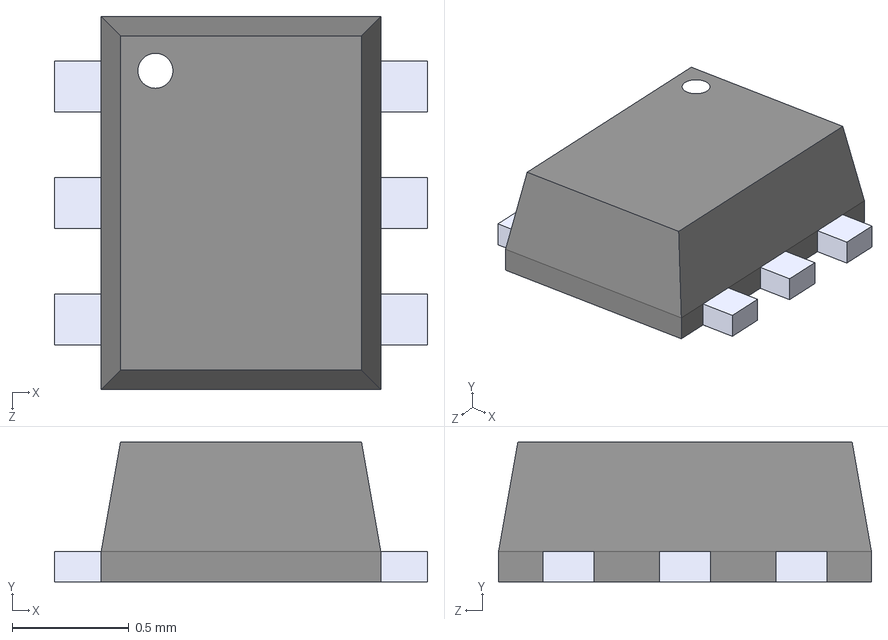
[picture p114: CAD file, 2025-06-22]
MyLibKiCad/3D/SOT50P160X60-6N.step
1.60 x 0.6 x 1.60 mm
