kfirmaymon84/KiCadLib/MyLibKiCad/3D/TO-220-7_Normal_Custom_rev1.0.STEP

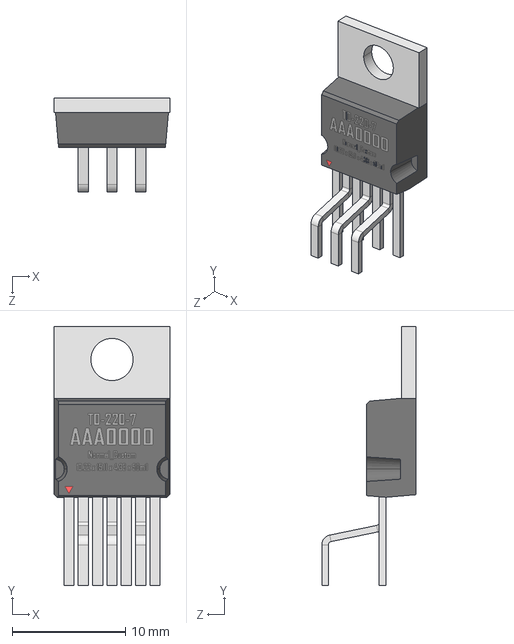
[picture p115: CAD file, 2025-06-22]
MyLibKiCad/3D/TO-220-7_Normal_Custom_rev1.0.STEP
10.2 x 22.9 x 8.35 mm
