kfirmaymon84/KiCadLib/MyLibKiCad/3D/WE-CBF-0805_rev1.stp

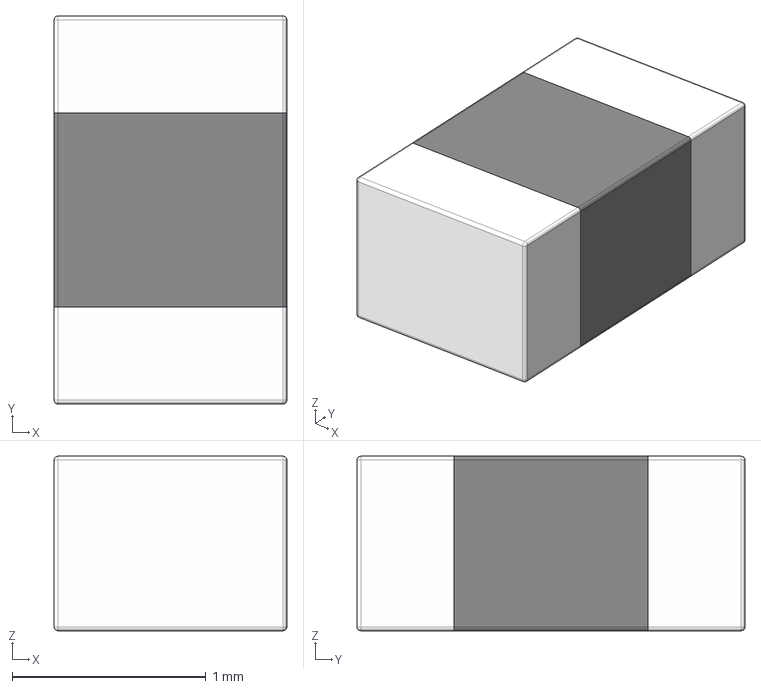
[picture p116: CAD file, 2025-06-22]
MyLibKiCad/3D/WE-CBF-0805_rev1.stp
1.20 x 2.00 x 0.9 mm
Lötende x 2
