kfirmaymon84/KiCadLib/MyLibKiCad/3D/14-tssop.step

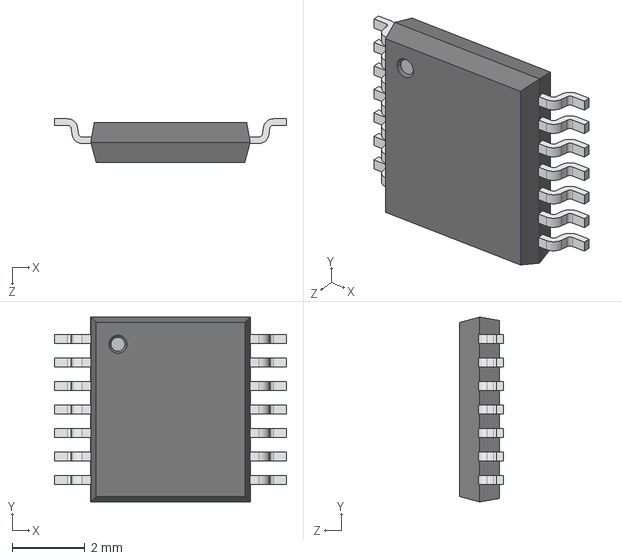
[picture p117: CAD file, 2025-06-22]
MyLibKiCad/3D/14-tssop.step
6.40 x 5.10 x 1.20 mm
