kfirmaymon84/KiCadLib/MyLibKiCad/3D/RES 1206.STEP

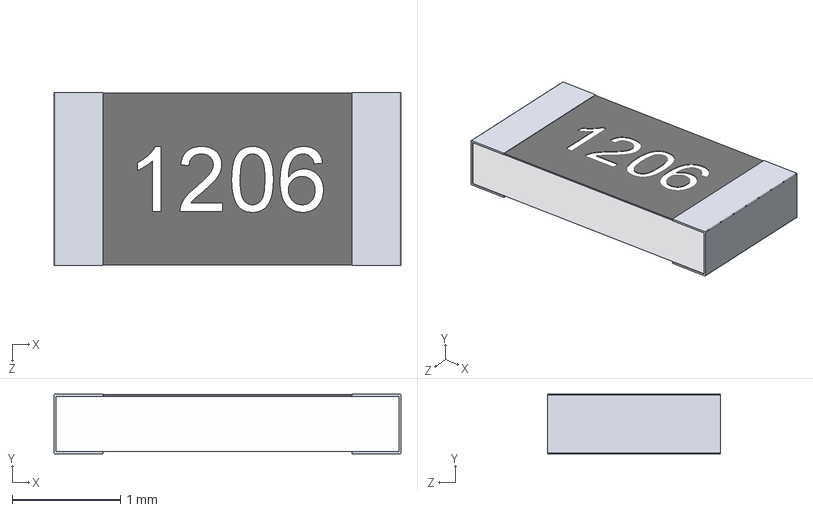
[picture p118: CAD file, 2025-06-22]
MyLibKiCad/3D/RES 1206.STEP
3.20 x 0.55 x 1.60 mm
1206 BODY
1206 PAD x 2
1206 OPIS
