kfirmaymon84/KiCadLib/MyLibKiCad/3D/R75-3W.step

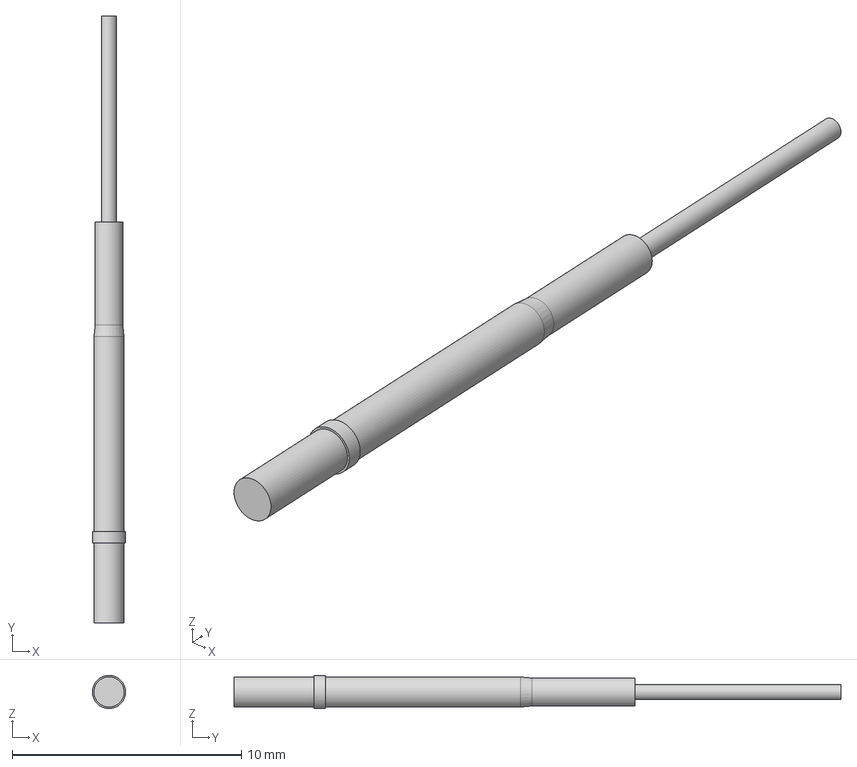
[picture p119: CAD file, 2025-06-22]
MyLibKiCad/3D/R75-3W.step
1.45 x 26.5 x 1.45 mm
