kfirmaymon84/KiCadLib/MyLibKiCad/3D/IND_0806.step

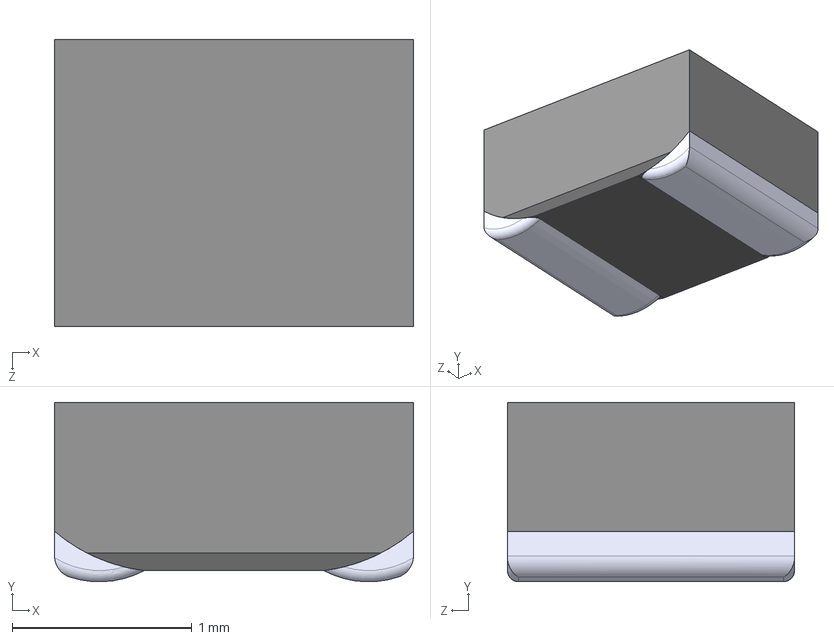
[picture p120: CAD file, 2025-06-22]
MyLibKiCad/3D/IND_0806.step
2.00 x 1 x 1.60 mm
