kfirmaymon84/KiCadLib/MyLibKiCad/3D/TO-277.step

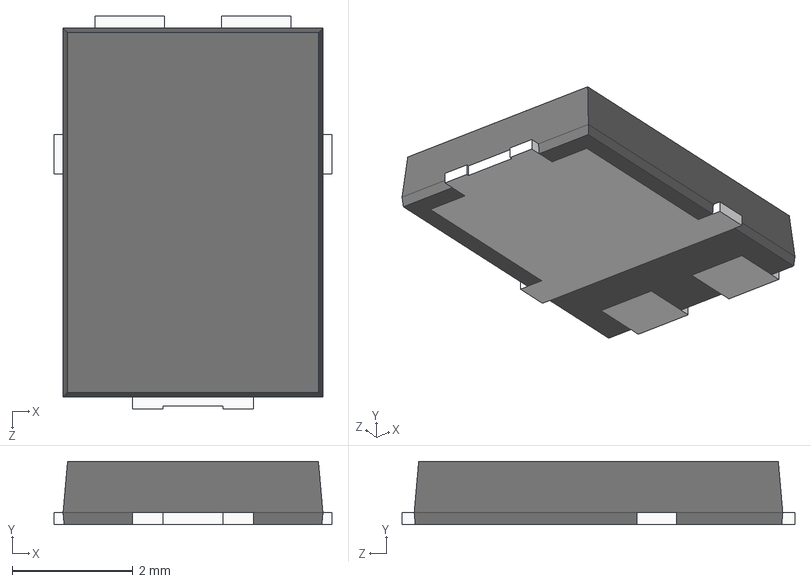
[picture p121: CAD file, 2025-06-22]
MyLibKiCad/3D/TO-277.step
4.60 x 1.05 x 6.50 mm
