kfirmaymon84/KiCadLib/MyLibKiCad/3D/simCardConn3d.step

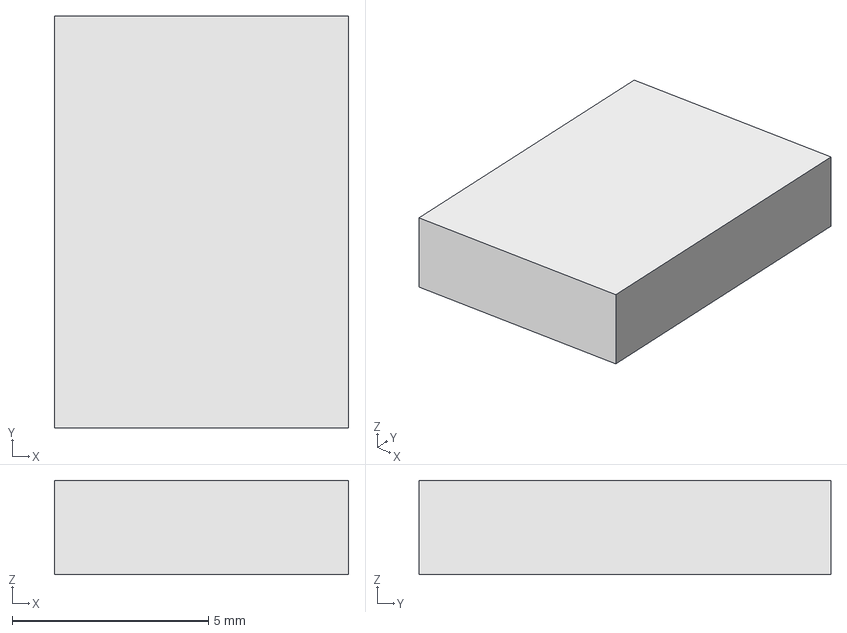
[picture p122: CAD file, 2025-06-22]
MyLibKiCad/3D/simCardConn3d.step
7.50 x 10.5 x 2.40 mm
