kfirmaymon84/KiCadLib/MyLibKiCad/3D/8SOIC_EP.step

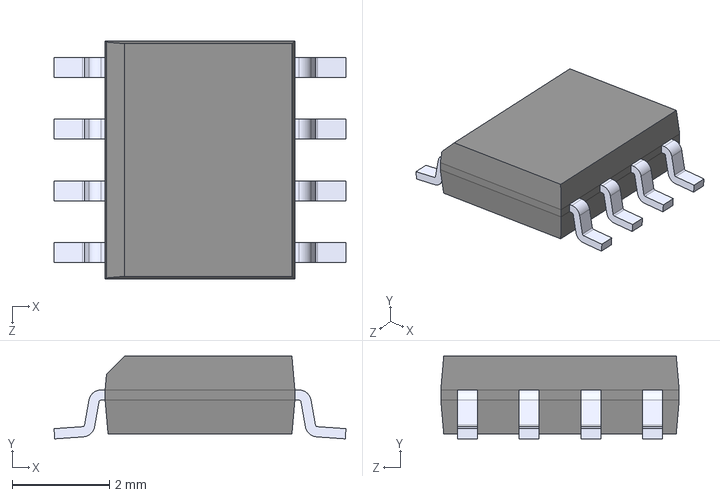
[picture p123: CAD file, 2025-06-22]
MyLibKiCad/3D/8SOIC_EP.step
6.00 x 1.70 x 4.90 mm
