kfirmaymon84/KiCadLib/MyLibKiCad/3D/6-son.step

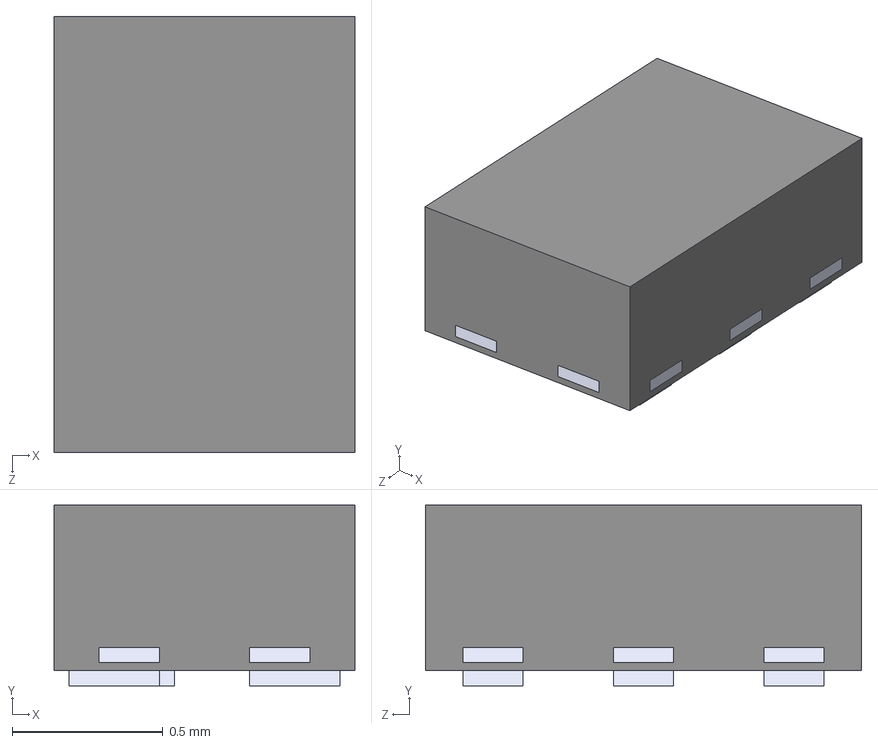
[picture p124: CAD file, 2025-06-22]
MyLibKiCad/3D/6-son.step
1.00 x 0.6 x 1.45 mm
