kfirmaymon84/KiCadLib/MyLibKiCad/3D/38-PowerWFQFN.step

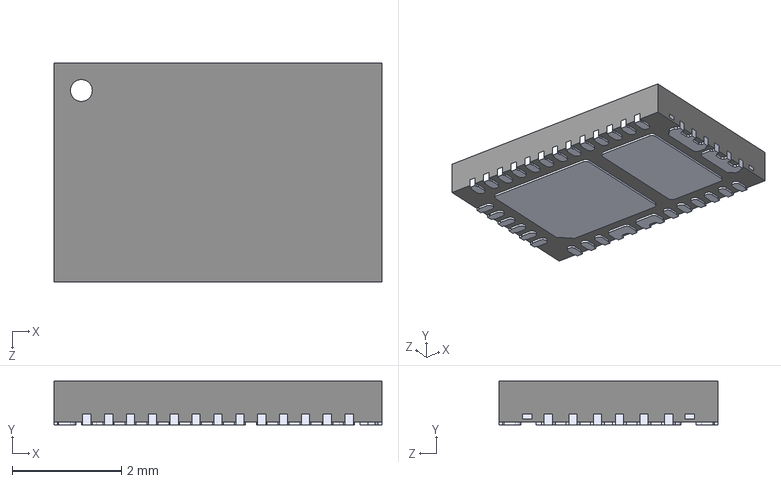
[picture p125: CAD file, 2025-06-22]
MyLibKiCad/3D/38-PowerWFQFN.step
6.00 x 0.8 x 4.00 mm
