kfirmaymon84/KiCadLib/MyLibKiCad/3D/DF40B(2.0)-12DS-0.4V(51)--3DModel-STEP-1.STEP

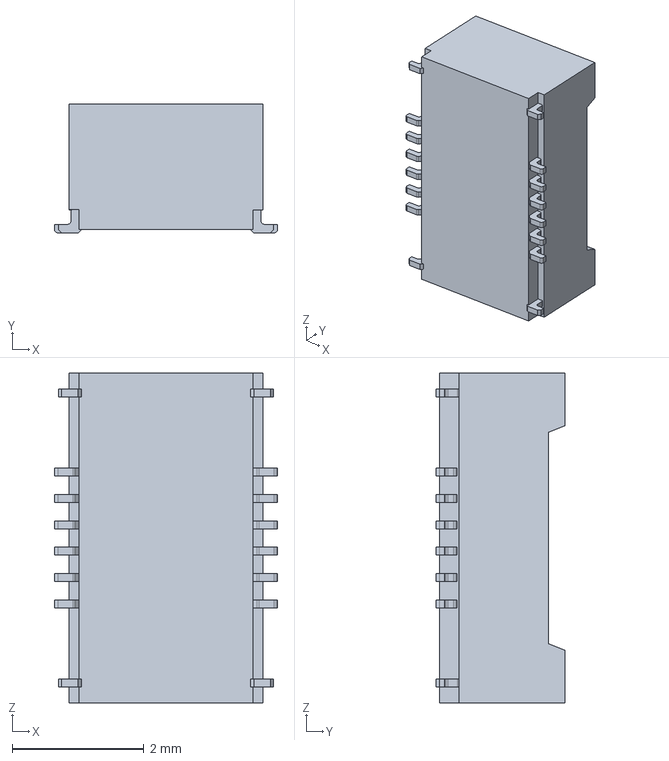
[picture p126: CAD file, 2025-06-22]
MyLibKiCad/3D/DF40B(2.0)-12DS-0.4V(51)--3DModel-STEP-1.STEP
3.38 x 1.95 x 5.00 mm
