kfirmaymon84/KiCadLib/MyLibKiCad/3D/16-QFN.stp

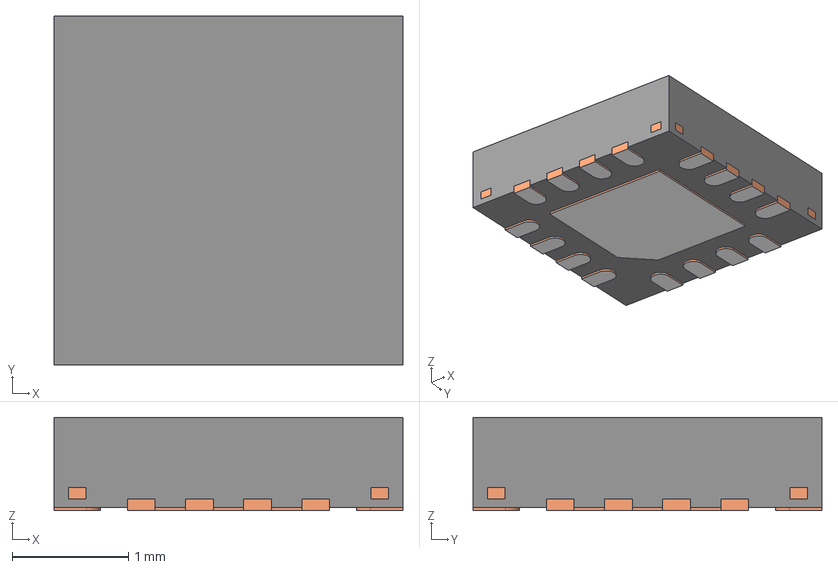
[picture p127: CAD file, 2025-06-22]
MyLibKiCad/3D/16-QFN.stp
3.00 x 3.00 x 0.8 mm
BODY-QFN
FRAME-RTE0016C
PIN1-ID
