kfirmaymon84/KiCadLib/MyLibKiCad/3D/SOD-123_DiodesInc.step

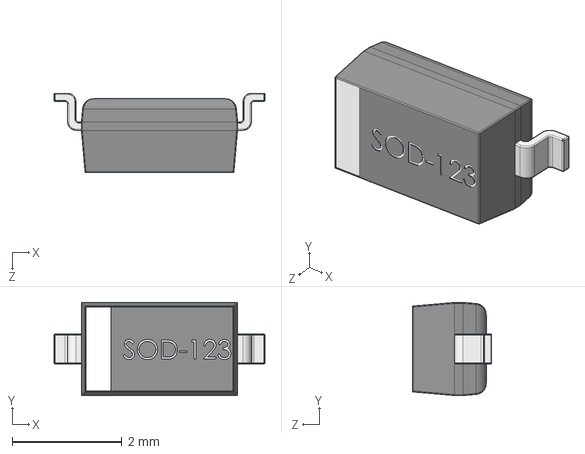
[picture p128: CAD file, 2025-06-22]
MyLibKiCad/3D/SOD-123_DiodesInc.step
3.85 x 1.70 x 1.45 mm
