kfirmaymon84/KiCadLib/MyLibKiCad/3D/ZX62M-B-5P-30---3DModel-STEP-1.STEP

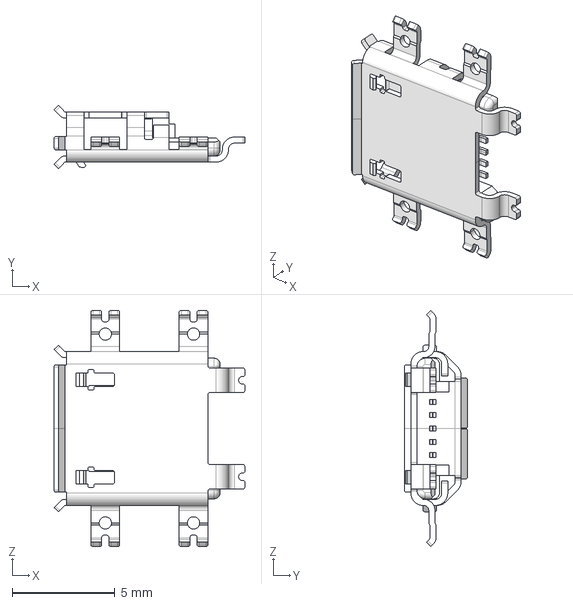
[picture p129: CAD file, 2025-06-22]
MyLibKiCad/3D/ZX62M-B-5P-30---3DModel-STEP-1.STEP
9.29 x 3.08 x 11.5 mm
