kfirmaymon84/KiCadLib/MyLibKiCad/3D/ESP32-WROOM-32E__4MB_.step

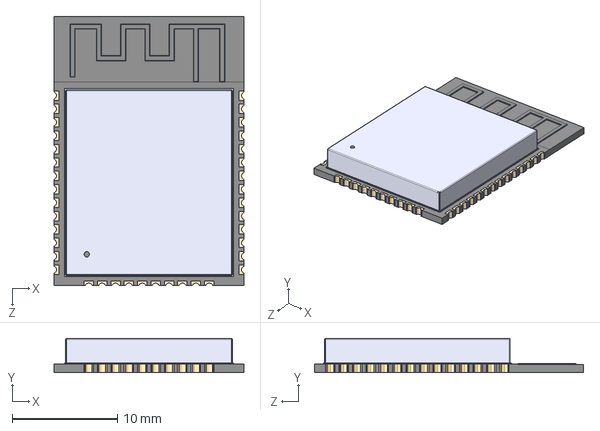
[picture p130: CAD file, 2025-06-22]
MyLibKiCad/3D/ESP32-WROOM-32E__4MB_.step
18.0 x 3.25 x 25.5 mm
