kfirmaymon84/KiCadLib/MyLibKiCad/3D/12-SON (2.5x4).stp

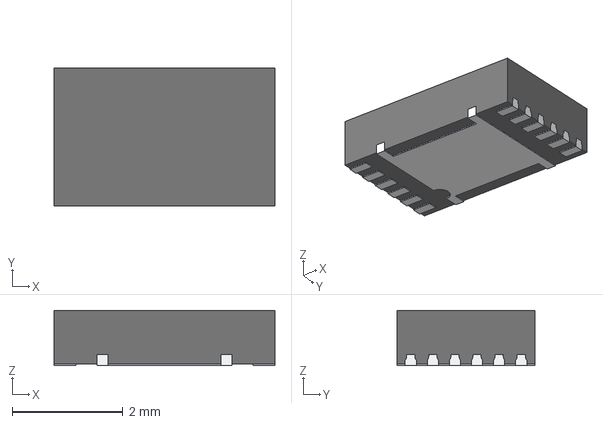
[picture p131: CAD file, 2025-06-22]
MyLibKiCad/3D/12-SON (2.5x4).stp
4.00 x 2.50 x 1.00 mm
FRAME
MOLD
