kfirmaymon84/KiCadLib/MyLibKiCad/3D/ROE-0512S.stp

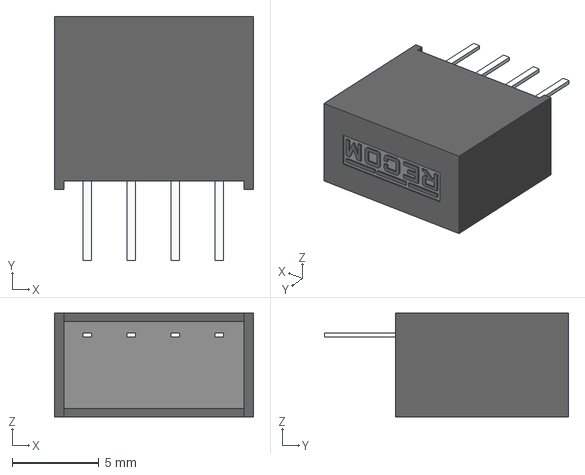
[picture p132: CAD file, 2025-06-22]
MyLibKiCad/3D/ROE-0512S.stp
11.5 x 14.1 x 6.00 mm
