kfirmaymon84/KiCadLib/MyLibKiCad/3D/sot23-1.step

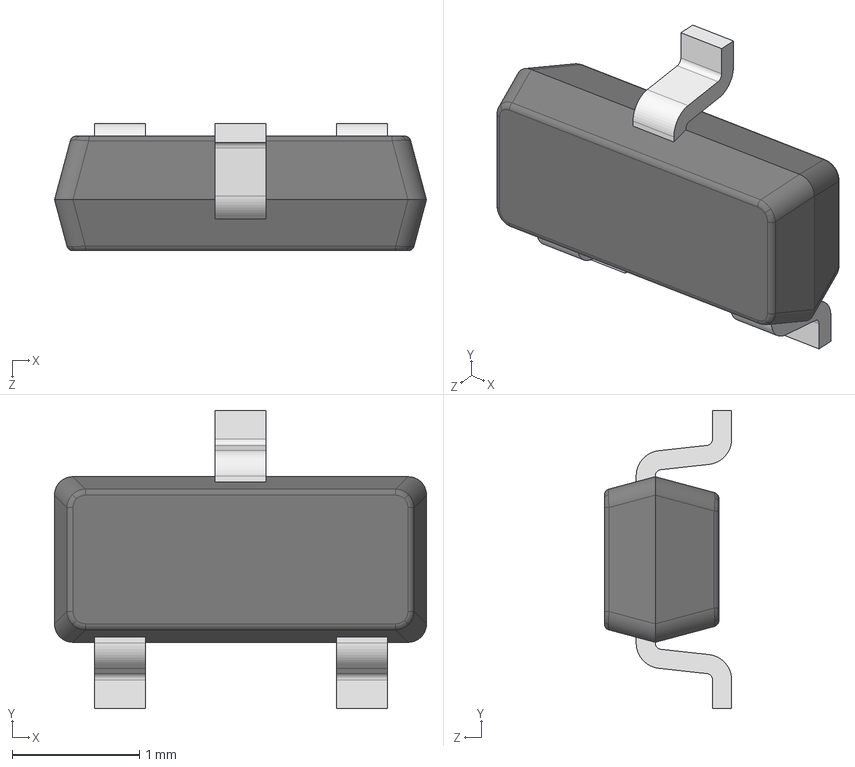
[picture p133: CAD file, 2025-06-22]
MyLibKiCad/3D/sot23-1.step
2.92 x 2.34 x 1.00 mm
