kfirmaymon84/KiCadLib/MyLibKiCad/3D/8-TSSOP.step

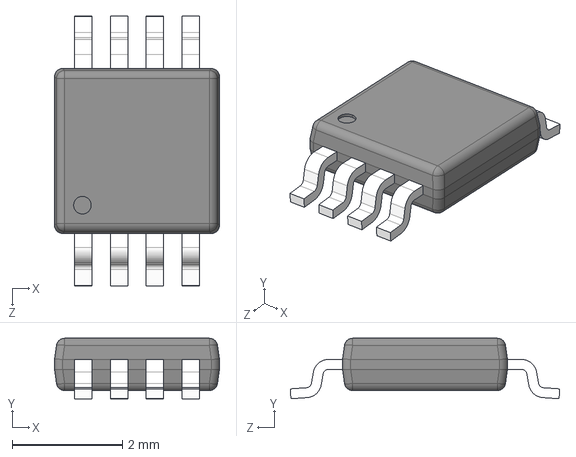
[picture p134: CAD file, 2025-06-22]
MyLibKiCad/3D/8-TSSOP.step
3.00 x 1.10 x 4.90 mm
