kfirmaymon84/KiCadLib/MyLibKiCad/3D/ANNA-B112--3DModel-STEP-56544.STEP

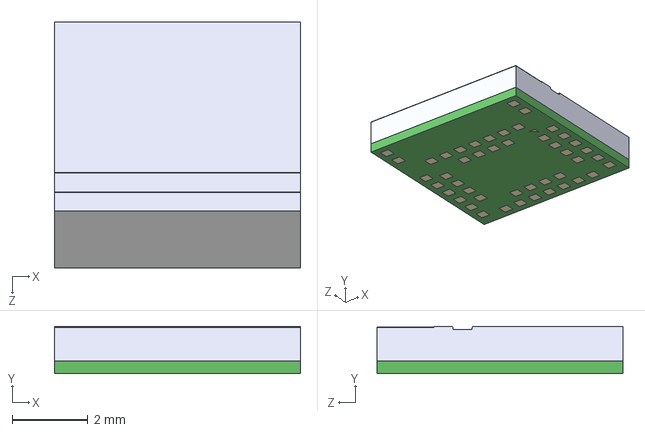
[picture p135: CAD file, 2025-06-22]
MyLibKiCad/3D/ANNA-B112--3DModel-STEP-56544.STEP
6.50 x 1.25 x 6.50 mm
