kfirmaymon84/KiCadLib/MyLibKiCad/3D/VCNL36828P.stp

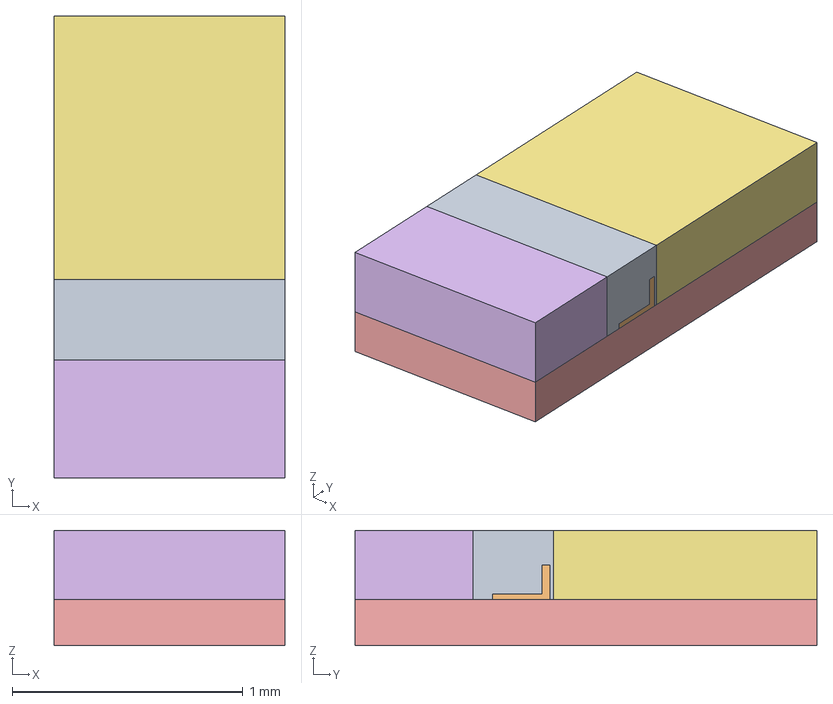
[picture p136: CAD file, 2025-06-22]
MyLibKiCad/3D/VCNL36828P.stp
1.00 x 2.00 x 0.5 mm
MSBR-7
MSBR-6
MSBR-5
MSBR-4
MSBR-3
MSBR-2
MSBR-1
_VCNL36828P
