kfirmaymon84/KiCadLib/MyLibKiCad/3D/3220-14-0300-00.step

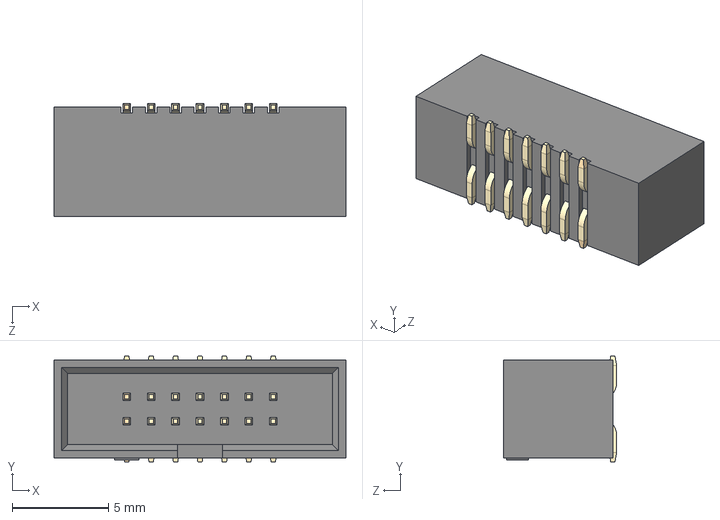
[picture p137: CAD file, 2025-06-22]
MyLibKiCad/3D/3220-14-0300-00.step
15.2 x 5.50 x 5.90 mm
