kfirmaymon84/KiCadLib/MyLibKiCad/3D/NANOSMDC110F-2.stp

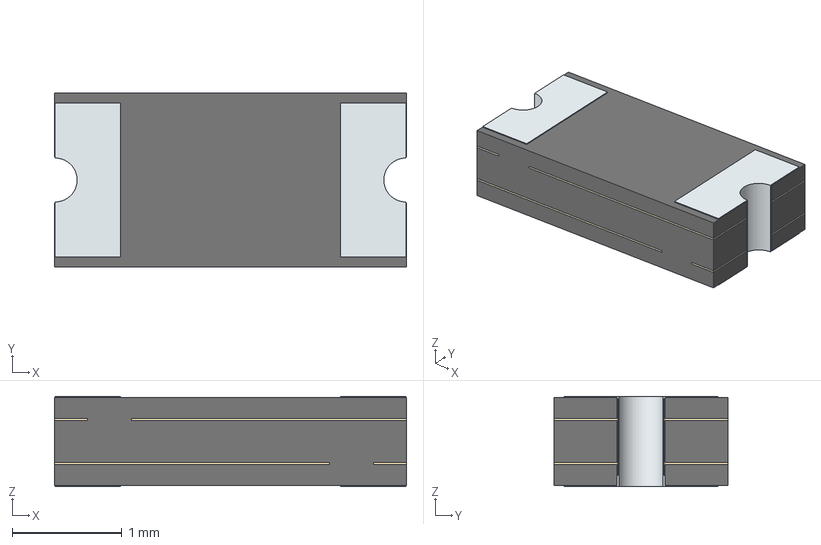
[picture p138: CAD file, 2025-06-22]
MyLibKiCad/3D/NANOSMDC110F-2.stp
3.20 x 1.58 x 0.82 mm
Intersect
Terminal
