kfirmaymon84/KiCadLib/MyLibKiCad/3D/BatteryConnSpacer.step

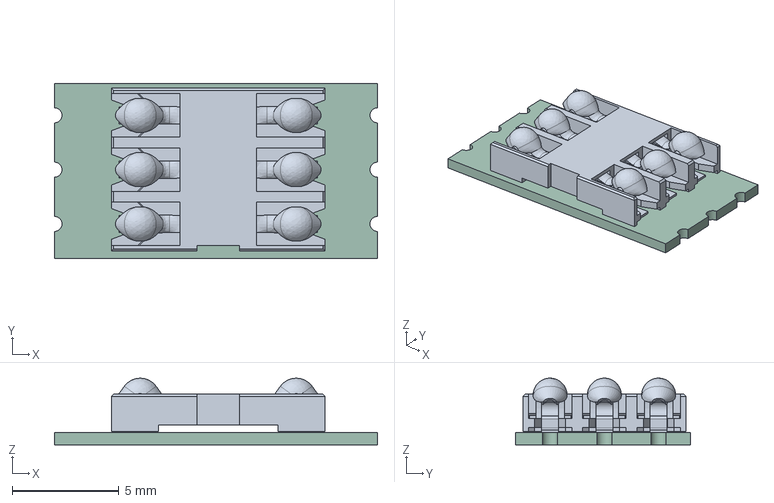
[picture p139: CAD file, 2025-06-22]
MyLibKiCad/3D/BatteryConnSpacer.step
15.1 x 8.20 x 3.13 mm
BatteryConnSpacer PCB
