kfirmaymon84/KiCadLib/MyLibKiCad/3D/USB4125-GF-A-0190_REVA2.step

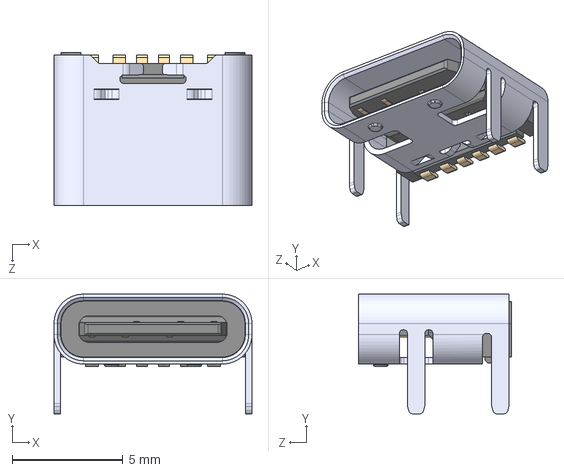
[picture p140: CAD file, 2025-06-22]
MyLibKiCad/3D/USB4125-GF-A-0190_REVA2.step
8.94 x 5.41 x 6.90 mm
