kfirmaymon84/KiCadLib/MyLibKiCad/3D/35RAPC4BHN2.step

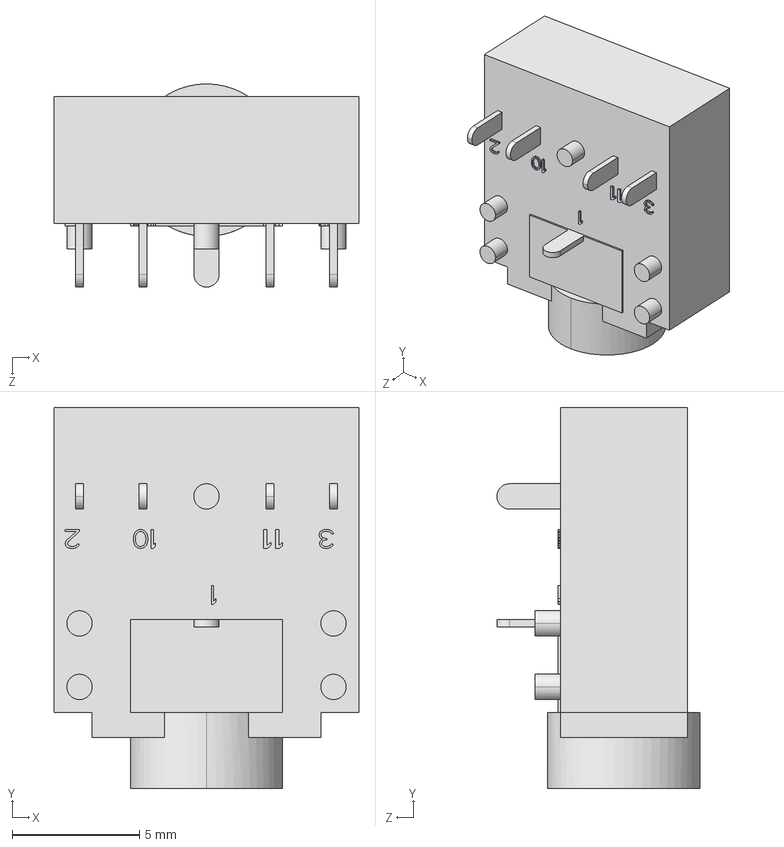
[picture p141: CAD file, 2025-06-22]
MyLibKiCad/3D/35RAPC4BHN2.step
12.0 x 15.0 x 8.00 mm
