kfirmaymon84/KiCadLib/MyLibKiCad/3D/SOD-523F.step

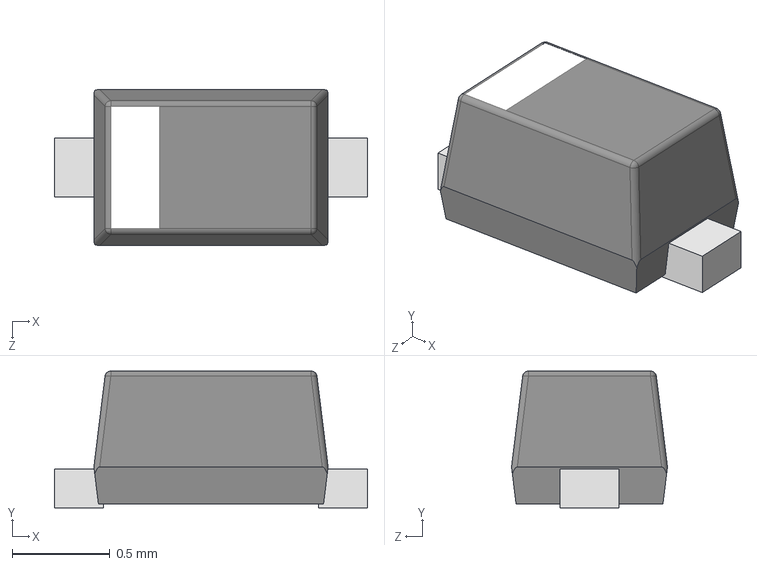
[picture p142: CAD file, 2025-06-22]
MyLibKiCad/3D/SOD-523F.step
1.60 x 0.7 x 0.798 mm
