kfirmaymon84/KiCadLib/MyLibKiCad/3D/Coilcraft-XFL4015.step

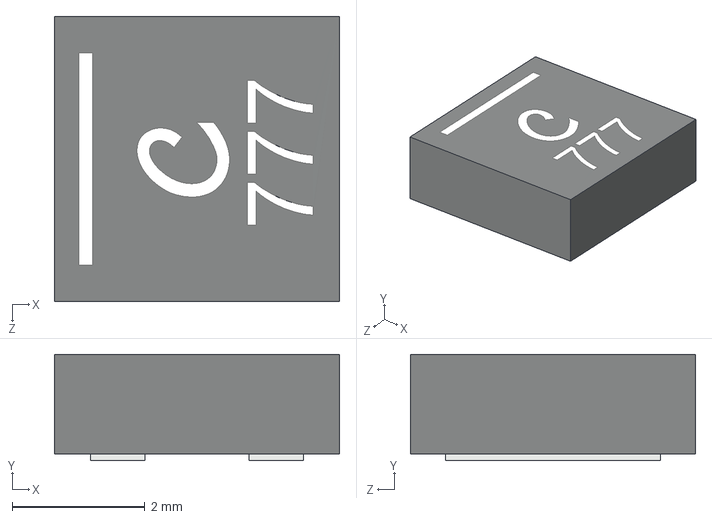
[picture p143: CAD file, 2025-06-22]
MyLibKiCad/3D/Coilcraft-XFL4015.step
4.30 x 1.60 x 4.30 mm
