kfirmaymon84/KiCadLib/MyLibKiCad/3D/10_WFDFN EP 3x2.stp

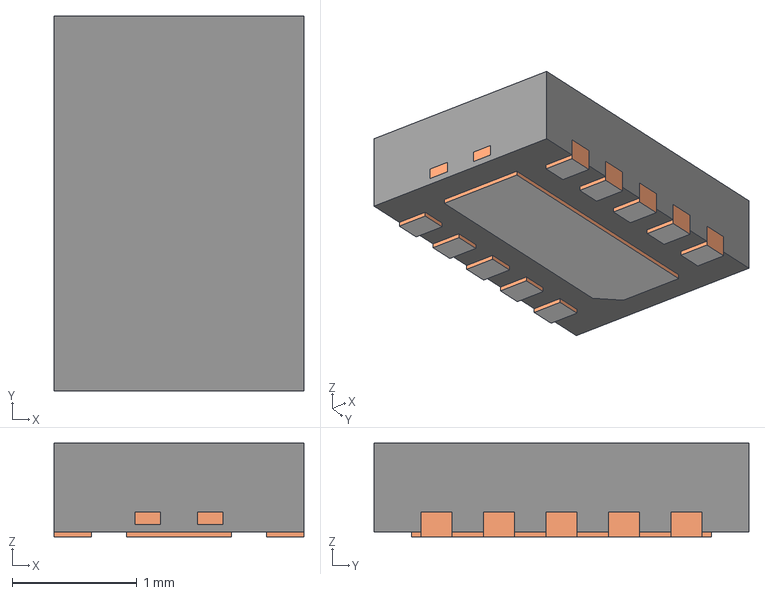
[picture p144: CAD file, 2025-06-22]
MyLibKiCad/3D/10_WFDFN EP 3x2.stp
2.00 x 3.00 x 0.75 mm
MOLD-DQC0010A
FRAME-DQC0010A
