kfirmaymon84/KiCadLib/MyLibKiCad/3D/DO-214AA.step

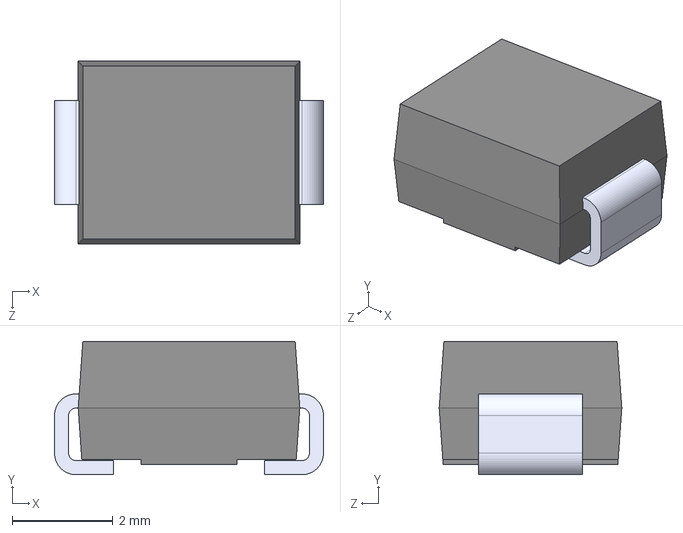
[picture p145: CAD file, 2025-06-22]
MyLibKiCad/3D/DO-214AA.step
5.34 x 2.65 x 3.62 mm
