kfirmaymon84/KiCadLib/MyLibKiCad/3D/CUI_DEVICES_CMT-4023S-SMT-TR.step

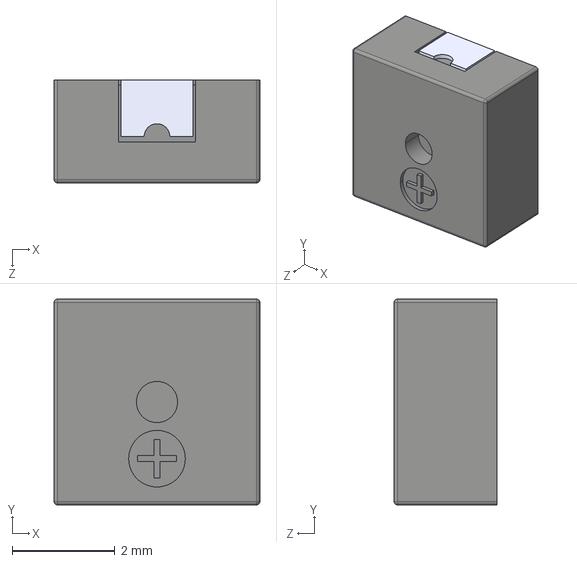
[picture p146: CAD file, 2025-06-22]
MyLibKiCad/3D/CUI_DEVICES_CMT-4023S-SMT-TR.step
4.00 x 4.00 x 2.00 mm
