kfirmaymon84/KiCadLib/(list of files, cad)

Other CAD files:
MyLibKiCad/3D/LED_0603_B.STEP
MyLibKiCad/3D/5-TSSOP, SC-70-5, SOT-353.STEP
MyLibKiCad/3D/8-SON3x3.step
MyLibKiCad/3D/R75-2W.step
MyLibKiCad/3D/0.169 L x 0.169 W (4.30mm x 4.30mm).stp
MyLibKiCad/3D/009159006551906.stp
MyLibKiCad/3D/0532610471.step
MyLibKiCad/3D/10-UTQFN.step
MyLibKiCad/3D/10118192-0001LF.step
MyLibKiCad/3D/10132798-011100LF.STEP
MyLibKiCad/3D/10132798-021100LF.step
MyLibKiCad/3D/1054440011.step
MyLibKiCad/3D/12-WLCSP (1.56x1.4).step
MyLibKiCad/3D/12402012E212A.step
MyLibKiCad/3D/1264EY-100M_P3.step
MyLibKiCad/3D/1313210530000 v1.step
MyLibKiCad/3D/1313210530000.step
MyLibKiCad/3D/20-DSBGA (2).step
MyLibKiCad/3D/20-DSBGA.STEP
MyLibKiCad/3D/20-TQFN4x4.step
MyLibKiCad/3D/20-TSSOP.step
MyLibKiCad/3D/20-UFQFPN(3x3).step
MyLibKiCad/3D/20-VQFN (3x3).step
MyLibKiCad/3D/20021521-00010T1LF.step
MyLibKiCad/3D/20279-001E-03.step
MyLibKiCad/3D/2082940040.stp
MyLibKiCad/3D/2169890001.step
MyLibKiCad/3D/2328702-4.stp
MyLibKiCad/3D/2328702-6.step
MyLibKiCad/3D/440054-4.step
MyLibKiCad/3D/470191802 SIM CONN 1.8MM.stp
MyLibKiCad/3D/530470310.step
MyLibKiCad/3D/6 Pins Sim Connector 1.STEP
MyLibKiCad/3D/6-DSBGA.step
MyLibKiCad/3D/6-WSON (2x2).STEP
MyLibKiCad/3D/6-son 2x2 ep .step
MyLibKiCad/3D/61200621621.step
MyLibKiCad/3D/61201021621.stp
MyLibKiCad/3D/676433910.stp
MyLibKiCad/3D/687130149022.stp
MyLibKiCad/3D/687132149022.stp
MyLibKiCad/3D/781710004.step
MyLibKiCad/3D/8-WSON (2x2).step
MyLibKiCad/3D/8_SOIC.step
MyLibKiCad/3D/B3B-XH-A-LF--SN---3DModel-STEP-418109.STEP
MyLibKiCad/3D/CAP 0603-2.step
MyLibKiCad/3D/CAP 0805.step
MyLibKiCad/3D/CFPX-217.stp
MyLibKiCad/3D/CN2100008 Double Row 5 Pin Mag. Connector Male (HTP-CON-M413-M).STEP
MyLibKiCad/3D/CN2100009 Double Row 5 Pin Mag. Connector Female (HTP-CON-M413F160).STEP
MyLibKiCad/3D/CN2100027 SIM CARD 6P CONNECTOR 3.0H.STEP
MyLibKiCad/3D/CST3C_z90.stp
MyLibKiCad/3D/CUW_Y3SH.B2-GFJD-5J6T-Z242-Z.stp
MyLibKiCad/3D/DC-002-2.0A-1.3.stp
MyLibKiCad/3D/DSBGA8-YBG_TEX.step
MyLibKiCad/3D/DSBGA9-YZF_TEX.step
MyLibKiCad/3D/EE_SX1350.step
MyLibKiCad/3D/ESP32-C6-MINI-1-N4.step
MyLibKiCad/3D/FB_0402_1005.STEP
MyLibKiCad/3D/G5V_1.step
MyLibKiCad/3D/HE3621A0500.stp
MyLibKiCad/3D/HTP-CON-M413-M.step
MyLibKiCad/3D/IND 0805.step
MyLibKiCad/3D/IND 1008.STEP
MyLibKiCad/3D/IND_1008.STEP
MyLibKiCad/3D/IND_1210.step
MyLibKiCad/3D/IND_3015(3x3mm).stp
MyLibKiCad/3D/K3D-DX07S024JA2-V1_JAE_Proprietary.STEP
MyLibKiCad/3D/M20-7810945R.stp
MyLibKiCad/3D/PC2100011 USB-A Plug_PCB_Rev.V1.STEP
MyLibKiCad/3D/PE014005.stp
MyLibKiCad/3D/PJ-083BH.step
MyLibKiCad/3D/RES 0201.STEP
MyLibKiCad/3D/RES 0402.step
MyLibKiCad/3D/S3B-XH-SM4-TB.STEP
MyLibKiCad/3D/SC-70-5.stp
MyLibKiCad/3D/SC70-6_MC_MCH.step
MyLibKiCad/3D/SFW10R-3STE1LF.STEP
MyLibKiCad/3D/SJ1-3515N.step
MyLibKiCad/3D/SOT-563-6L_463A-01_ONS.step
MyLibKiCad/3D/SRP1038A-6R8M.stp
MyLibKiCad/3D/STP_436333033816_rev1.stp
MyLibKiCad/3D/TE034003-1.step
MyLibKiCad/3D/TW133TIG01.STEP
MyLibKiCad/3D/USB4715-GF-A_REVA.step
MyLibKiCad/3D/VCNL36825T.STEP
MyLibKiCad/3D/X2SON 0_4mm.STEP
MyLibKiCad/3D/nona SMD075F.step
MyLibKiCad/3D/ptc06032-1.step
