kfirmaymon84/KiCadLib/(commit log)

2025-06-22 remove unessery files
    [BOM Tamplate.xlsx]
2025-07-07 Update all libs with sim bug.
    [IND2520.stp]
2025-07-14 Add parts
    [61201021621.stp, Hotkey_List.xlsx, KW_HHL631.TK-6SSB-6L07M0-2686.stp, UM232R.step, VCNL36826S.stp]
2025-10-23 add kikit runner and update parts
    [10-VQFN-HR (2x2).step, 20-WQFN (4x3).step, 2328702-6.step]
