kfirmaymon84/KiCadLib/(notices)

Notices in the files:
MyLibKiCad/3D/FFC2B28-14-G.stp:
author */ ('License CC BY-ND 4.0'),
